Focerqc/QFBMS/exports/README.md

# Generated outputs

Regenerate previews and ERC/DRC reports from the current KiCad files here. Outputs are ignored; old exports were archived locally during migration.
