Focerqc/QFBMS/docs/bq-iso-i2c-2026-11-03.md

# Upper I2C isolation schematic increment — November 3, 2026

Charge-only schematic increment for the ISO1640 upper-I2C barrier. The host-side disconnect is PENDING; the [repair note](bq-repair-2026-11-03.md) supersedes the original connectivity claims. Discharge protection is out of scope. There is no heatsink. This pass stops at the isolation sheet. The next package resolves the pending disconnect and address-verification contract; ESP32, host power and charge switching remain later increments. Do not draw a charge FET, USB, or CAN device here.

`qfbms32.kicad_pcb`, `qfbms32.kicad_sch`, and `qfbms32.kicad_pro` were not modified. No netlist was imported, no historical generator was run, and no zones were refilled. Sheets were regenerated from `_tools/gen_bq_monitor_sheets.py` with its tracked identity manifest.

## Files

Open `qfbms32-bq-monitors.kicad_pro`.

- `qfbms32-bq-monitors.kicad_sch` — root sheet with lower monitor, upper monitor, and upper I2C isolation.
- `qfbms32-bq-lower.kicad_sch` — lower monitor, `U_BQ1`, reference `CELL0`.
- `qfbms32-bq-upper.kicad_sch` — upper monitor, `U_BQ2`, reference `CELL16`.
- `qfbms32-bq-iso-i2c.kicad_sch` — this isolation sheet.

## ISO1640 pin map

`U_ISO` uses the ISO1640 8-pin D pin map from TI ISO1640 datasheet Table 5-1. It has no enable pin. The orderable suffix stays OPEN. Do not switch the symbol to the 16-DW pinout.

| Pin | Name | Domain |
| --- | --- | --- |
| 1 | VCC1 | Host side. Net `HOST_3V3`. |
| 2 | SDA1 | Isolator side of missing disconnect: `SDA_ISO_PENDING`. |
| 3 | SCL1 | Isolator side of missing disconnect: `SCL_ISO_PENDING`. |
| 4 | GND1 | `CELL0`. |
| 5 | GND2 | `CELL16`. |
| 6 | SCL2 | Upper BQ bus `SCL_BQ2`. |
| 7 | SDA2 | Upper BQ bus `SDA_BQ2`. |
| 8 | VCC2 | Upper REG1, brought out as `REG1_BQ2`. |

Side 1 faces the host (80 pF max). Side 2 faces the upper BQ bus (400 pF max). Each supply has its own 100 nF to its own ground, per ISO1640 section 9.2.1 (`C201` on `HOST_3V3`/`CELL0`, `C202` on `REG1_BQ2`/`CELL16`).

**CELL0 and CELL16 are not joined.** Do not join any upper net to lower SRP or SRN. GND1 is `CELL0`. GND2 is `CELL16`.

## GPIO9 reset and switch truth table

`R203` pulls `GPIO9` up to `HOST_3V3`. Value OPEN. `GPIO9` must be high at reset because GPIO9 low selects ESP32-C3 download mode. The ESP32 driver itself is a later sheet; this pull-up has to hold the net without it.

The two-terminal SPST placeholders were removed: they had no control pins. SDA_HOST and SCL_HOST end at visibly PENDING open stubs. SDA_ISO_PENDING and SCL_ISO_PENDING reach ISO1640 pins 2/3, respectively. Fresh XML proves separation on both paths. Upper communication is unavailable in this increment.

GPIO9 only reaches R203. No switch truth table is implemented. High=open / low=connected remains a future requirement, with manufacturer-verified pinout, powered-off isolation and 100 kHz suitability. Pull-ups on both disconnect sides, combined sink current, rise time and power sequencing remain OPEN.

The supplied C code logs a failed lower-address write and still drives GPIO9 low. A maintained adaptation must require successful lower communication at 0x10 before upper 0x08 admission, and handle repeated GPIO9 gating from Lisp. Supplied source is preserved.

Upper SDA and SCL pull-ups stay on the upper monitor sheet (`R120`, `R121` to `REG1_BQ2`). Side-1 pull-ups are on this sheet (`R201`, `R202` to `HOST_3V3`), value OPEN.

## ALERT_BQ2

`ALERT_BQ2` is brought onto the isolation sheet and stays on the upper side. The stub ends at an explicit no-connect. It is not tied to `CELL0`. Firmware does not consume upper ALERT. A unidirectional isolator for it stays OPEN; do not invent that part or conduct ALERT across the barrier.

## ERC

KiCad 10.0.6:

```text
kicad-cli sch erc --severity-all --format json --output exports/bq-iso-erc.json qfbms32-bq-monitors.kicad_sch
```

Historical pre-repair result: 41 warnings, zero errors. Current result: 43 warnings, zero errors, adding two unconnected-wire-endpoint warnings for the PENDING host stubs. See [repair verification](bq-repair-2026-11-03.md). The breakdown below records the historical baseline.

| Sheet | Warnings |
| --- | ---: |
| Root | 33 |
| Lower monitor | 3 |
| Upper monitor | 5 |
| Upper I2C isolation | 0 |

Warning classes:

- 30 `isolated_pin_label`. `CELL1`–`CELL15` and `CELL17`–`CELL31` each connect to one filter resistor. The harness is not part of this increment. `ALERT_BQ2` no longer appears in this class after the isolation-sheet no-connect was regenerated.
- 8 `pin_to_pin`. CFETOFF, DFETOFF, DDSG, and on the upper sheet also HDQ and DCHG, are tied to the local reference. The power flag that drives that reference is a power output, so ERC reports a bidirectional pin on a power-output net. The tie is the Table 16-3 unused-pin termination.
- 3 `lib_symbol_issues`. Embedded `qfbms:BQ7695202PFB` and `qfbms:ISO1640_D8` symbols. The project symbol library table has no `qfbms` entry. The symbols are stored in the sheets.

Ignored ERC checks in this KiCad configuration, not run as failures: single global label, four-way junction, SPICE model issue, and footprint-filter mismatch.

## OPEN items

A value is OPEN when the datasheet or the firmware interface does not fix it. No MPN was selected for any part invented on this sheet.

| Reference | What is open |
| --- | --- |
| U_ISO | ISO1640 orderable suffix. The 8-D pin map is fixed. The 16-DW package is not this symbol. |
| Missing SDA disconnect | PENDING; SPST removed. Verified device, control pinout, footprint, powered-off isolation and timing required. |
| Missing SCL disconnect | PENDING; same requirements as SDA. |
| R201 | Side-1 SDA pull-up to `HOST_3V3`. Resistance at 100 kHz. |
| R202 | Side-1 SCL pull-up to `HOST_3V3`. Resistance at 100 kHz. |
| R203 | GPIO9 reset pull-up to `HOST_3V3`. Value. |
| ALERT_BQ2 | Unidirectional isolator across the barrier. MPN is OPEN; do not invent it. The upper-side stub is terminated with a no-connect. |
| HOST_3V3 | Host 3.3 V rail. Driven on the later ESP32 / regulator sheet. |
| GPIO9 | Driven by the later ESP32 sheet. Held high here by R203 until then. |

## Working-file hashes after this pass

SHA-256 of the untouched working board files (must remain unchanged by this increment):

```text
44045B287D223FA48AD0C9864A69A794FBC2407EDBB3922745E9A5B46DB71E8E  qfbms32.kicad_pcb
C8B17E5AA0936D8FFA2D0C3B4535BE0B898064DC0976F2ABD4436C4A3B704603  qfbms32.kicad_sch
0F84F61398BD25215ADA1A9C53ABE8C4E0F80B3B613C16E2D02F656B900CFED2  qfbms32.kicad_pro
```
