Focerqc/QFBMS/docs/review-2026-11-04/main-reconciliation.md

# Main schematic reconciliation

Read-only XML from the main schematic. Pin numbers refer to symbols, not inferred PCB pads.
Both BQs match by reference and role. Each line gives monitor and main peer sets including the pin itself. Different filter reference names require mapping through the actual cell index before migration.
Main Q1 is a power-switch reference collision, not the monitor preregulator. U205 is a logical host port, not a package.
Monitor references absent by name in main: C1, C10, C101, C102, C103, C104, C105, C106, C107, C108, C109, C11, C110, C111, C112, C113, C114, C115, C116, C117, C118, C119, C12, C120, C121, C122, C13, C14, C15, C16, C17, C18, C19, C2, C20, C201, C202, C203, C21, C22, C23, C3, C4, C5, C6, C7, C8, C9, D1, D101, D102, D2, Q101, R1, R10, R101, R102, R103, R104, R105, R106, R107, R108, R109, R11, R110, R111, R112, R113, R114, R115, R116, R117, R118, R119, R12, R120, R121, R122, R123, R124, R13, R14, R15, R16, R17, R18, R19, R2, R20, R201, R202, R203, R21, R22, R23, R24, R25, R26, R27, R28, R29, R3, R30, R31, R4, R5, R6, R7, R8, R9, RT1, RT2, RT3, RT4, RT5, R_SH, U204, U205, U_ISO
Map R_F and C_F cell-by-cell. Add admission, isolation, local supplies, decoupling, TS2 ports and independent upper current ties only after review. Keep physical harness/bleed placement fixed.
Main joins both BQ grounds, SDA, SCL, SRP and SRN across domains. Separate those nets and supply returns. Preserve genuine NC pin intent. Reconcile the main BQ exposed pads against the footprint separately.

## U_BQ1
- U_BQ1.1 (review differing peers) — draft /Lower monitor/VCF15 [C1.2 C2.1 R16.2 U_BQ1.1]; main /BQ1_VC15 [C_F15.2 C_F16.1 R_F18.1 U_BQ1.1]
- U_BQ1.2 (review differing peers) — draft /Lower monitor/VCF14 [C2.2 C3.1 R15.2 U_BQ1.2]; main /BQ1_VC14 [C_F14.2 C_F15.1 R_F19.1 U_BQ1.2]
- U_BQ1.3 (review differing peers) — draft /Lower monitor/VCF13 [C3.2 C4.1 R14.2 U_BQ1.3]; main /BQ1_VC13 [C_F13.2 C_F14.1 R_F20.1 U_BQ1.3]
- U_BQ1.4 (review differing peers) — draft /Lower monitor/VCF12 [C4.2 C5.1 R13.2 U_BQ1.4]; main /BQ1_VC12 [C_F12.2 C_F13.1 R_F21.1 U_BQ1.4]
- U_BQ1.5 (review differing peers) — draft /Lower monitor/VCF11 [C5.2 C6.1 R12.2 U_BQ1.5]; main /BQ1_VC11 [C_F11.2 C_F12.1 R_F22.1 U_BQ1.5]
- U_BQ1.6 (review differing peers) — draft /Lower monitor/VCF10 [C6.2 C7.1 R11.2 U_BQ1.6]; main /BQ1_VC10 [C_F10.2 C_F11.1 R_F23.1 U_BQ1.6]
- U_BQ1.7 (review differing peers) — draft /Lower monitor/VCF9 [C7.2 C8.1 R10.2 U_BQ1.7]; main /BQ1_VC9 [C_F10.1 C_F9.2 R_F24.1 U_BQ1.7]
- U_BQ1.8 (review differing peers) — draft /Lower monitor/VCF8 [C8.2 C9.1 R9.2 U_BQ1.8]; main /BQ1_VC8 [C_F8.2 C_F9.1 R_F25.1 U_BQ1.8]
- U_BQ1.9 (review differing peers) — draft /Lower monitor/VCF7 [C10.1 C9.2 R8.2 U_BQ1.9]; main /BQ1_VC7 [C_F7.2 C_F8.1 R_F26.1 U_BQ1.9]
- U_BQ1.10 (review differing peers) — draft /Lower monitor/VCF6 [C10.2 C11.1 R7.2 U_BQ1.10]; main /BQ1_VC6 [C_F6.2 C_F7.1 R_F27.1 U_BQ1.10]
- U_BQ1.11 (review differing peers) — draft /Lower monitor/VCF5 [C11.2 C12.1 R6.2 U_BQ1.11]; main /BQ1_VC5 [C_F5.2 C_F6.1 R_F28.1 U_BQ1.11]
- U_BQ1.12 (review differing peers) — draft /Lower monitor/VCF4 [C12.2 C13.1 R5.2 U_BQ1.12]; main /BQ1_VC4 [C_F4.2 C_F5.1 R_F29.1 U_BQ1.12]
- U_BQ1.13 (review differing peers) — draft /Lower monitor/VCF3 [C13.2 C14.1 R4.2 U_BQ1.13]; main /BQ1_VC3 [C_F3.2 C_F4.1 R_F30.1 U_BQ1.13]
- U_BQ1.14 (review differing peers) — draft /Lower monitor/VCF2 [C14.2 C15.1 R3.2 U_BQ1.14]; main /BQ1_VC2 [C_F2.2 C_F3.1 R_F31.1 U_BQ1.14]
- U_BQ1.15 (review differing peers) — draft /Lower monitor/VCF1 [C15.2 C16.1 R2.2 U_BQ1.15]; main /BQ1_VC1 [C_F1.2 C_F2.1 R_F32.1 U_BQ1.15]
- U_BQ1.16 (review differing peers) — draft /Lower monitor/VCF0 [C16.2 C17.1 R1.2 U_BQ1.16]; main /CELL0 [C_F1.1 J_BAT1.2 J_CELL1.10 R_SH1.1 U_BQ1.16]
- U_BQ1.17 (review differing peers) — draft CELL0 [C17.2 C18.2 C19.2 C20.2 C201.1 C203.1 C21.2 C22.2 R1.1 R19.2 R23.1 R25.1 RT1.2 RT2.2 RT3.2 RT4.2 RT5.2 R_SH.1 U204.1 U204.5 U_BQ1.17 U_BQ1.29 U_BQ1.30 U_BQ1.32 U_BQ1.49 U_ISO.4]; main /GND [C_SSR1.2 C_SSR2.2 J_T1.2 J_T2.2 J_T3.2 J_T4.2 R_SSR2.2 U_BQ1.17 U_BQ1.33 U_BQ2.17 U_BQ2.33 U_SSR1.4]
- U_BQ1.18 (review differing peers) — draft /Lower monitor/SRP_NET [C23.1 R25.2 U_BQ1.18]; main /SRP [U_BQ1.18 U_BQ2.18]
- U_BQ1.19 (same member set) — draft unconnected-(U_BQ1-NC-Pad19) [U_BQ1.19]; main unconnected-(U_BQ1-NC-Pad19) [U_BQ1.19]
- U_BQ1.20 (review differing peers) — draft /Lower monitor/SRN_NET [C23.2 R26.2 U_BQ1.20]; main /SRN [U_BQ1.20 U_BQ2.20]
- U_BQ1.21 (review differing peers) — draft /Lower monitor/TS1_NTC [R27.1 U_BQ1.21]; main /TS1 [J_T1.1 U_BQ1.21]
- U_BQ1.22 (review differing peers) — draft /Lower monitor/TS2_WAKE_BQ1 [U_BQ1.22]; main /TS2 [J_T2.1 U_BQ1.22]
- U_BQ1.23 (review differing peers) — draft /Lower monitor/TS3_NTC [R28.1 U_BQ1.23]; main /TS3 [J_T3.1 U_BQ1.23]
- U_BQ1.24 (review differing peers) — draft /Lower monitor/REG18 [C21.1 U_BQ1.24]; main unconnected-(U_BQ1-REG18-Pad24) [U_BQ1.24]
- U_BQ1.25 (review differing peers) — draft /Lower monitor/ALERT_NTC [R29.1 U_BQ1.25]; main unconnected-(U_BQ1-HDQ_IO/ALERT-Pad25) [U_BQ1.25]
- U_BQ1.26 (review differing peers) — draft /Lower monitor/SCL_BQ1 [R21.1 U_BQ1.26]; main /I2C_SCL [U_BQ1.26 U_BQ2.26]
- U_BQ1.27 (review differing peers) — draft /Lower monitor/SDA_BQ1 [R20.1 U_BQ1.27]; main /I2C_SDA [U_BQ1.27 U_BQ2.27 U_ESP1.21]
- U_BQ1.28 (review differing peers) — draft /Lower monitor/HDQ_NTC [R31.1 U_BQ1.28]; main unconnected-(U_BQ1-HDQ_IO/SPI_MOSI-Pad28) [U_BQ1.28]
- U_BQ1.29 (review differing peers) — draft CELL0 [C17.2 C18.2 C19.2 C20.2 C201.1 C203.1 C21.2 C22.2 R1.1 R19.2 R23.1 R25.1 RT1.2 RT2.2 RT3.2 RT4.2 RT5.2 R_SH.1 U204.1 U204.5 U_BQ1.17 U_BQ1.29 U_BQ1.30 U_BQ1.32 U_BQ1.49 U_ISO.4]; main unconnected-(U_BQ1-CFETOFF/SPI_CS-Pad29) [U_BQ1.29]
- U_BQ1.30 (review differing peers) — draft CELL0 [C17.2 C18.2 C19.2 C20.2 C201.1 C203.1 C21.2 C22.2 R1.1 R19.2 R23.1 R25.1 RT1.2 RT2.2 RT3.2 RT4.2 RT5.2 R_SH.1 U204.1 U204.5 U_BQ1.17 U_BQ1.29 U_BQ1.30 U_BQ1.32 U_BQ1.49 U_ISO.4]; main unconnected-(U_BQ1-DFETOFF/BOTHOFF-Pad30) [U_BQ1.30]
- U_BQ1.31 (review differing peers) — draft /Lower monitor/DCHG_NTC [R30.1 U_BQ1.31]; main unconnected-(U_BQ1-DCHG-Pad31) [U_BQ1.31]
- U_BQ1.32 (review differing peers) — draft CELL0 [C17.2 C18.2 C19.2 C20.2 C201.1 C203.1 C21.2 C22.2 R1.1 R19.2 R23.1 R25.1 RT1.2 RT2.2 RT3.2 RT4.2 RT5.2 R_SH.1 U204.1 U204.5 U_BQ1.17 U_BQ1.29 U_BQ1.30 U_BQ1.32 U_BQ1.49 U_ISO.4]; main unconnected-(U_BQ1-DDSG-Pad32) [U_BQ1.32]
- U_BQ1.33 (review differing peers) — draft /Lower monitor/RST_SHUT_BQ1 [R23.2 U_BQ1.33]; main /GND [C_SSR1.2 C_SSR2.2 J_T1.2 J_T2.2 J_T3.2 J_T4.2 R_SSR2.2 U_BQ1.17 U_BQ1.33 U_BQ2.17 U_BQ2.33 U_SSR1.4]
- U_BQ1.34 (same member set) — draft unconnected-(U_BQ1-REG2-Pad34) [U_BQ1.34]; main unconnected-(U_BQ1-REG2-Pad34) [U_BQ1.34]
- U_BQ1.35 (review differing peers) — draft /Lower monitor/REG1_BQ1 [C22.1 R20.2 R21.2 U_BQ1.35]; main unconnected-(U_BQ1-REG1-Pad35) [U_BQ1.35]
- U_BQ1.36 (review differing peers) — draft /Lower monitor/REGIN [C20.1 Q1.3 U_BQ1.36]; main unconnected-(U_BQ1-REGIN-Pad36) [U_BQ1.36]
- U_BQ1.37 (review differing peers) — draft /Lower monitor/BREG [Q1.1 R19.1 U_BQ1.37]; main unconnected-(U_BQ1-BREG-Pad37) [U_BQ1.37]
- U_BQ1.38 (same member set) — draft unconnected-(U_BQ1-FUSE-Pad38) [U_BQ1.38]; main unconnected-(U_BQ1-FUSE-Pad38) [U_BQ1.38]
- U_BQ1.39 (same member set) — draft unconnected-(U_BQ1-PDSG-Pad39) [U_BQ1.39]; main unconnected-(U_BQ1-PDSG-Pad39) [U_BQ1.39]
- U_BQ1.40 (same member set) — draft unconnected-(U_BQ1-PCHG-Pad40) [U_BQ1.40]; main unconnected-(U_BQ1-PCHG-Pad40) [U_BQ1.40]
- U_BQ1.41 (review differing peers) — draft /Lower monitor/LD_PIN [R24.1 U_BQ1.41]; main unconnected-(U_BQ1-LD-Pad41) [U_BQ1.41]
- U_BQ1.42 (review differing peers) — draft /Lower monitor/PACK_PIN [R22.1 U_BQ1.42]; main unconnected-(U_BQ1-PACK-Pad42) [U_BQ1.42]
- U_BQ1.43 (same member set) — draft unconnected-(U_BQ1-DSG-Pad43) [U_BQ1.43]; main unconnected-(U_BQ1-DSG-Pad43) [U_BQ1.43]
- U_BQ1.44 (same member set) — draft unconnected-(U_BQ1-NC-Pad44) [U_BQ1.44]; main unconnected-(U_BQ1-NC-Pad44) [U_BQ1.44]
- U_BQ1.45 (same member set) — draft unconnected-(U_BQ1-CHG-Pad45) [U_BQ1.45]; main unconnected-(U_BQ1-CHG-Pad45) [U_BQ1.45]
- U_BQ1.46 (review differing peers) — draft /Lower monitor/BAT_PIN [C18.1 C19.1 R18.2 U_BQ1.46 U_BQ1.47]; main unconnected-(U_BQ1-CP1-Pad46) [U_BQ1.46]
- U_BQ1.47 (review differing peers) — draft /Lower monitor/BAT_PIN [C18.1 C19.1 R18.2 U_BQ1.46 U_BQ1.47]; main /BQ1_VC16 [C_F16.2 R_F17.1 U_BQ1.47 U_BQ1.48]
- U_BQ1.48 (review differing peers) — draft /Lower monitor/VCF16 [C1.1 R17.2 U_BQ1.48]; main /BQ1_VC16 [C_F16.2 R_F17.1 U_BQ1.47 U_BQ1.48]
- U_BQ1.49 (pin absent from one export) — draft CELL0 [C17.2 C18.2 C19.2 C20.2 C201.1 C203.1 C21.2 C22.2 R1.1 R19.2 R23.1 R25.1 RT1.2 RT2.2 RT3.2 RT4.2 RT5.2 R_SH.1 U204.1 U204.5 U_BQ1.17 U_BQ1.29 U_BQ1.30 U_BQ1.32 U_BQ1.49 U_ISO.4]; main absent []
## U_BQ2
- U_BQ2.1 (review differing peers) — draft /Upper monitor/VCF15 [C101.2 C102.1 R116.2 U_BQ2.1]; main /BQ2_VC15 [C_F31.2 C_F32.1 R_F2.1 U_BQ2.1]
- U_BQ2.2 (review differing peers) — draft /Upper monitor/VCF14 [C102.2 C103.1 R115.2 U_BQ2.2]; main /BQ2_VC14 [C_F30.2 C_F31.1 R_F3.1 U_BQ2.2]
- U_BQ2.3 (review differing peers) — draft /Upper monitor/VCF13 [C103.2 C104.1 R114.2 U_BQ2.3]; main /BQ2_VC13 [C_F29.2 C_F30.1 R_F4.1 U_BQ2.3]
- U_BQ2.4 (review differing peers) — draft /Upper monitor/VCF12 [C104.2 C105.1 R113.2 U_BQ2.4]; main /BQ2_VC12 [C_F28.2 C_F29.1 R_F5.1 U_BQ2.4]
- U_BQ2.5 (review differing peers) — draft /Upper monitor/VCF11 [C105.2 C106.1 R112.2 U_BQ2.5]; main /BQ2_VC11 [C_F27.2 C_F28.1 R_F6.1 U_BQ2.5]
- U_BQ2.6 (review differing peers) — draft /Upper monitor/VCF10 [C106.2 C107.1 R111.2 U_BQ2.6]; main /BQ2_VC10 [C_F26.2 C_F27.1 R_F7.1 U_BQ2.6]
- U_BQ2.7 (review differing peers) — draft /Upper monitor/VCF9 [C107.2 C108.1 R110.2 U_BQ2.7]; main /BQ2_VC9 [C_F25.2 C_F26.1 R_F8.1 U_BQ2.7]
- U_BQ2.8 (review differing peers) — draft /Upper monitor/VCF8 [C108.2 C109.1 R109.2 U_BQ2.8]; main /BQ2_VC8 [C_F24.2 C_F25.1 R_F9.1 U_BQ2.8]
- U_BQ2.9 (review differing peers) — draft /Upper monitor/VCF7 [C109.2 C110.1 R108.2 U_BQ2.9]; main /BQ2_VC7 [C_F23.2 C_F24.1 R_F10.1 U_BQ2.9]
- U_BQ2.10 (review differing peers) — draft /Upper monitor/VCF6 [C110.2 C111.1 R107.2 U_BQ2.10]; main /BQ2_VC6 [C_F22.2 C_F23.1 R_F11.1 U_BQ2.10]
- U_BQ2.11 (review differing peers) — draft /Upper monitor/VCF5 [C111.2 C112.1 R106.2 U_BQ2.11]; main /BQ2_VC5 [C_F21.2 C_F22.1 R_F12.1 U_BQ2.11]
- U_BQ2.12 (review differing peers) — draft /Upper monitor/VCF4 [C112.2 C113.1 R105.2 U_BQ2.12]; main /BQ2_VC4 [C_F20.2 C_F21.1 R_F13.1 U_BQ2.12]
- U_BQ2.13 (review differing peers) — draft /Upper monitor/VCF3 [C113.2 C114.1 R104.2 U_BQ2.13]; main /BQ2_VC3 [C_F19.2 C_F20.1 R_F14.1 U_BQ2.13]
- U_BQ2.14 (review differing peers) — draft /Upper monitor/VCF2 [C114.2 C115.1 R103.2 U_BQ2.14]; main /BQ2_VC2 [C_F18.2 C_F19.1 R_F15.1 U_BQ2.14]
- U_BQ2.15 (review differing peers) — draft /Upper monitor/VCF1 [C115.2 C116.1 R102.2 U_BQ2.15]; main /BQ2_VC1 [C_F17.2 C_F18.1 R_F16.1 U_BQ2.15]
- U_BQ2.16 (review differing peers) — draft /Upper monitor/VCF0 [C116.2 C117.1 R101.2 U_BQ2.16]; main /CELL16 [C_F17.1 J_CELL2.3 R_F17.2 U_BQ2.16]
- U_BQ2.17 (review differing peers) — draft CELL16 [C117.2 C118.2 C119.2 C120.2 C121.2 C122.2 C202.1 D1.2 D2.2 R101.1 R119.2 R123.1 R17.1 R22.2 U_BQ2.17 U_BQ2.18 U_BQ2.20 U_BQ2.21 U_BQ2.23 U_BQ2.28 U_BQ2.29 U_BQ2.30 U_BQ2.31 U_BQ2.32 U_BQ2.49 U_ISO.5]; main /GND [C_SSR1.2 C_SSR2.2 J_T1.2 J_T2.2 J_T3.2 J_T4.2 R_SSR2.2 U_BQ1.17 U_BQ1.33 U_BQ2.17 U_BQ2.33 U_SSR1.4]
- U_BQ2.18 (review differing peers) — draft CELL16 [C117.2 C118.2 C119.2 C120.2 C121.2 C122.2 C202.1 D1.2 D2.2 R101.1 R119.2 R123.1 R17.1 R22.2 U_BQ2.17 U_BQ2.18 U_BQ2.20 U_BQ2.21 U_BQ2.23 U_BQ2.28 U_BQ2.29 U_BQ2.30 U_BQ2.31 U_BQ2.32 U_BQ2.49 U_ISO.5]; main /SRP [U_BQ1.18 U_BQ2.18]
- U_BQ2.19 (same member set) — draft unconnected-(U_BQ2-NC-Pad19) [U_BQ2.19]; main unconnected-(U_BQ2-NC-Pad19) [U_BQ2.19]
- U_BQ2.20 (review differing peers) — draft CELL16 [C117.2 C118.2 C119.2 C120.2 C121.2 C122.2 C202.1 D1.2 D2.2 R101.1 R119.2 R123.1 R17.1 R22.2 U_BQ2.17 U_BQ2.18 U_BQ2.20 U_BQ2.21 U_BQ2.23 U_BQ2.28 U_BQ2.29 U_BQ2.30 U_BQ2.31 U_BQ2.32 U_BQ2.49 U_ISO.5]; main /SRN [U_BQ1.20 U_BQ2.20]
- U_BQ2.21 (review differing peers) — draft CELL16 [C117.2 C118.2 C119.2 C120.2 C121.2 C122.2 C202.1 D1.2 D2.2 R101.1 R119.2 R123.1 R17.1 R22.2 U_BQ2.17 U_BQ2.18 U_BQ2.20 U_BQ2.21 U_BQ2.23 U_BQ2.28 U_BQ2.29 U_BQ2.30 U_BQ2.31 U_BQ2.32 U_BQ2.49 U_ISO.5]; main /TS4 [J_T4.1 U_BQ2.21]
- U_BQ2.22 (same member set) — draft /Upper monitor/TS2_WAKE_BQ2 [U_BQ2.22]; main unconnected-(U_BQ2-TS2/WAKE-Pad22) [U_BQ2.22]
- U_BQ2.23 (review differing peers) — draft CELL16 [C117.2 C118.2 C119.2 C120.2 C121.2 C122.2 C202.1 D1.2 D2.2 R101.1 R119.2 R123.1 R17.1 R22.2 U_BQ2.17 U_BQ2.18 U_BQ2.20 U_BQ2.21 U_BQ2.23 U_BQ2.28 U_BQ2.29 U_BQ2.30 U_BQ2.31 U_BQ2.32 U_BQ2.49 U_ISO.5]; main unconnected-(U_BQ2-TS3-Pad23) [U_BQ2.23]
- U_BQ2.24 (review differing peers) — draft /Upper monitor/REG18 [C121.1 U_BQ2.24]; main unconnected-(U_BQ2-REG18-Pad24) [U_BQ2.24]
- U_BQ2.25 (same member set) — draft /Upper I2C isolation/ALERT_BQ2 [U_BQ2.25]; main unconnected-(U_BQ2-HDQ_IO/ALERT-Pad25) [U_BQ2.25]
- U_BQ2.26 (review differing peers) — draft /Upper I2C isolation/SCL_BQ2 [R121.1 U_BQ2.26 U_ISO.6]; main /I2C_SCL [U_BQ1.26 U_BQ2.26]
- U_BQ2.27 (review differing peers) — draft /Upper I2C isolation/SDA_BQ2 [R120.1 U_BQ2.27 U_ISO.7]; main /I2C_SDA [U_BQ1.27 U_BQ2.27 U_ESP1.21]
- U_BQ2.28 (review differing peers) — draft CELL16 [C117.2 C118.2 C119.2 C120.2 C121.2 C122.2 C202.1 D1.2 D2.2 R101.1 R119.2 R123.1 R17.1 R22.2 U_BQ2.17 U_BQ2.18 U_BQ2.20 U_BQ2.21 U_BQ2.23 U_BQ2.28 U_BQ2.29 U_BQ2.30 U_BQ2.31 U_BQ2.32 U_BQ2.49 U_ISO.5]; main unconnected-(U_BQ2-HDQ_IO/SPI_MOSI-Pad28) [U_BQ2.28]
- U_BQ2.29 (review differing peers) — draft CELL16 [C117.2 C118.2 C119.2 C120.2 C121.2 C122.2 C202.1 D1.2 D2.2 R101.1 R119.2 R123.1 R17.1 R22.2 U_BQ2.17 U_BQ2.18 U_BQ2.20 U_BQ2.21 U_BQ2.23 U_BQ2.28 U_BQ2.29 U_BQ2.30 U_BQ2.31 U_BQ2.32 U_BQ2.49 U_ISO.5]; main unconnected-(U_BQ2-CFETOFF/SPI_CS-Pad29) [U_BQ2.29]
- U_BQ2.30 (review differing peers) — draft CELL16 [C117.2 C118.2 C119.2 C120.2 C121.2 C122.2 C202.1 D1.2 D2.2 R101.1 R119.2 R123.1 R17.1 R22.2 U_BQ2.17 U_BQ2.18 U_BQ2.20 U_BQ2.21 U_BQ2.23 U_BQ2.28 U_BQ2.29 U_BQ2.30 U_BQ2.31 U_BQ2.32 U_BQ2.49 U_ISO.5]; main unconnected-(U_BQ2-DFETOFF/BOTHOFF-Pad30) [U_BQ2.30]
- U_BQ2.31 (review differing peers) — draft CELL16 [C117.2 C118.2 C119.2 C120.2 C121.2 C122.2 C202.1 D1.2 D2.2 R101.1 R119.2 R123.1 R17.1 R22.2 U_BQ2.17 U_BQ2.18 U_BQ2.20 U_BQ2.21 U_BQ2.23 U_BQ2.28 U_BQ2.29 U_BQ2.30 U_BQ2.31 U_BQ2.32 U_BQ2.49 U_ISO.5]; main unconnected-(U_BQ2-DCHG-Pad31) [U_BQ2.31]
- U_BQ2.32 (review differing peers) — draft CELL16 [C117.2 C118.2 C119.2 C120.2 C121.2 C122.2 C202.1 D1.2 D2.2 R101.1 R119.2 R123.1 R17.1 R22.2 U_BQ2.17 U_BQ2.18 U_BQ2.20 U_BQ2.21 U_BQ2.23 U_BQ2.28 U_BQ2.29 U_BQ2.30 U_BQ2.31 U_BQ2.32 U_BQ2.49 U_ISO.5]; main unconnected-(U_BQ2-DDSG-Pad32) [U_BQ2.32]
- U_BQ2.33 (review differing peers) — draft /Upper monitor/RST_SHUT_BQ2 [R123.2 U_BQ2.33]; main /GND [C_SSR1.2 C_SSR2.2 J_T1.2 J_T2.2 J_T3.2 J_T4.2 R_SSR2.2 U_BQ1.17 U_BQ1.33 U_BQ2.17 U_BQ2.33 U_SSR1.4]
- U_BQ2.34 (same member set) — draft unconnected-(U_BQ2-REG2-Pad34) [U_BQ2.34]; main unconnected-(U_BQ2-REG2-Pad34) [U_BQ2.34]
- U_BQ2.35 (review differing peers) — draft /Upper I2C isolation/REG1_BQ2 [C122.1 C202.2 R120.2 R121.2 U_BQ2.35 U_ISO.8]; main unconnected-(U_BQ2-REG1-Pad35) [U_BQ2.35]
- U_BQ2.36 (review differing peers) — draft /Upper monitor/REGIN [C120.1 Q101.3 U_BQ2.36]; main unconnected-(U_BQ2-REGIN-Pad36) [U_BQ2.36]
- U_BQ2.37 (review differing peers) — draft /Upper monitor/BREG [Q101.1 R119.1 U_BQ2.37]; main unconnected-(U_BQ2-BREG-Pad37) [U_BQ2.37]
- U_BQ2.38 (same member set) — draft unconnected-(U_BQ2-FUSE-Pad38) [U_BQ2.38]; main unconnected-(U_BQ2-FUSE-Pad38) [U_BQ2.38]
- U_BQ2.39 (same member set) — draft unconnected-(U_BQ2-PDSG-Pad39) [U_BQ2.39]; main unconnected-(U_BQ2-PDSG-Pad39) [U_BQ2.39]
- U_BQ2.40 (same member set) — draft unconnected-(U_BQ2-PCHG-Pad40) [U_BQ2.40]; main unconnected-(U_BQ2-PCHG-Pad40) [U_BQ2.40]
- U_BQ2.41 (review differing peers) — draft /Upper monitor/LD_PIN [R124.1 U_BQ2.41]; main unconnected-(U_BQ2-LD-Pad41) [U_BQ2.41]
- U_BQ2.42 (review differing peers) — draft /Upper monitor/PACK_PIN [R122.1 U_BQ2.42]; main unconnected-(U_BQ2-PACK-Pad42) [U_BQ2.42]
- U_BQ2.43 (same member set) — draft unconnected-(U_BQ2-DSG-Pad43) [U_BQ2.43]; main unconnected-(U_BQ2-DSG-Pad43) [U_BQ2.43]
- U_BQ2.44 (same member set) — draft unconnected-(U_BQ2-NC-Pad44) [U_BQ2.44]; main unconnected-(U_BQ2-NC-Pad44) [U_BQ2.44]
- U_BQ2.45 (same member set) — draft unconnected-(U_BQ2-CHG-Pad45) [U_BQ2.45]; main unconnected-(U_BQ2-CHG-Pad45) [U_BQ2.45]
- U_BQ2.46 (review differing peers) — draft /Upper monitor/BAT_PIN [C118.1 C119.1 R118.2 U_BQ2.46 U_BQ2.47]; main unconnected-(U_BQ2-CP1-Pad46) [U_BQ2.46]
- U_BQ2.47 (review differing peers) — draft /Upper monitor/BAT_PIN [C118.1 C119.1 R118.2 U_BQ2.46 U_BQ2.47]; main /BQ2_VC16 [C_F32.2 R_F1.1 U_BQ2.47 U_BQ2.48]
- U_BQ2.48 (review differing peers) — draft /Upper monitor/VCF16 [C101.1 R117.2 U_BQ2.48]; main /BQ2_VC16 [C_F32.2 R_F1.1 U_BQ2.47 U_BQ2.48]
- U_BQ2.49 (pin absent from one export) — draft CELL16 [C117.2 C118.2 C119.2 C120.2 C121.2 C122.2 C202.1 D1.2 D2.2 R101.1 R119.2 R123.1 R17.1 R22.2 U_BQ2.17 U_BQ2.18 U_BQ2.20 U_BQ2.21 U_BQ2.23 U_BQ2.28 U_BQ2.29 U_BQ2.30 U_BQ2.31 U_BQ2.32 U_BQ2.49 U_ISO.5]; main absent []
