Focerqc/QFBMS/design/charge-control/render/charge-control-01 _ Charge path - reference AGM option.png

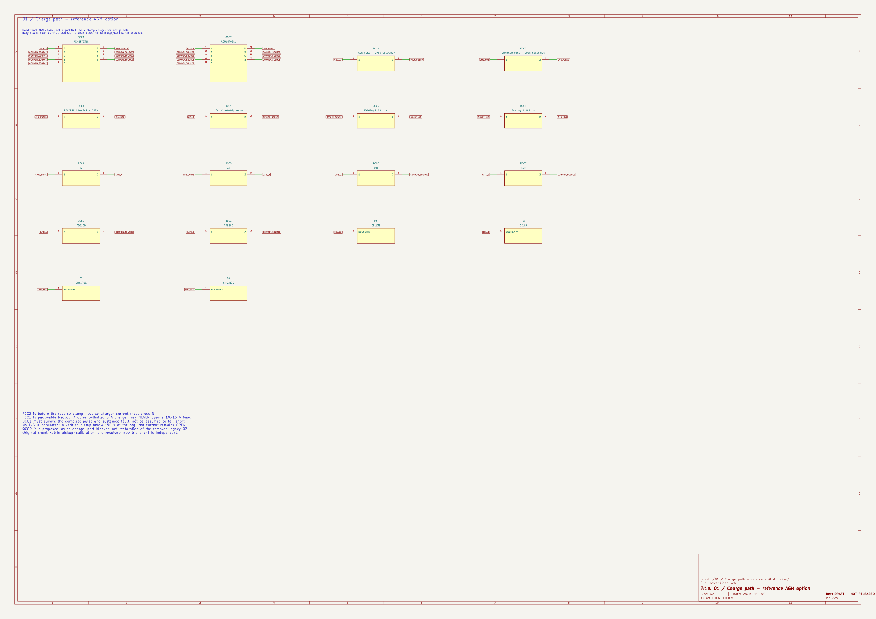
design/charge-control/render/charge-control-01 _ Charge path - reference AGM option.png
