Focerqc/QFBMS/design/charge-control/render/charge-control-02 _ Isolated gate drive.png

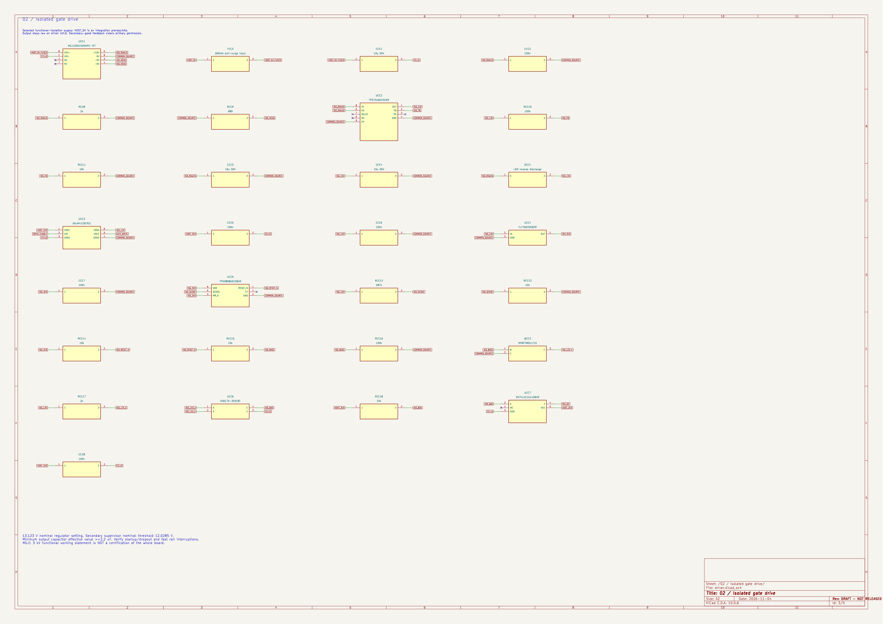
design/charge-control/render/charge-control-02 _ Isolated gate drive.png
