Focerqc/QFBMS/design/charge-control/render/charge-control-03 _ Watchdog and deliberate permission.png

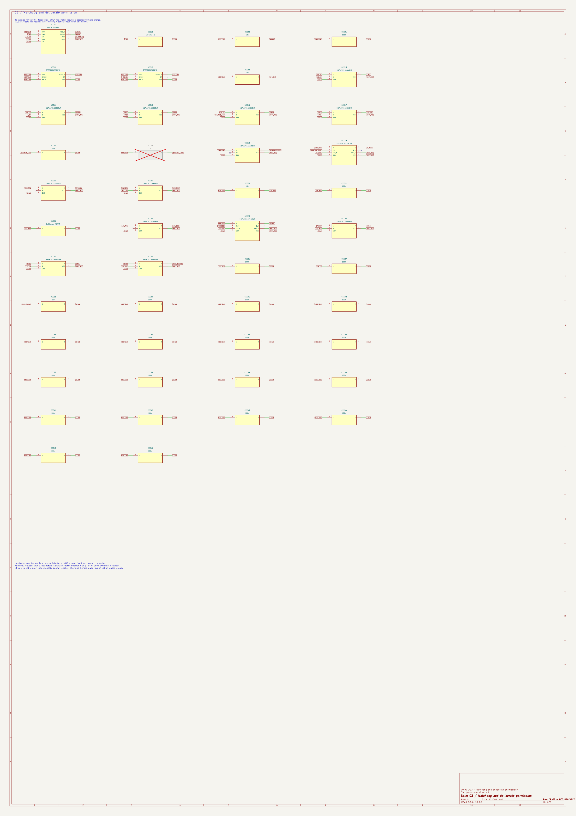
design/charge-control/render/charge-control-03 _ Watchdog and deliberate permission.png
