Focerqc/QFBMS/design/charge-control/render/charge-control-04 _ Hardware polarity and fast current window.png

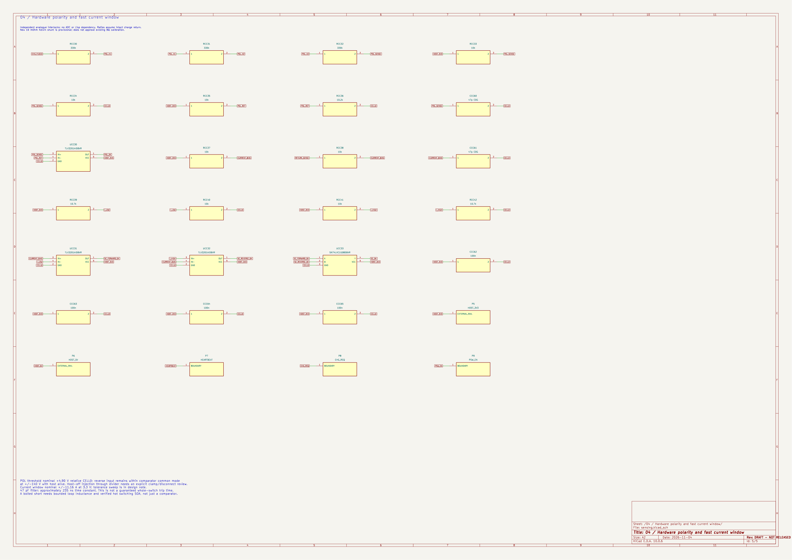
design/charge-control/render/charge-control-04 _ Hardware polarity and fast current window.png
