Focerqc/QFBMS/design/charge-control/render/charge-control.png

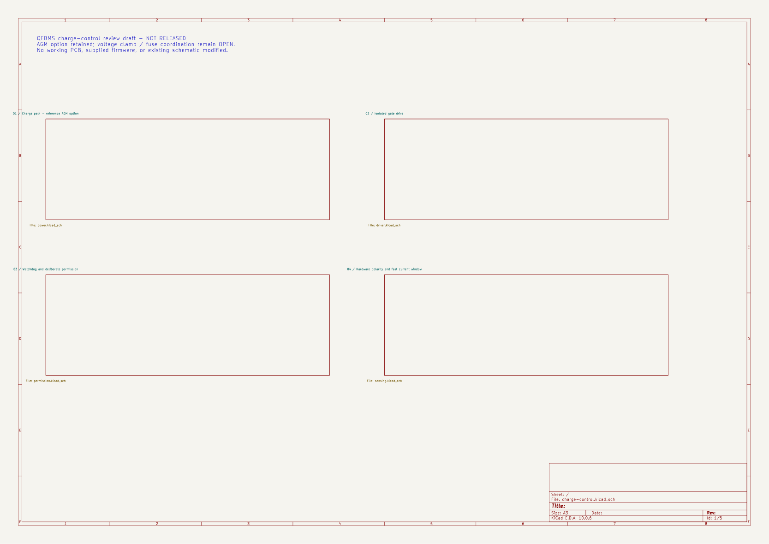
design/charge-control/render/charge-control.png
