Focerqc/QFBMS/docs/charge-control-2026-11-04/agm-pinout.png

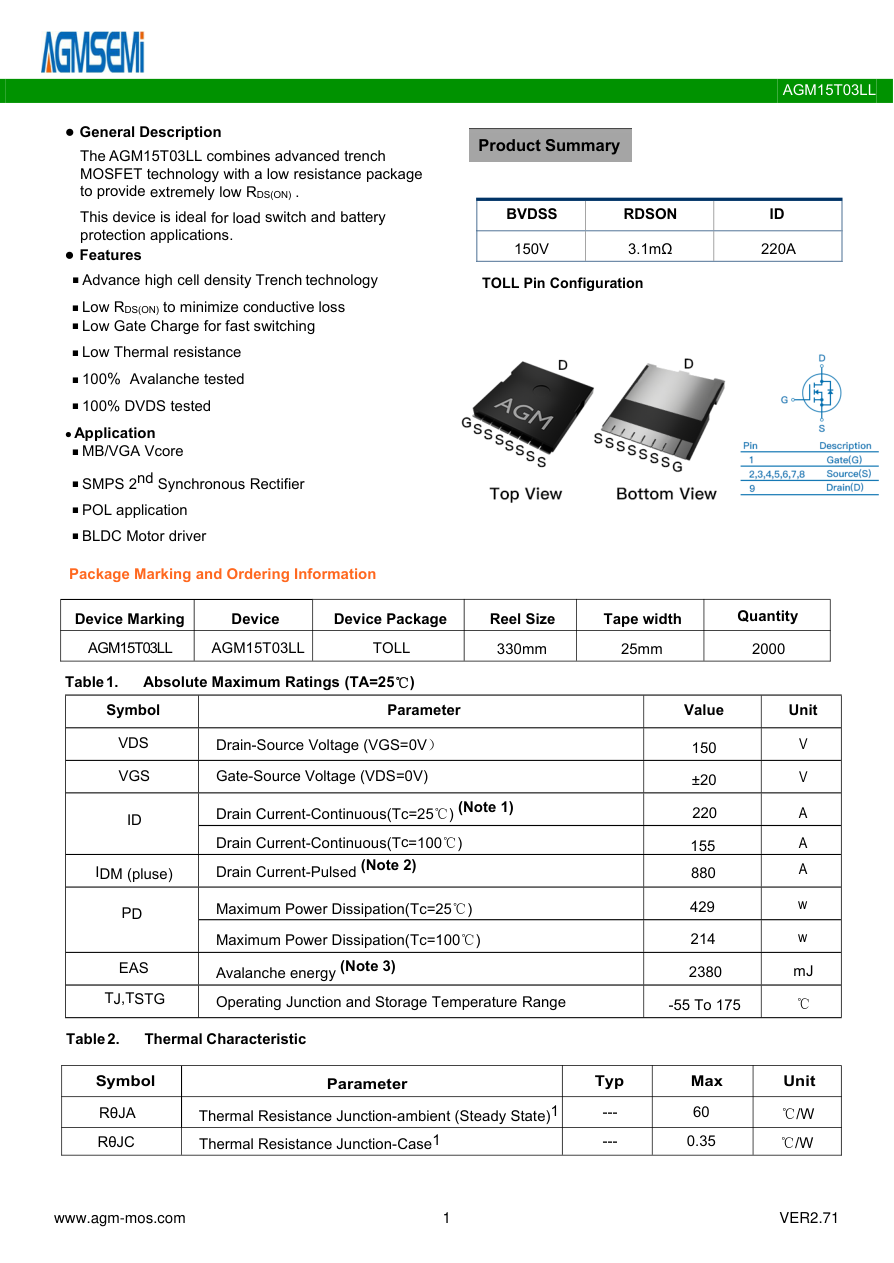
docs/charge-control-2026-11-04/agm-pinout.png
