Focerqc/QFBMS/docs/charge-control-2026-11-04/infineon-soa.png

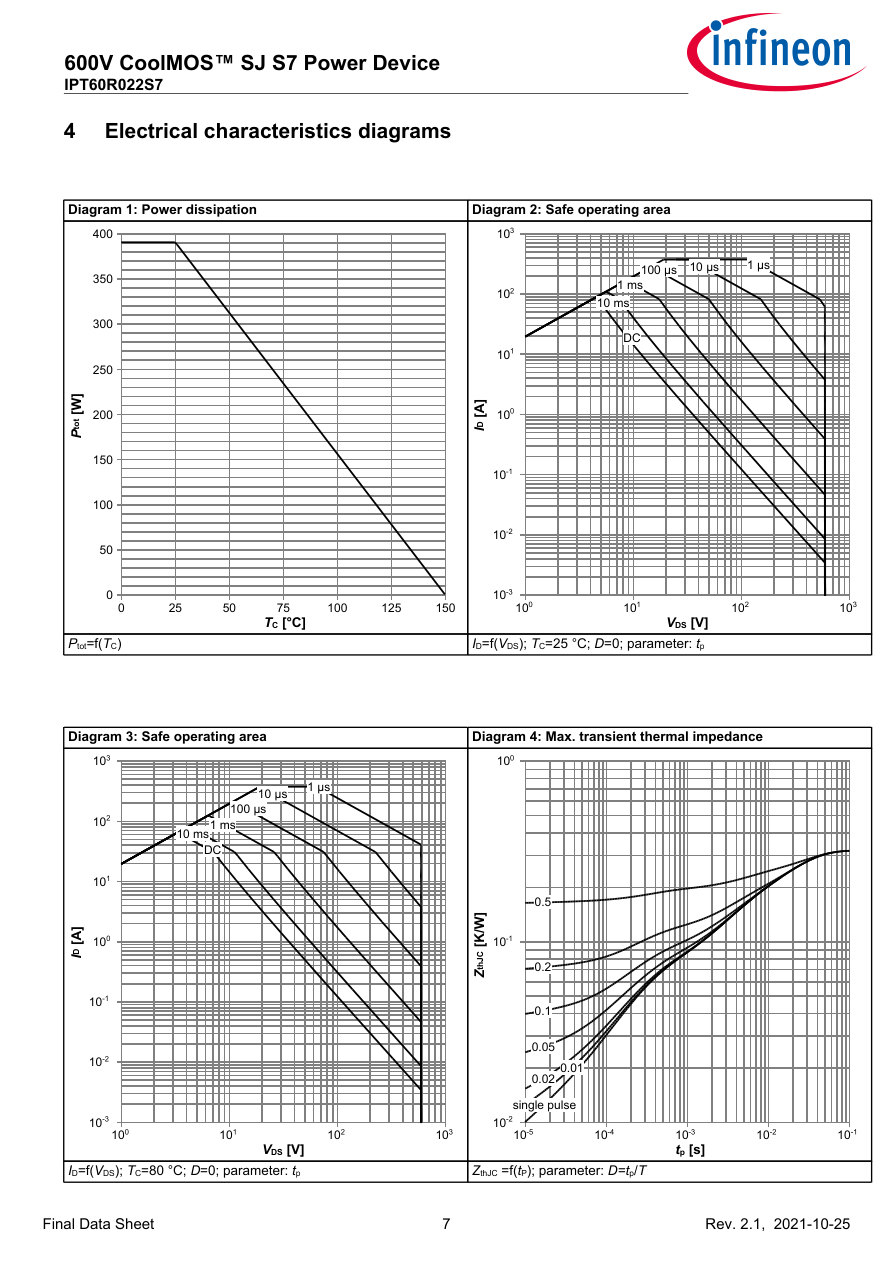
docs/charge-control-2026-11-04/infineon-soa.png
