Focerqc/QFBMS/docs/charge-control-2026-11-04/reference-overview.png

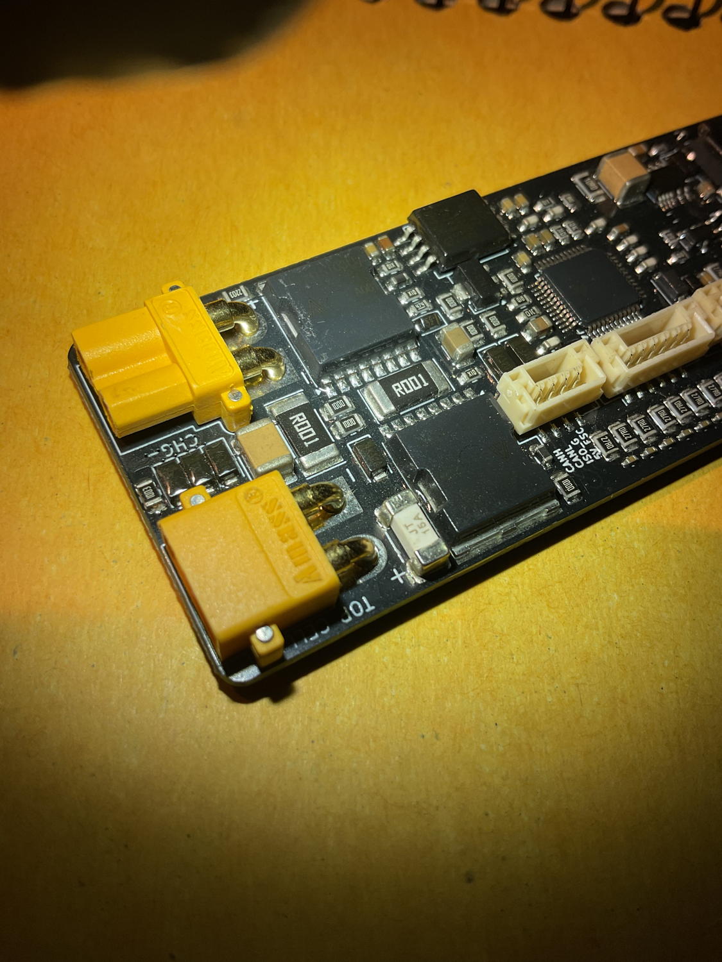
docs/charge-control-2026-11-04/reference-overview.png
