Focerqc/QFBMS/scratch/img_2143_center.jpg

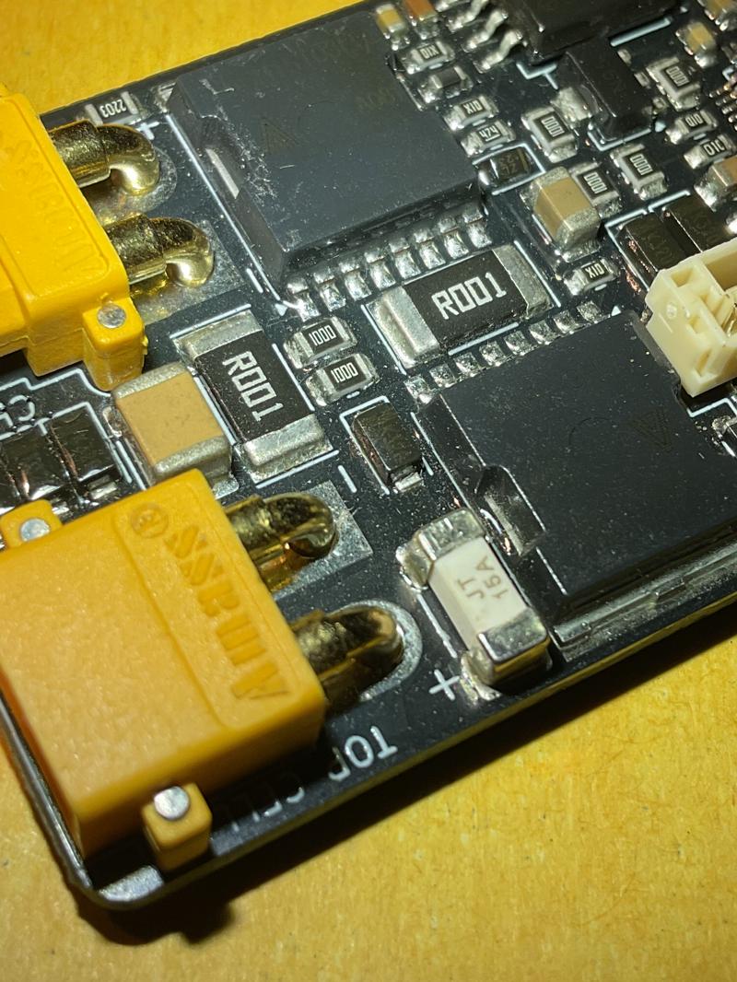
scratch/img_2143_center.jpg
