Focerqc/QFBMS/scratch/img_2143_center_fullres.jpg

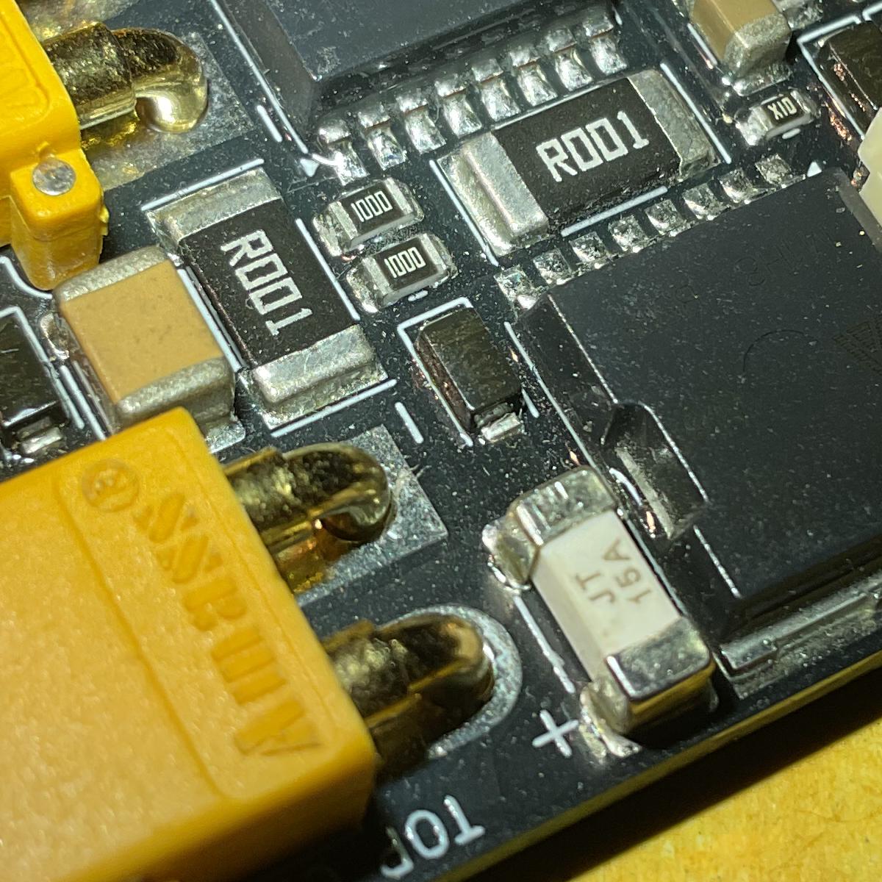
scratch/img_2143_center_fullres.jpg
