Focerqc/QFBMS/site/data/9c39aff29bfa.png

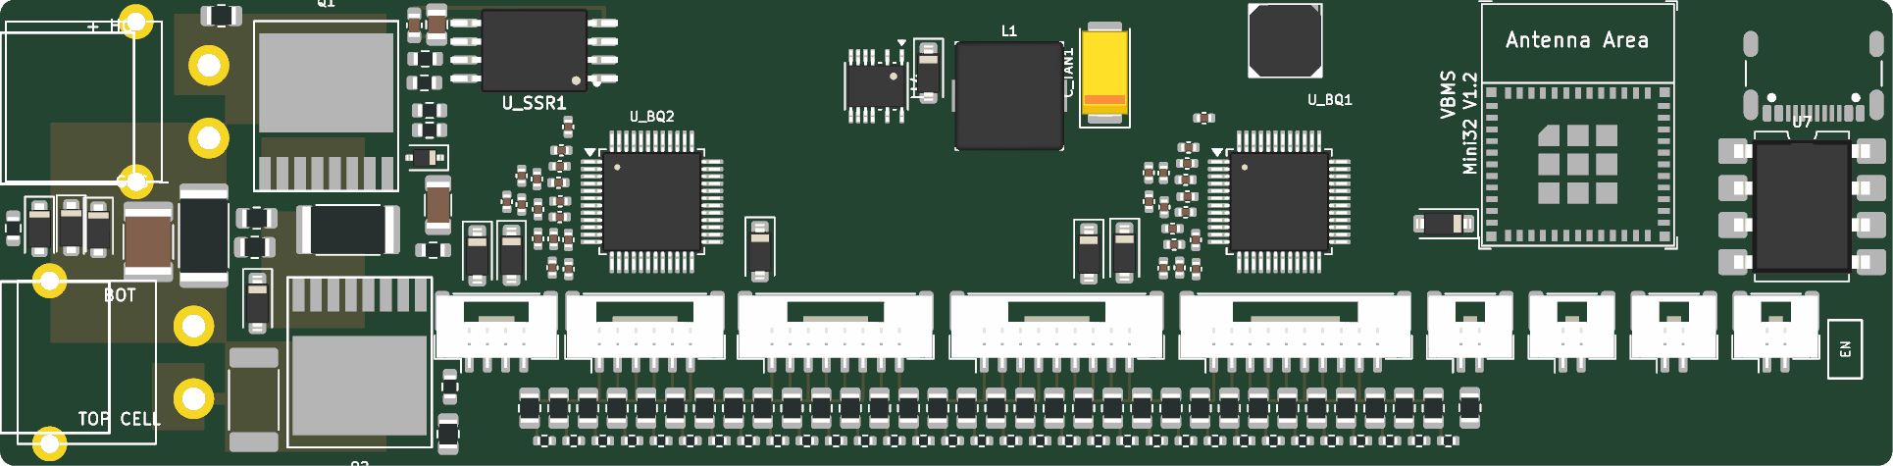
site/data/9c39aff29bfa.png
