Focerqc/QFBMS/site/data/15ea235b8794.png

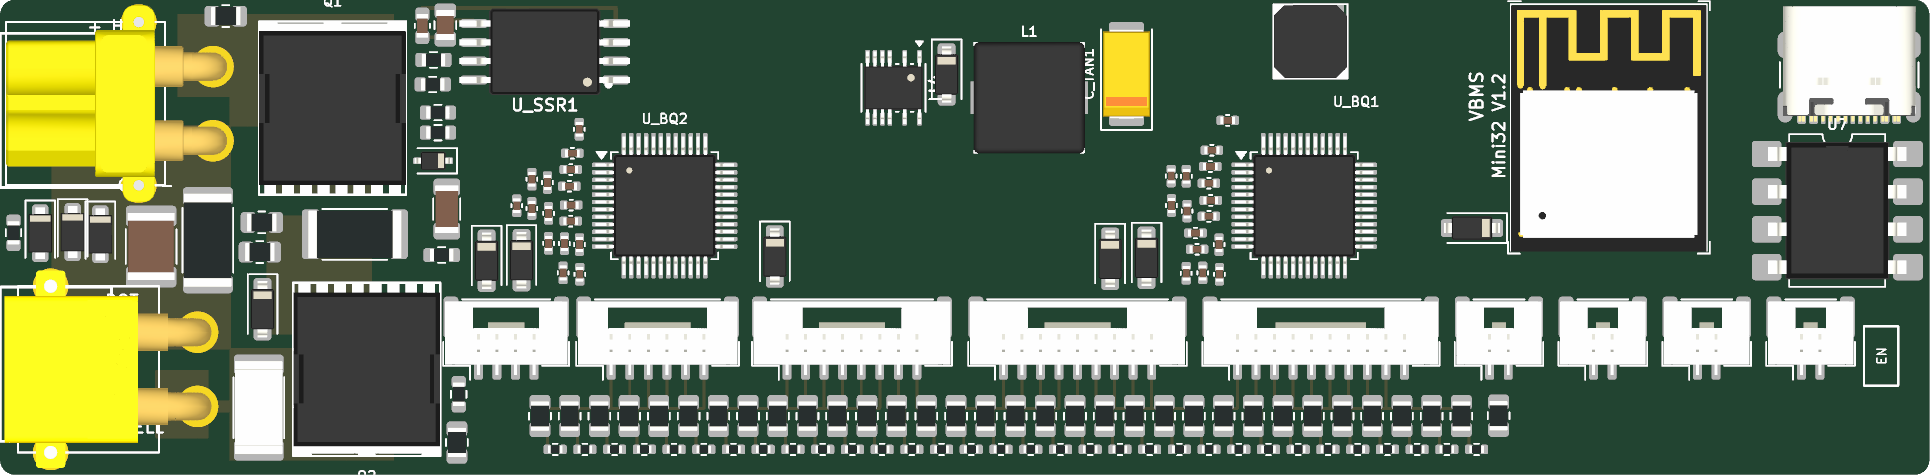
site/data/15ea235b8794.png
