Focerqc/QFBMS/design/charge-control/bom.csv

reference | value | mpn | footprint | status | sheet
QCC1 | AGM15T03LL | AGM15T03LL |  | CONDITIONAL | power
QCC2 | AGM15T03LL | AGM15T03LL |  | CONDITIONAL | power
FCC1 | PACK FUSE - OPEN SELECTION | UNRESOLVED |  | OPEN | power
FCC2 | CHARGER FUSE - OPEN SELECTION | UNRESOLVED |  | OPEN | power
DCC1 | REVERSE CROWBAR - OPEN | UNRESOLVED |  | OPEN | power
RCC1 | 10m / fast-trip Kelvin | WSLP2512R0100FEA | Resistor_SMD:R_2512_6332Metric | CONDITIONAL | power
RCC2 | Existing R_SH1 1m | UNRESOLVED_EXISTING |  | OPEN | power
RCC3 | Existing R_SH2 1m | UNRESOLVED_EXISTING |  | OPEN | power
RCC4 | 22 | RC0603FR-0722RL | Resistor_SMD:R_0603_1608Metric | DRAFT | power
RCC5 | 22 | RC0603FR-0722RL | Resistor_SMD:R_0603_1608Metric | DRAFT | power
RCC6 | 10k | RC0603FR-0710KL | Resistor_SMD:R_0603_1608Metric | DRAFT | power
RCC7 | 10k | RC0603FR-0710KL | Resistor_SMD:R_0603_1608Metric | DRAFT | power
DCC2 | PDZ16B | PDZ16B,115 | Diode_SMD:D_SOD-323 | DRAFT | power
DCC3 | PDZ16B | PDZ16B,115 | Diode_SMD:D_SOD-323 | DRAFT | power
UCC1 | MGJ1D051505MPC-R7 | MGJ1D051505MPC-R7 |  | CONDITIONAL | driver
FCC3 | 600mA anti-surge input | UNRESOLVED |  | OPEN | driver
CCC1 | 10u 50V | GRM32ER71H106KA12L | Capacitor_SMD:C_1210_3225Metric | DRAFT | driver
CCC2 | 100n | GRM188R71H104KA93D | Capacitor_SMD:C_0603_1608Metric | DRAFT | driver
RCC8 | 2k | CRCW12062K00FKEA | Resistor_SMD:R_1206_3216Metric | DRAFT | driver
RCC9 | 680 | CRCW1206680RFKEA | Resistor_SMD:R_1206_3216Metric | DRAFT | driver
UCC2 | TPS7A1601DGNR | TPS7A1601DGNR | Package_SO:HVSSOP-8-1EP_3x3mm_P0.65mm_EP1.57x1.89mm | DRAFT | driver
RCC10 | 100k | RC0603FR-07100KL | Resistor_SMD:R_0603_1608Metric | DRAFT | driver
RCC11 | 10k | RC0603FR-0710KL | Resistor_SMD:R_0603_1608Metric | DRAFT | driver
CCC3 | 10u 50V | GRM32ER71H106KA12L | Capacitor_SMD:C_1210_3225Metric | DRAFT | driver
CCC4 | 10u 50V | GRM32ER71H106KA12L | Capacitor_SMD:C_1210_3225Metric | DRAFT | driver
DCC4 | LDO reverse discharge | SS14 | Diode_SMD:D_SMA | DRAFT | driver
UCC3 | ADuM4120CRIZ | ADuM4120CRIZ |  | DRAFT | driver
CCC5 | 100n | GRM188R71H104KA93D | Capacitor_SMD:C_0603_1608Metric | DRAFT | driver
CCC6 | 100n | GRM188R71H104KA93D | Capacitor_SMD:C_0603_1608Metric | DRAFT | driver
UCC4 | TLV76033DBZR | TLV76033DBZR | Package_TO_SOT_SMD:SOT-23 | DRAFT | driver
CCC7 | 100n | GRM188R71H104KA93D | Capacitor_SMD:C_0603_1608Metric | DRAFT | driver
RCC19 | 2k | RC0603FR-072KL | Resistor_SMD:R_0603_1608Metric | DRAFT | driver
UCC5 | TPS3808G01DBVR | TPS3808G01DBVR | Package_TO_SOT_SMD:SOT-23-6 | DRAFT | driver
RCC12 | 287k | RC0603FR-07287KL | Resistor_SMD:R_0603_1608Metric | DRAFT | driver
RCC13 | 10k | RC0603FR-0710KL | Resistor_SMD:R_0603_1608Metric | DRAFT | driver
RCC14 | 10k | RC0603FR-0710KL | Resistor_SMD:R_0603_1608Metric | DRAFT | driver
RCC15 | 2k | RC0603FR-072KL | Resistor_SMD:R_0603_1608Metric | DRAFT | driver
RCC16 | 100k | RC0603FR-07100KL | Resistor_SMD:R_0603_1608Metric | DRAFT | driver
QCC3 | MMBT3904LT1G | MMBT3904LT1G | Package_TO_SOT_SMD:SOT-23 | DRAFT | driver
RCC17 | 2k | CRCW12062K00FKEA | Resistor_SMD:R_1206_3216Metric | DRAFT | driver
UCC6 | VO617A-3X018T | VO617A-3X018T |  | CONDITIONAL | driver
RCC18 | 10k | RC0603FR-0710KL | Resistor_SMD:R_0603_1608Metric | DRAFT | driver
UCC7 | SN74LVC1G14DBVR | SN74LVC1G14DBVR | Package_TO_SOT_SMD:SOT-23-5 | DRAFT | driver
CCC8 | 100n | GRM188R71H104KA93D | Capacitor_SMD:C_0603_1608Metric | DRAFT | driver
UCC10 | TPS3431SDRBR | TPS3431SDRBR | Package_SON:VSON-8-1EP_3x3mm_P0.65mm_EP1.65x2.4mm | DRAFT | permission
CCC10 | 1n C0G 1% | C0603C102F5GACTU | Capacitor_SMD:C_0603_1608Metric | DRAFT | permission
RCC20 | 10k | RC0603FR-0710KL | Resistor_SMD:R_0603_1608Metric | DRAFT | permission
RCC21 | 100k | RC0603FR-07100KL | Resistor_SMD:R_0603_1608Metric | DRAFT | permission
UCC11 | TPS3808G33DBVR | TPS3808G33DBVR | Package_TO_SOT_SMD:SOT-23-6 | DRAFT | permission
UCC12 | TPS3808G50DBVR | TPS3808G50DBVR | Package_TO_SOT_SMD:SOT-23-6 | DRAFT | permission
RCC22 | 10k | RC0603FR-0710KL | Resistor_SMD:R_0603_1608Metric | DRAFT | permission
UCC13 | SN74LVC1G08DBVR | SN74LVC1G08DBVR | Package_TO_SOT_SMD:SOT-23-5 | DRAFT | permission
UCC14 | SN74LVC1G08DBVR | SN74LVC1G08DBVR | Package_TO_SOT_SMD:SOT-23-5 | DRAFT | permission
UCC15 | SN74LVC1G08DBVR | SN74LVC1G08DBVR | Package_TO_SOT_SMD:SOT-23-5 | DRAFT | permission
UCC16 | SN74LVC1G08DBVR | SN74LVC1G08DBVR | Package_TO_SOT_SMD:SOT-23-5 | DRAFT | permission
UCC17 | SN74LVC1G08DBVR | SN74LVC1G08DBVR | Package_TO_SOT_SMD:SOT-23-5 | DRAFT | permission
RCC23 | 100k | RC0603FR-07100KL | Resistor_SMD:R_0603_1608Metric | DRAFT | permission
RCC24 | 0 | RC0603FR-070RL | Resistor_SMD:R_0603_1608Metric | DNP | permission
UCC18 | SN74LVC1G14DBVR | SN74LVC1G14DBVR | Package_TO_SOT_SMD:SOT-23-5 | DRAFT | permission
UCC19 | SN74LVC1G74DCUR | SN74LVC1G74DCUR | Package_SO:VSSOP-8_2.3x2mm_P0.5mm | DRAFT | permission
UCC20 | SN74LVC1G14DBVR | SN74LVC1G14DBVR | Package_TO_SOT_SMD:SOT-23-5 | DRAFT | permission
UCC21 | SN74LVC1G08DBVR | SN74LVC1G08DBVR | Package_TO_SOT_SMD:SOT-23-5 | DRAFT | permission
RCC25 | 10k | RC0603FR-0710KL | Resistor_SMD:R_0603_1608Metric | DRAFT | permission
CCC11 | 100n | GRM188R71H104KA93D | Capacitor_SMD:C_0603_1608Metric | DRAFT | permission
SWCC1 | Deliberate REARM | TL1105SPF160Q |  | DRAFT | permission
UCC22 | SN74LVC1G14DBVR | SN74LVC1G14DBVR | Package_TO_SOT_SMD:SOT-23-5 | DRAFT | permission
UCC23 | SN74LVC1G74DCUR | SN74LVC1G74DCUR | Package_SO:VSSOP-8_2.3x2mm_P0.5mm | DRAFT | permission
UCC24 | SN74LVC1G08DBVR | SN74LVC1G08DBVR | Package_TO_SOT_SMD:SOT-23-5 | DRAFT | permission
UCC25 | SN74LVC1G08DBVR | SN74LVC1G08DBVR | Package_TO_SOT_SMD:SOT-23-5 | DRAFT | permission
UCC26 | SN74LVC1G08DBVR | SN74LVC1G08DBVR | Package_TO_SOT_SMD:SOT-23-5 | DRAFT | permission
RCC26 | 100k | RC0603FR-07100KL | Resistor_SMD:R_0603_1608Metric | DRAFT | permission
RCC27 | 100k | RC0603FR-07100KL | Resistor_SMD:R_0603_1608Metric | DRAFT | permission
RCC28 | 10k | RC0603FR-0710KL | Resistor_SMD:R_0603_1608Metric | DRAFT | permission
CCC30 | 100n | GRM188R71H104KA93D | Capacitor_SMD:C_0603_1608Metric | DRAFT | permission
CCC31 | 100n | GRM188R71H104KA93D | Capacitor_SMD:C_0603_1608Metric | DRAFT | permission
CCC32 | 100n | GRM188R71H104KA93D | Capacitor_SMD:C_0603_1608Metric | DRAFT | permission
CCC33 | 100n | GRM188R71H104KA93D | Capacitor_SMD:C_0603_1608Metric | DRAFT | permission
CCC34 | 100n | GRM188R71H104KA93D | Capacitor_SMD:C_0603_1608Metric | DRAFT | permission
CCC35 | 100n | GRM188R71H104KA93D | Capacitor_SMD:C_0603_1608Metric | DRAFT | permission
CCC36 | 100n | GRM188R71H104KA93D | Capacitor_SMD:C_0603_1608Metric | DRAFT | permission
CCC37 | 100n | GRM188R71H104KA93D | Capacitor_SMD:C_0603_1608Metric | DRAFT | permission
CCC38 | 100n | GRM188R71H104KA93D | Capacitor_SMD:C_0603_1608Metric | DRAFT | permission
CCC39 | 100n | GRM188R71H104KA93D | Capacitor_SMD:C_0603_1608Metric | DRAFT | permission
CCC40 | 100n | GRM188R71H104KA93D | Capacitor_SMD:C_0603_1608Metric | DRAFT | permission
CCC41 | 100n | GRM188R71H104KA93D | Capacitor_SMD:C_0603_1608Metric | DRAFT | permission
CCC42 | 100n | GRM188R71H104KA93D | Capacitor_SMD:C_0603_1608Metric | DRAFT | permission
CCC43 | 100n | GRM188R71H104KA93D | Capacitor_SMD:C_0603_1608Metric | DRAFT | permission
CCC44 | 100n | GRM188R71H104KA93D | Capacitor_SMD:C_0603_1608Metric | DRAFT | permission
CCC45 | 100n | GRM188R71H104KA93D | Capacitor_SMD:C_0603_1608Metric | DRAFT | permission
CCC46 | 100n | GRM188R71H104KA93D | Capacitor_SMD:C_0603_1608Metric | DRAFT | permission
RCC30 | 330k | RC0603FR-07330KL | Resistor_SMD:R_0603_1608Metric | DRAFT | sensing
RCC31 | 330k | RC0603FR-07330KL | Resistor_SMD:R_0603_1608Metric | DRAFT | sensing
RCC32 | 330k | RC0603FR-07330KL | Resistor_SMD:R_0603_1608Metric | DRAFT | sensing
RCC33 | 10k | RC0603FR-0710KL | Resistor_SMD:R_0603_1608Metric | DRAFT | sensing
RCC34 | 10k | RC0603FR-0710KL | Resistor_SMD:R_0603_1608Metric | DRAFT | sensing
RCC35 | 10k | RC0603FR-0710KL | Resistor_SMD:R_0603_1608Metric | DRAFT | sensing
RCC36 | 10.2k | RC0603FR-0710K2L | Resistor_SMD:R_0603_1608Metric | DRAFT | sensing
CCC60 | 47p C0G | GRM1885C1H470JA01D | Capacitor_SMD:C_0603_1608Metric | DRAFT | sensing
UCC30 | TLV3201AIDBVR | TLV3201AIDBVR | Package_TO_SOT_SMD:SOT-23-5 | DRAFT | sensing
RCC37 | 10k | RC0603BR-0710KL | Resistor_SMD:R_0603_1608Metric | DRAFT | sensing
RCC38 | 10k | RC0603BR-0710KL | Resistor_SMD:R_0603_1608Metric | DRAFT | sensing
CCC61 | 47p C0G | GRM1885C1H470JA01D | Capacitor_SMD:C_0603_1608Metric | DRAFT | sensing
RCC39 | 10.7k | RC0603BR-0710K7L | Resistor_SMD:R_0603_1608Metric | DRAFT | sensing
RCC40 | 10k | RC0603BR-0710KL | Resistor_SMD:R_0603_1608Metric | DRAFT | sensing
RCC41 | 10k | RC0603BR-0710KL | Resistor_SMD:R_0603_1608Metric | DRAFT | sensing
RCC42 | 10.7k | RC0603BR-0710K7L | Resistor_SMD:R_0603_1608Metric | DRAFT | sensing
UCC31 | TLV3201AIDBVR | TLV3201AIDBVR | Package_TO_SOT_SMD:SOT-23-5 | DRAFT | sensing
UCC32 | TLV3201AIDBVR | TLV3201AIDBVR | Package_TO_SOT_SMD:SOT-23-5 | DRAFT | sensing
UCC33 | SN74LVC1G08DBVR | SN74LVC1G08DBVR | Package_TO_SOT_SMD:SOT-23-5 | DRAFT | sensing
CCC62 | 100n | GRM188R71H104KA93D | Capacitor_SMD:C_0603_1608Metric | DRAFT | sensing
CCC63 | 100n | GRM188R71H104KA93D | Capacitor_SMD:C_0603_1608Metric | DRAFT | sensing
CCC64 | 100n | GRM188R71H104KA93D | Capacitor_SMD:C_0603_1608Metric | DRAFT | sensing
CCC65 | 100n | GRM188R71H104KA93D | Capacitor_SMD:C_0603_1608Metric | DRAFT | sensing
