Focerqc/QFBMS/docs/review-reconcile-2026-11-04/component-ledger.csv

reference | classification | function | value | footprint | pad_assignments | direct_copper_objects | baseline_DRC | disposition
BZ1 | required | Audible status output | FUET-5030 | qfbms:Buzzer_5.0x5.0mm_SMD | 1:+3V3; 2:BUZZ_LOW; 3:(unset) | none | copper_edge_clearance:1 | GPIO3 PWM is used in Lisp; buzzer assigned +3V3/BUZZ_LOW, no verified sink. Identify drive type, current, third pad and protection; do not connect module directly without load analysis.
C_DISC | unresolved | Local storage/bypass candidate | 10uF | C_1206_3216Metric | 1:(unset); 2:(unset) | none | none on these IDs | Unassigned 10uF; trace the actual supply or switch node and return. Determine operating voltage, discharge timing and capacitance before assigning.
C_F1 | required | Differential VC filter | 0.22uF | C_0402_1005Metric | 1:BQ1_VC1; 2:CELL0 | none | none on these IDs | Retain filter for this measured cell; see pad pair. Verify effective 220 nF, voltage rating, local return, actual copper and front-side 0603 site before routing.
C_F2 | required | Differential VC filter | 0.22uF | C_0402_1005Metric | 1:BQ1_VC2; 2:BQ1_VC1 | none | none on these IDs | Retain filter for this measured cell; see pad pair. Verify effective 220 nF, voltage rating, local return, actual copper and front-side 0603 site before routing.
C_F3 | required | Differential VC filter | 0.22uF | C_0402_1005Metric | 1:BQ1_VC3; 2:BQ1_VC2 | none | none on these IDs | Retain filter for this measured cell; see pad pair. Verify effective 220 nF, voltage rating, local return, actual copper and front-side 0603 site before routing.
C_F4 | required | Differential VC filter | 0.22uF | C_0402_1005Metric | 1:BQ1_VC4; 2:BQ1_VC3 | none | none on these IDs | Retain filter for this measured cell; see pad pair. Verify effective 220 nF, voltage rating, local return, actual copper and front-side 0603 site before routing.
C_F5 | required | Differential VC filter | 0.22uF | C_0402_1005Metric | 1:BQ1_VC5; 2:BQ1_VC4 | none | none on these IDs | Retain filter for this measured cell; see pad pair. Verify effective 220 nF, voltage rating, local return, actual copper and front-side 0603 site before routing.
C_F6 | required | Differential VC filter | 0.22uF | C_0402_1005Metric | 1:BQ1_VC6; 2:BQ1_VC5 | none | none on these IDs | Retain filter for this measured cell; see pad pair. Verify effective 220 nF, voltage rating, local return, actual copper and front-side 0603 site before routing.
C_F7 | required | Differential VC filter | 0.22uF | C_0402_1005Metric | 1:BQ1_VC7; 2:BQ1_VC6 | none | none on these IDs | Retain filter for this measured cell; see pad pair. Verify effective 220 nF, voltage rating, local return, actual copper and front-side 0603 site before routing.
C_F8 | required | Differential VC filter | 0.22uF | C_0402_1005Metric | 1:BQ1_VC8; 2:BQ1_VC7 | none | none on these IDs | Retain filter for this measured cell; see pad pair. Verify effective 220 nF, voltage rating, local return, actual copper and front-side 0603 site before routing.
C_F9 | required | Differential VC filter | 0.22uF | C_0402_1005Metric | 1:BQ1_VC9; 2:BQ1_VC8 | none | none on these IDs | Retain filter for this measured cell; see pad pair. Verify effective 220 nF, voltage rating, local return, actual copper and front-side 0603 site before routing.
C_F10 | required | Differential VC filter | 0.22uF | C_0402_1005Metric | 1:BQ1_VC10; 2:BQ1_VC9 | none | none on these IDs | Retain filter for this measured cell; see pad pair. Verify effective 220 nF, voltage rating, local return, actual copper and front-side 0603 site before routing.
C_F11 | required | Differential VC filter | 0.22uF | C_0402_1005Metric | 1:BQ1_VC11; 2:BQ1_VC10 | none | none on these IDs | Retain filter for this measured cell; see pad pair. Verify effective 220 nF, voltage rating, local return, actual copper and front-side 0603 site before routing.
C_F12 | required | Differential VC filter | 0.22uF | C_0402_1005Metric | 1:BQ1_VC12; 2:BQ1_VC11 | none | none on these IDs | Retain filter for this measured cell; see pad pair. Verify effective 220 nF, voltage rating, local return, actual copper and front-side 0603 site before routing.
C_F13 | required | Differential VC filter | 0.22uF | C_0402_1005Metric | 1:BQ1_VC13; 2:BQ1_VC12 | none | none on these IDs | Retain filter for this measured cell; see pad pair. Verify effective 220 nF, voltage rating, local return, actual copper and front-side 0603 site before routing.
C_F14 | required | Differential VC filter | 0.22uF | C_0402_1005Metric | 1:BQ1_VC14; 2:BQ1_VC13 | none | none on these IDs | Retain filter for this measured cell; see pad pair. Verify effective 220 nF, voltage rating, local return, actual copper and front-side 0603 site before routing.
C_F15 | required | Differential VC filter | 0.22uF | C_0402_1005Metric | 1:BQ1_VC15; 2:BQ1_VC14 | none | none on these IDs | Retain filter for this measured cell; see pad pair. Verify effective 220 nF, voltage rating, local return, actual copper and front-side 0603 site before routing.
C_F16 | required | Differential VC filter | 0.22uF | C_0402_1005Metric | 1:BQ1_VC16; 2:BQ1_VC15 | none | none on these IDs | Retain filter for this measured cell; see pad pair. Verify effective 220 nF, voltage rating, local return, actual copper and front-side 0603 site before routing.
C_F17 | required | Differential VC filter | 0.22uF | C_0402_1005Metric | 1:BQ2_VC1; 2:CELL16 | none | none on these IDs | Retain filter for this measured cell; see pad pair. Verify effective 220 nF, voltage rating, local return, actual copper and front-side 0603 site before routing.
C_F18 | required | Differential VC filter | 0.22uF | C_0402_1005Metric | 1:BQ2_VC2; 2:BQ2_VC1 | none | none on these IDs | Retain filter for this measured cell; see pad pair. Verify effective 220 nF, voltage rating, local return, actual copper and front-side 0603 site before routing.
C_F19 | required | Differential VC filter | 0.22uF | C_0402_1005Metric | 1:BQ2_VC3; 2:BQ2_VC2 | none | none on these IDs | Retain filter for this measured cell; see pad pair. Verify effective 220 nF, voltage rating, local return, actual copper and front-side 0603 site before routing.
C_F20 | required | Differential VC filter | 0.22uF | C_0402_1005Metric | 1:BQ2_VC4; 2:BQ2_VC3 | none | none on these IDs | Retain filter for this measured cell; see pad pair. Verify effective 220 nF, voltage rating, local return, actual copper and front-side 0603 site before routing.
C_F21 | required | Differential VC filter | 0.22uF | C_0402_1005Metric | 1:BQ2_VC5; 2:BQ2_VC4 | none | none on these IDs | Retain filter for this measured cell; see pad pair. Verify effective 220 nF, voltage rating, local return, actual copper and front-side 0603 site before routing.
C_F22 | required | Differential VC filter | 0.22uF | C_0402_1005Metric | 1:BQ2_VC6; 2:BQ2_VC5 | none | none on these IDs | Retain filter for this measured cell; see pad pair. Verify effective 220 nF, voltage rating, local return, actual copper and front-side 0603 site before routing.
C_F23 | required | Differential VC filter | 0.22uF | C_0402_1005Metric | 1:BQ2_VC7; 2:BQ2_VC6 | none | none on these IDs | Retain filter for this measured cell; see pad pair. Verify effective 220 nF, voltage rating, local return, actual copper and front-side 0603 site before routing.
C_F24 | required | Differential VC filter | 0.22uF | C_0402_1005Metric | 1:BQ2_VC8; 2:BQ2_VC7 | none | none on these IDs | Retain filter for this measured cell; see pad pair. Verify effective 220 nF, voltage rating, local return, actual copper and front-side 0603 site before routing.
C_F25 | required | Differential VC filter | 0.22uF | C_0402_1005Metric | 1:BQ2_VC9; 2:BQ2_VC8 | none | none on these IDs | Retain filter for this measured cell; see pad pair. Verify effective 220 nF, voltage rating, local return, actual copper and front-side 0603 site before routing.
C_F26 | required | Differential VC filter | 0.22uF | C_0402_1005Metric | 1:BQ2_VC10; 2:BQ2_VC9 | none | none on these IDs | Retain filter for this measured cell; see pad pair. Verify effective 220 nF, voltage rating, local return, actual copper and front-side 0603 site before routing.
C_F27 | required | Differential VC filter | 0.22uF | C_0402_1005Metric | 1:BQ2_VC11; 2:BQ2_VC10 | none | none on these IDs | Retain filter for this measured cell; see pad pair. Verify effective 220 nF, voltage rating, local return, actual copper and front-side 0603 site before routing.
C_F28 | required | Differential VC filter | 0.22uF | C_0402_1005Metric | 1:BQ2_VC12; 2:BQ2_VC11 | none | none on these IDs | Retain filter for this measured cell; see pad pair. Verify effective 220 nF, voltage rating, local return, actual copper and front-side 0603 site before routing.
C_F29 | required | Differential VC filter | 0.22uF | C_0402_1005Metric | 1:BQ2_VC13; 2:BQ2_VC12 | none | none on these IDs | Retain filter for this measured cell; see pad pair. Verify effective 220 nF, voltage rating, local return, actual copper and front-side 0603 site before routing.
C_F30 | required | Differential VC filter | 0.22uF | C_0402_1005Metric | 1:BQ2_VC14; 2:BQ2_VC13 | none | none on these IDs | Retain filter for this measured cell; see pad pair. Verify effective 220 nF, voltage rating, local return, actual copper and front-side 0603 site before routing.
C_F31 | required | Differential VC filter | 0.22uF | C_0402_1005Metric | 1:BQ2_VC15; 2:BQ2_VC14 | none | none on these IDs | Retain filter for this measured cell; see pad pair. Verify effective 220 nF, voltage rating, local return, actual copper and front-side 0603 site before routing.
C_F32 | required | Differential VC filter | 0.22uF | C_0402_1005Metric | 1:BQ2_VC16; 2:BQ2_VC15 | none | none on these IDs | Retain filter for this measured cell; see pad pair. Verify effective 220 nF, voltage rating, local return, actual copper and front-side 0603 site before routing.
C_FLT1 | required | Differential VC filter | 10uF_100V | C_1812_4532Metric | 1:(unset); 2:(unset) | b1145db9-14c1-4999-ab3f-bca64a976399 | clearance:2; solder_mask_bridge:2; courtyards_overlap:1 | Retain filter for this measured cell; see pad pair. Verify effective 220 nF, voltage rating, local return, actual copper and front-side 0603 site before routing.
C_SSR1 | unresolved | Provisional driver-rail bypass | 100nF | C_0603_1608Metric | 1:VBOOST; 2:GND | 449ebee6-114f-439c-ab3b-179a18e0f0fb; 7cd76341-1f60-4909-a93e-e839a5dd98ae; c6ef5384-65e8-45bc-bc14-97b8a6d37944 | courtyards_overlap:2 | Both capacitors touch VBOOST/GND routing at U_SSR1. Keep shared driver network; establish rail voltage, relay identity, loop return and effective C before sizing.
C_SSR2 | unresolved | Provisional driver-rail bypass | 1uF | C_0805_2012Metric | 1:VBOOST; 2:GND | 2c247b41-dcc0-447c-90b4-6f4f2c48b81d; 449ebee6-114f-439c-ab3b-179a18e0f0fb; 697f1b33-03c8-40f9-be91-b5cdb250876f; 7cd76341-1f60-4909-a93e-e839a5dd98ae; fbdaeabb-e482-4d7c-9459-b99aa7e048c0 | clearance:2; copper_edge_clearance:1; courtyards_overlap:3 | Both capacitors touch VBOOST/GND routing at U_SSR1. Keep shared driver network; establish rail voltage, relay identity, loop return and effective C before sizing.
C_TAN1 | unresolved | Low-voltage rail reservoir candidate | 100uF_16V | CP_EIA-6032-28_Kemet-C | 1:(unset); 2:(unset) | none | none on these IDs | 100uF/16 V marking, unassigned. Establish low-voltage rail and polarity; verify inrush, surge derating, ESR and regulator stability.
D_BST1 | unresolved | Converter diode candidate | Schottky | D_SOD-123 | 1:(unset); 2:(unset) | none | none on these IDs | Near U4/L1, no assigned nets. Identify actual regulator topology, diode role/polarity and reverse/peak rating; a BST designator does not prove a boost supply.
D_CHG1 | unresolved | Candidate charge-side rectifier/clamp | DSK320 | D_SOD-123F | 1:(unset); 2:(unset) | none | courtyards_overlap:2 | DSK320 marking and proximity to charge port do not establish series or clamp service. Identify terminals and orientation by continuity; measure reverse/surge envelope before picking a diode.
D_CHG2 | unresolved | Candidate charge-side rectifier/clamp | DSK320 | D_SOD-123F | 1:(unset); 2:(unset) | b1145db9-14c1-4999-ab3f-bca64a976399 | clearance:2; solder_mask_bridge:2; courtyards_overlap:2 | DSK320 marking and proximity to charge port do not establish series or clamp service. Identify terminals and orientation by continuity; measure reverse/surge envelope before picking a diode.
D_CHG3 | unresolved | Candidate charge-side rectifier/clamp | DSK320 | D_SOD-123F | 1:(unset); 2:(unset) | b1145db9-14c1-4999-ab3f-bca64a976399 | clearance:2; solder_mask_bridge:2; courtyards_overlap:1 | DSK320 marking and proximity to charge port do not establish series or clamp service. Identify terminals and orientation by continuity; measure reverse/surge envelope before picking a diode.
D_GS1 | unresolved | Charge gate clamp | PDZ16B | D_SOD-323 | 1:Q1_GATE; 2:CHG+ | none | courtyards_overlap:1 | Gate to CHG+ assigned; verify PDZ16B polarity, clamp curve and energy vs actual Q1 VGS maximum and drive polarity.
D_PRI1 | unresolved | Candidate local supply/steering diode | D_Schottky | D_SOD-123 | 1:(unset); 2:(unset) | none | none on these IDs | Unassigned Schottky on monitor side of board. Trace both terminals on reference hardware and distinguish BAT input, preregulator collector and other clamps. Select polarity, reverse voltage, leakage and surge for that half-stack.
D_PRI2 | unresolved | Candidate local supply/steering diode | D_Schottky | D_SOD-123 | 1:(unset); 2:(unset) | none | none on these IDs | Unassigned Schottky on monitor side of board. Trace both terminals on reference hardware and distinguish BAT input, preregulator collector and other clamps. Select polarity, reverse voltage, leakage and surge for that half-stack.
D_PRI3 | unresolved | Candidate local supply/steering diode | D_Schottky | D_SOD-123 | 1:(unset); 2:(unset) | none | none on these IDs | Unassigned Schottky on monitor side of board. Trace both terminals on reference hardware and distinguish BAT input, preregulator collector and other clamps. Select polarity, reverse voltage, leakage and surge for that half-stack.
D_S1 | unresolved | Transient suppression candidate | TVS | D_SOD-123 | 1:(unset); 2:(unset) | cad39c70-0b10-448b-a789-0bdbc12c340d | shorting_items:2; solder_mask_bridge:2 | Both unassigned pads intersect one graphic; identity, clamped node and return unknown. Specify standoff, clamp voltage, energy and placement from measured transient envelope.
D_SEC1 | unresolved | Candidate local supply/steering diode | D_Schottky | D_SOD-123 | 1:(unset); 2:(unset) | none | courtyards_overlap:1 | Unassigned Schottky on monitor side of board. Trace both terminals on reference hardware and distinguish BAT input, preregulator collector and other clamps. Select polarity, reverse voltage, leakage and surge for that half-stack.
D_SEC2 | unresolved | Candidate local supply/steering diode | D_Schottky | D_SOD-123 | 1:(unset); 2:(unset) | none | courtyards_overlap:1 | Unassigned Schottky on monitor side of board. Trace both terminals on reference hardware and distinguish BAT input, preregulator collector and other clamps. Select polarity, reverse voltage, leakage and surge for that half-stack.
D_SEC3 | unresolved | Candidate local supply/steering diode | D_Schottky | D_SOD-123 | 1:(unset); 2:(unset) | none | courtyards_overlap:1 | Unassigned Schottky on monitor side of board. Trace both terminals on reference hardware and distinguish BAT input, preregulator collector and other clamps. Select polarity, reverse voltage, leakage and surge for that half-stack.
F1 | required | Pack-positive fuse | JT 15A | Fuse_2512_6332Metric | 1:CELL32; 2:CELL32_FUSED | 6346c4bc-eaf3-44a3-9a17-f6c3284ce6b5; a05370c4-ce60-4d6b-bed9-fdd6899c39a5 | shorting_items:2; solder_mask_bridge:2; courtyards_overlap:1 | Retain fuse function; both pads touch one unassigned polygon. Eliminate bypass in reviewed routing; establish DC interrupt rating at pack voltage, time-current curve and fault current.
FB1 | unresolved | Possible ferrite or link | Unmarked | R_0603_1608Metric | 1:(unset); 2:(unset) | none | courtyards_overlap:2 | Unmarked 0603; neither net assigned. Identify material/impedance or DC resistance and actual supply/signal path before deciding whether needed.
J_BAT1 | required | Battery power connector | XT30PW-M (BAT) | XT30PW-M_Lugs | 1:CELL32; 2:CELL0; TAB1:(unset); TAB2:(unset) | 6cc18b0b-4b6f-4bd3-a552-bb783a829bc1; 7d84e315-9df7-4058-937b-9f7c74a99c98; a613e4b8-1f60-4b41-a8f4-4b1686c72767; b1145db9-14c1-4999-ab3f-bca64a976399; df31fd34-99b8-4ea4-b316-237cea3ff7ec | shorting_items:2; hole_clearance:4; clearance:2; copper_edge_clearance:1; solder_mask_bridge:4 | Preserve mating geometry; verify polarity, current/fault capacity and fuse path. Polygon contacts do not prove separated terminals.
J_CELL1 | required | Keyed cell tap harness | 0-8 | JST_GH_BM10B-GHS-TBT_1x10-1MP_P1.25mm_Vertical | 1:CELL9; 2:CELL8; 3:CELL7; 4:CELL6; 5:CELL5; 6:CELL4; 7:CELL3; 8:CELL2; 9:CELL1; 10:CELL0; MP:(unset) x2 | 06457be1-40ba-4ab1-97b2-733989a053e1; 1480a4a9-e10b-4758-b24f-39cfc669d18f; 2c1f5696-2af2-4385-9839-3a65cdecd055; 37e51e6a-242a-42c6-80a5-1a8f65bff5ca; 396ff50d-9462-4cfb-9359-8b02e02754b9; 717f93da-7026-46b2-ac74-143fd74427e6; 8bc92fa5-f9be-466e-94a5-f2c26149b35e; 91605922-a14f-41bd-b166-53e250eada80; a9679365-01d6-4698-ac20-c57d8b66199f | none on these IDs | Keep connector unchanged. Use actual pad order below; value/range text does not match. Confirm keyed mating face and polarity by continuity; do not relabel by assumption.
J_CELL2 | required | Keyed cell tap harness | 9-16 | JST_GH_BM09B-GHS-TBT_1x09-1MP_P1.25mm_Vertical | 1:CELL18; 2:CELL17; 3:CELL16; 4:CELL15; 5:CELL14; 6:CELL13; 7:CELL12; 8:CELL11; 9:CELL10; MP:(unset) x2 | 03688cb9-d38d-4c0f-b457-6feeb11c251f; 2cb1a396-a03b-45c8-a026-0f1e82673e02; 68499ee8-4fda-47a2-b969-dd6bda85b378; 6cc2e304-57bc-4fcf-87ed-660f9c45ebf0; 772136ae-f53d-4922-a7a4-9fa80ef17fcb; 81a09f16-38e7-4146-bb8c-fe41232691a0; bc2a9eab-2498-4a9a-8231-aa59f9e806e1; c9103990-72bb-42a6-9331-aae9b2ccff01; f9100544-fcba-45fb-ad8a-c7b2f56a93ba | none on these IDs | Keep connector unchanged. Use actual pad order below; value/range text does not match. Confirm keyed mating face and polarity by continuity; do not relabel by assumption.
J_CELL3 | required | Keyed cell tap harness | 17-24 | JST_GH_BM08B-GHS-TBT_1x08-1MP_P1.25mm_Vertical | 1:CELL26; 2:CELL25; 3:CELL24; 4:CELL23; 5:CELL22; 6:CELL21; 7:CELL20; 8:CELL19; MP:(unset) x2 | 03e89028-a9c2-434c-bf7e-a57cf5912204; 14e523ef-6ec4-4d98-870d-8f6e042d3536; 1c23ad39-a6e0-456f-97a0-3ea9f8faca71; 306d0d60-b8a0-456c-9fd6-12c3f935d059; 59f5c282-ef99-49ea-9e4b-21ef49f352e9; 6a3f7783-1218-42f2-a6bc-f46290b85992; 6fe09220-8751-4478-806d-c33b3a51097f; e8e6e400-6635-4ee4-91a0-b84cabe4cffb | courtyards_overlap:2 | Keep connector unchanged. Use actual pad order below; value/range text does not match. Confirm keyed mating face and polarity by continuity; do not relabel by assumption.
J_CELL4 | required | Keyed cell tap harness | 25-32 | JST_GH_BM06B-GHS-TBT_1x06-1MP_P1.25mm_Vertical | 1:CELL32; 2:CELL31; 3:CELL30; 4:CELL29; 5:CELL28; 6:CELL27; MP:(unset) x2 | 453840e5-97d3-4c1e-b668-e1d8f40ea31b; 61885c29-3693-4c10-a874-1c8121fe0a6d; c661afb9-22c9-4630-9530-79b5acbbdea9; c9203480-ec2e-4f89-8711-3eb2c456a465; cca0b6e6-70a8-4c81-a43d-3bfa65508040; d4a01c88-2e84-44ee-a3e7-7e3600326d02 | courtyards_overlap:2 | Keep connector unchanged. Use actual pad order below; value/range text does not match. Confirm keyed mating face and polarity by continuity; do not relabel by assumption.
J_CHG1 | required | Charger connector | XT30PW-F (CHG) | XT30PW-F_Lugs | 1:CHG+; 2:CHG-; TAB1:(unset); TAB2:(unset) | a613e4b8-1f60-4b41-a8f4-4b1686c72767; adae2e6a-3f1f-449b-b9f8-1290c95b8431; b1145db9-14c1-4999-ab3f-bca64a976399; ecadddc8-e4f9-4921-88fe-14e10bc5a686 | shorting_items:5; hole_clearance:7; clearance:3; copper_edge_clearance:1; solder_mask_bridge:7 | Keep fixed; verify both terminals isolated when off, polarity and no bypass through polygons, USB or CAN.
J_COMM1 | required | Isolated CAN and bus-side supply | CAN/5V | JST_GH_BM04B-GHS-TBT_1x04-1MP_P1.25mm_Vertical | 1:CANH; 2:CANL; 3:ISO_GND; 4:5VExt; MP:(unset) x2 | none | courtyards_overlap:5 | Preserve fixed pin order; confirm mating-side CANH/L, external 5 V/return, spacing, termination and ESD.
J_T1 | required | External cell temperature connector | T1 | JST_GH_BM02B-GHS-TBT_1x02-1MP_P1.25mm_Vertical | 1:TS1; 2:GND; MP:(unset) x2 | none | none on these IDs | Keep connector unchanged. Map the four sensors to lower TS1/TS3/ALERT/DCHG rather than PCB names; reserve lower TS2 for wake and HDQ for MOS. Verify return, 10k beta3380 NTC, series resistance and open/short behavior.
J_T2 | required | External cell temperature connector | T2 | JST_GH_BM02B-GHS-TBT_1x02-1MP_P1.25mm_Vertical | 1:TS2; 2:GND; MP:(unset) x2 | none | none on these IDs | Keep connector unchanged. Map the four sensors to lower TS1/TS3/ALERT/DCHG rather than PCB names; reserve lower TS2 for wake and HDQ for MOS. Verify return, 10k beta3380 NTC, series resistance and open/short behavior.
J_T3 | required | External cell temperature connector | T3 | JST_GH_BM02B-GHS-TBT_1x02-1MP_P1.25mm_Vertical | 1:TS3; 2:GND; MP:(unset) x2 | none | none on these IDs | Keep connector unchanged. Map the four sensors to lower TS1/TS3/ALERT/DCHG rather than PCB names; reserve lower TS2 for wake and HDQ for MOS. Verify return, 10k beta3380 NTC, series resistance and open/short behavior.
J_T4 | required | External cell temperature connector | T4 | JST_GH_BM02B-GHS-TBT_1x02-1MP_P1.25mm_Vertical | 1:TS4; 2:GND; MP:(unset) x2 | none | none on these IDs | Keep connector unchanged. Map the four sensors to lower TS1/TS3/ALERT/DCHG rather than PCB names; reserve lower TS2 for wake and HDQ for MOS. Verify return, 10k beta3380 NTC, series resistance and open/short behavior.
J_USB1 | required | USB-C / programming | USB-C | USB_C_Receptacle_16P | (unnumbered):(unset) x2; A1:(unset); A4:(unset); A5:(unset); A6:(unset); A7:(unset); A8:(unset); A9:(unset); A12:(unset); B1:(unset); B4:(unset); B5:(unset); B6:(unset); B7:(unset); B8:(unset); B9:(unset); B12:(unset); SH:(unset) x4 | none | hole_clearance:4; clearance:4; solder_mask_bridge:4 | All signal pads unset. Preserve geometry; verify CC1/2 sink termination, paired D+/D-, VBUS isolation, ESD and shell return; test both plug orientations and ROM download.
L1 | unresolved | Converter inductor candidate | 180uH_181 | L_7.3x7.3_H4.5 | 1:(unset); 2:(unset) | none | none on these IDs | 180uH marking near U4; neither end assigned. Trace switch node/output and identify saturation current, DCR, ripple and loss for selected supply.
Q1 | unresolved | High-side charge switch candidate | AGM15T03LL | TOLL-8_AGM15T03LL | 1:Q1_GATE; 2:CHG+; 3:CHG+; 4:CHG+; 5:CHG+; 6:CHG+; 7:CHG+; 8:CHG+; D:CELL32_FUSED | a599c30e-33fb-457d-9ce3-9afa1e7129c4; adae2e6a-3f1f-449b-b9f8-1290c95b8431 | shorting_items:8; solder_mask_bridge:8; courtyards_overlap:4 | Keep charge branch. Draw body-diode direction in both voltage polarities; test whether a single NFET can actually block charger-to-pack when off. Verify VDS/VGS clamp, SOA and 5 A thermal rise; no heatsink.
Q2 | confirmed obsolete | Discharge output switch | AGM15T03LL | TOLL-8_AGM15T03LL | 1:Q2_GATE; 2:PACK+; 3:PACK+; 4:PACK+; 5:PACK+; 6:PACK+; 7:PACK+; 8:PACK+; D:CELL32_FUSED | a05370c4-ce60-4d6b-bed9-fdd6899c39a5; cad39c70-0b10-448b-a789-0bdbc12c340d | shorting_items:3; clearance:3; solder_mask_bridge:6; courtyards_overlap:4 | Remove only this footprint: fused drain, PACK+ source with no other assigned component, gate isolated. Main schematic identifies DSG output via R_G2. Not in series with J_CHG1. Both touching polygons also serve retained pads.
R_B1 | unresolved | Fixed balance resistor site | 27R0 | R_0805_2012Metric | 1:(unset); 2:(unset) | 23d35eea-026b-47ae-a711-9465245678fc; c659ec06-221b-4f22-ac53-9cc23e0ade5d | shorting_items:3; solder_mask_bridge:3 | Keep exact geometry; neither pad assigned. Map both ends against the 32 host-controlled cell switches, including CELL16 and the extra 33rd site. Verify bleed current and enclosed resistor/BQ heating before fitting.
R_B2 | unresolved | Fixed balance resistor site | 27R0 | R_0805_2012Metric | 1:(unset); 2:(unset) | 23d35eea-026b-47ae-a711-9465245678fc; 6d2d05fd-040e-4069-9f62-4fa9243661d5; eb5b0f78-6f65-4941-8c98-8ccf1f276c96 | shorting_items:4; solder_mask_bridge:4 | Keep exact geometry; neither pad assigned. Map both ends against the 32 host-controlled cell switches, including CELL16 and the extra 33rd site. Verify bleed current and enclosed resistor/BQ heating before fitting.
R_B3 | unresolved | Fixed balance resistor site | 27R0 | R_0805_2012Metric | 1:(unset); 2:(unset) | 04e8fbfe-18fc-48c7-b647-a7b97d485a80; 23d35eea-026b-47ae-a711-9465245678fc; 5b67d8bb-a79a-4d6b-adec-05f369f0424c; c9203480-ec2e-4f89-8711-3eb2c456a465; eb5b0f78-6f65-4941-8c98-8ccf1f276c96 | shorting_items:6; solder_mask_bridge:6 | Keep exact geometry; neither pad assigned. Map both ends against the 32 host-controlled cell switches, including CELL16 and the extra 33rd site. Verify bleed current and enclosed resistor/BQ heating before fitting.
R_B4 | unresolved | Fixed balance resistor site | 27R0 | R_0805_2012Metric | 1:(unset); 2:(unset) | 493a8d34-1305-4a2a-82c3-66143cf4d781; 5b67d8bb-a79a-4d6b-adec-05f369f0424c; 76797bb9-301b-4f5c-bfc9-c3e4b48315e2; cca0b6e6-70a8-4c81-a43d-3bfa65508040; eb5b0f78-6f65-4941-8c98-8ccf1f276c96 | shorting_items:6; solder_mask_bridge:6 | Keep exact geometry; neither pad assigned. Map both ends against the 32 host-controlled cell switches, including CELL16 and the extra 33rd site. Verify bleed current and enclosed resistor/BQ heating before fitting.
R_B5 | unresolved | Fixed balance resistor site | 27R0 | R_0805_2012Metric | 1:(unset); 2:(unset) | 493a8d34-1305-4a2a-82c3-66143cf4d781; 5b67d8bb-a79a-4d6b-adec-05f369f0424c; 96624a38-db14-4bc5-878e-2d6bd5cea072; be5170c9-17db-4198-b059-00a9acbc3ef0; c661afb9-22c9-4630-9530-79b5acbbdea9; d4a01c88-2e84-44ee-a3e7-7e3600326d02 | shorting_items:7; solder_mask_bridge:7 | Keep exact geometry; neither pad assigned. Map both ends against the 32 host-controlled cell switches, including CELL16 and the extra 33rd site. Verify bleed current and enclosed resistor/BQ heating before fitting.
R_B6 | unresolved | Fixed balance resistor site | 27R0 | R_0805_2012Metric | 1:(unset); 2:(unset) | 3416c639-8630-4e23-8352-4f99ed608449; 3deae128-85fc-42dc-908b-5dcb99afe75e; 453840e5-97d3-4c1e-b668-e1d8f40ea31b; 96624a38-db14-4bc5-878e-2d6bd5cea072 | shorting_items:5; solder_mask_bridge:5 | Keep exact geometry; neither pad assigned. Map both ends against the 32 host-controlled cell switches, including CELL16 and the extra 33rd site. Verify bleed current and enclosed resistor/BQ heating before fitting.
R_B7 | unresolved | Fixed balance resistor site | 27R0 | R_0805_2012Metric | 1:(unset); 2:(unset) | 9cf9ade6-59bf-4f94-af42-48108bf93ce9; a132d131-243a-4d5d-acc6-45a068e5a056 | shorting_items:3; solder_mask_bridge:3 | Keep exact geometry; neither pad assigned. Map both ends against the 32 host-controlled cell switches, including CELL16 and the extra 33rd site. Verify bleed current and enclosed resistor/BQ heating before fitting.
R_B8 | unresolved | Fixed balance resistor site | 27R0 | R_0805_2012Metric | 1:(unset); 2:(unset) | 375e4816-72a9-49ce-8ad5-1c3d69609da7; 8543df04-19b7-4311-a039-8d2660d97b4b; a132d131-243a-4d5d-acc6-45a068e5a056 | shorting_items:4; solder_mask_bridge:4 | Keep exact geometry; neither pad assigned. Map both ends against the 32 host-controlled cell switches, including CELL16 and the extra 33rd site. Verify bleed current and enclosed resistor/BQ heating before fitting.
R_B9 | unresolved | Fixed balance resistor site | 27R0 | R_0805_2012Metric | 1:(unset); 2:(unset) | 03e89028-a9c2-434c-bf7e-a57cf5912204; 0a3ffc73-9323-414d-9021-5b1cc93e5925; 375e4816-72a9-49ce-8ad5-1c3d69609da7; a132d131-243a-4d5d-acc6-45a068e5a056; c5bf5814-2f8e-4c13-a546-ff3809950a4d | shorting_items:6; solder_mask_bridge:6 | Keep exact geometry; neither pad assigned. Map both ends against the 32 host-controlled cell switches, including CELL16 and the extra 33rd site. Verify bleed current and enclosed resistor/BQ heating before fitting.
R_B10 | unresolved | Fixed balance resistor site | 27R0 | R_0805_2012Metric | 1:(unset); 2:(unset) | 0a3ff4a3-f153-4c72-8efa-a4a60af5b078; 0a3ffc73-9323-414d-9021-5b1cc93e5925; 14e523ef-6ec4-4d98-870d-8f6e042d3536; 375e4816-72a9-49ce-8ad5-1c3d69609da7; ad703a85-81e8-4dfd-b987-95a8ee20fae4 | shorting_items:6; solder_mask_bridge:6 | Keep exact geometry; neither pad assigned. Map both ends against the 32 host-controlled cell switches, including CELL16 and the extra 33rd site. Verify bleed current and enclosed resistor/BQ heating before fitting.
R_B11 | unresolved | Fixed balance resistor site | 27R0 | R_0805_2012Metric | 1:(unset); 2:(unset) | 1c23ad39-a6e0-456f-97a0-3ea9f8faca71; 88c9eb0f-dbaa-490c-8915-3c7dc3756a43; a49a7015-e607-46a6-be41-c3e3251c388e; ad703a85-81e8-4dfd-b987-95a8ee20fae4 | clearance:2; shorting_items:5; solder_mask_bridge:5 | Keep exact geometry; neither pad assigned. Map both ends against the 32 host-controlled cell switches, including CELL16 and the extra 33rd site. Verify bleed current and enclosed resistor/BQ heating before fitting.
R_B12 | unresolved | Fixed balance resistor site | 27R0 | R_0805_2012Metric | 1:(unset); 2:(unset) | 1cfb0612-c39d-4e81-bd9e-7a934c30e764; 4d63fe55-c035-4d27-85f7-c30e12b8a1ee; a49a7015-e607-46a6-be41-c3e3251c388e; e8e6e400-6635-4ee4-91a0-b84cabe4cffb | shorting_items:5; clearance:1; solder_mask_bridge:5 | Keep exact geometry; neither pad assigned. Map both ends against the 32 host-controlled cell switches, including CELL16 and the extra 33rd site. Verify bleed current and enclosed resistor/BQ heating before fitting.
R_B13 | unresolved | Fixed balance resistor site | 27R0 | R_0805_2012Metric | 1:(unset); 2:(unset) | 520615aa-b1b9-4ffb-8c13-8fde0d52f849; 6fe09220-8751-4478-806d-c33b3a51097f; 8ef16e46-5d6e-413f-a7cc-a4aa34bfdefc | shorting_items:4; solder_mask_bridge:4 | Keep exact geometry; neither pad assigned. Map both ends against the 32 host-controlled cell switches, including CELL16 and the extra 33rd site. Verify bleed current and enclosed resistor/BQ heating before fitting.
R_B14 | unresolved | Fixed balance resistor site | 27R0 | R_0805_2012Metric | 1:(unset); 2:(unset) | 6a3f7783-1218-42f2-a6bc-f46290b85992; 76362865-0e00-4144-909b-85b07fa56324; 8b351997-b438-4e0d-a387-5c59482c80ee | shorting_items:4; solder_mask_bridge:4 | Keep exact geometry; neither pad assigned. Map both ends against the 32 host-controlled cell switches, including CELL16 and the extra 33rd site. Verify bleed current and enclosed resistor/BQ heating before fitting.
R_B15 | unresolved | Fixed balance resistor site | 27R0 | R_0805_2012Metric | 1:(unset); 2:(unset) | 6419c499-7b7a-4843-b432-af4e7ad1d895; 9b76a7fa-88c6-441f-b86a-9c479413798b | shorting_items:3; solder_mask_bridge:3 | Keep exact geometry; neither pad assigned. Map both ends against the 32 host-controlled cell switches, including CELL16 and the extra 33rd site. Verify bleed current and enclosed resistor/BQ heating before fitting.
R_B16 | unresolved | Fixed balance resistor site | 27R0 | R_0805_2012Metric | 1:(unset); 2:(unset) | 0623c4c1-325f-4647-b996-97681bcf63b2; 9b76a7fa-88c6-441f-b86a-9c479413798b; fe740cbb-e7d3-45ec-8b1d-f40c1c6d83e1 | shorting_items:4; solder_mask_bridge:4 | Keep exact geometry; neither pad assigned. Map both ends against the 32 host-controlled cell switches, including CELL16 and the extra 33rd site. Verify bleed current and enclosed resistor/BQ heating before fitting.
R_B17 | unresolved | Fixed balance resistor site | 27R0 | R_0805_2012Metric | 1:(unset); 2:(unset) | 2cb1a396-a03b-45c8-a026-0f1e82673e02; 586993ac-07ff-4a8f-8faf-9318d7787759; bd080b13-53eb-41c3-b007-0a8bc21eec54; fe740cbb-e7d3-45ec-8b1d-f40c1c6d83e1 | shorting_items:5; clearance:2; solder_mask_bridge:5 | Keep exact geometry; neither pad assigned. Map both ends against the 32 host-controlled cell switches, including CELL16 and the extra 33rd site. Verify bleed current and enclosed resistor/BQ heating before fitting.
R_B18 | unresolved | Fixed balance resistor site | 27R0 | R_0805_2012Metric | 1:(unset); 2:(unset) | 03688cb9-d38d-4c0f-b457-6feeb11c251f; 22d3f97e-d432-43dc-96e8-b625041d059a; 586993ac-07ff-4a8f-8faf-9318d7787759; afa7b0a2-981e-4821-ba5d-33f6975ea3e9 | shorting_items:5; clearance:1; solder_mask_bridge:5 | Keep exact geometry; neither pad assigned. Map both ends against the 32 host-controlled cell switches, including CELL16 and the extra 33rd site. Verify bleed current and enclosed resistor/BQ heating before fitting.
R_B19 | unresolved | Fixed balance resistor site | 27R0 | R_0805_2012Metric | 1:(unset); 2:(unset) | 216a3aa9-81ed-46e1-8d3c-1dbea598c9c0; 81a09f16-38e7-4146-bb8c-fe41232691a0; f733a13a-3426-42c0-8f8c-b8a1c2b71d68 | shorting_items:4; solder_mask_bridge:4 | Keep exact geometry; neither pad assigned. Map both ends against the 32 host-controlled cell switches, including CELL16 and the extra 33rd site. Verify bleed current and enclosed resistor/BQ heating before fitting.
R_B20 | unresolved | Fixed balance resistor site | 27R0 | R_0805_2012Metric | 1:(unset); 2:(unset) | 34dc24cd-b661-44c6-b551-ecc398e4ceeb; b1afb5f6-e7f6-4ed9-8512-706447a7483a; c1b2e774-5423-482f-a6b1-8972e48aaf22; c9103990-72bb-42a6-9331-aae9b2ccff01; f9100544-fcba-45fb-ad8a-c7b2f56a93ba | shorting_items:6; solder_mask_bridge:6 | Keep exact geometry; neither pad assigned. Map both ends against the 32 host-controlled cell switches, including CELL16 and the extra 33rd site. Verify bleed current and enclosed resistor/BQ heating before fitting.
R_B21 | unresolved | Fixed balance resistor site | 27R0 | R_0805_2012Metric | 1:(unset); 2:(unset) | 2d183c69-8923-4a64-8f92-ef1359515868; 34dc24cd-b661-44c6-b551-ecc398e4ceeb; 772136ae-f53d-4922-a7a4-9fa80ef17fcb; 97a5b69e-efe6-4be8-ae84-2d2a2a83b579 | shorting_items:5; solder_mask_bridge:5 | Keep exact geometry; neither pad assigned. Map both ends against the 32 host-controlled cell switches, including CELL16 and the extra 33rd site. Verify bleed current and enclosed resistor/BQ heating before fitting.
R_B22 | unresolved | Fixed balance resistor site | 27R0 | R_0805_2012Metric | 1:(unset); 2:(unset) | 2d183c69-8923-4a64-8f92-ef1359515868; 37b00c35-4c9b-484a-a732-575b41b06c8a; e666dc6f-dbeb-4a33-b5a7-9fde58963f3c | shorting_items:4; clearance:1; solder_mask_bridge:4 | Keep exact geometry; neither pad assigned. Map both ends against the 32 host-controlled cell switches, including CELL16 and the extra 33rd site. Verify bleed current and enclosed resistor/BQ heating before fitting.
R_B23 | unresolved | Fixed balance resistor site | 27R0 | R_0805_2012Metric | 1:(unset); 2:(unset) | 58c773ce-6c69-4f86-88e2-f3b33c0dfbcc; e666dc6f-dbeb-4a33-b5a7-9fde58963f3c | shorting_items:3; solder_mask_bridge:3 | Keep exact geometry; neither pad assigned. Map both ends against the 32 host-controlled cell switches, including CELL16 and the extra 33rd site. Verify bleed current and enclosed resistor/BQ heating before fitting.
R_B24 | unresolved | Fixed balance resistor site | 27R0 | R_0805_2012Metric | 1:(unset); 2:(unset) | ba0bb26c-f1ca-4ba5-8fc6-42fd9706a863; bea76a15-6c86-4e74-bca3-4bc272c48177 | shorting_items:3; solder_mask_bridge:3 | Keep exact geometry; neither pad assigned. Map both ends against the 32 host-controlled cell switches, including CELL16 and the extra 33rd site. Verify bleed current and enclosed resistor/BQ heating before fitting.
R_B25 | unresolved | Fixed balance resistor site | 27R0 | R_0805_2012Metric | 1:(unset); 2:(unset) | 37e51e6a-242a-42c6-80a5-1a8f65bff5ca; 744d51ac-289a-481d-aef7-bb37107a656b; cf338bf8-ab16-481d-ba31-b6fd06cb1271 | shorting_items:4; solder_mask_bridge:4 | Keep exact geometry; neither pad assigned. Map both ends against the 32 host-controlled cell switches, including CELL16 and the extra 33rd site. Verify bleed current and enclosed resistor/BQ heating before fitting.
R_B26 | unresolved | Fixed balance resistor site | 27R0 | R_0805_2012Metric | 1:(unset); 2:(unset) | 29821cf6-140b-4baa-b91b-24ef7cc3318a; 396ff50d-9462-4cfb-9359-8b02e02754b9; 91605922-a14f-41bd-b166-53e250eada80; b0fda0f6-47f8-45e5-8004-ba1f8d315bc1; ddcf9c3f-2e8e-4fca-81ea-06d1bde1d78a | shorting_items:6; solder_mask_bridge:6 | Keep exact geometry; neither pad assigned. Map both ends against the 32 host-controlled cell switches, including CELL16 and the extra 33rd site. Verify bleed current and enclosed resistor/BQ heating before fitting.
R_B27 | unresolved | Fixed balance resistor site | 27R0 | R_0805_2012Metric | 1:(unset); 2:(unset) | 1480a4a9-e10b-4758-b24f-39cfc669d18f; cbbc416c-671f-4266-87a8-49f27dcacfd9; ddcf9c3f-2e8e-4fca-81ea-06d1bde1d78a; e0f7742e-6047-4217-a01b-c224e5fa941f | shorting_items:5; solder_mask_bridge:5 | Keep exact geometry; neither pad assigned. Map both ends against the 32 host-controlled cell switches, including CELL16 and the extra 33rd site. Verify bleed current and enclosed resistor/BQ heating before fitting.
R_B28 | unresolved | Fixed balance resistor site | 27R0 | R_0805_2012Metric | 1:(unset); 2:(unset) | 0c897661-ed6f-437a-88d0-72304a539fb9; 72f8ee5a-f692-40f4-b82f-f5b0c83813ad; 8bc92fa5-f9be-466e-94a5-f2c26149b35e; 9ea37583-abb1-4e86-9b43-f0ce59f690c9; e0f7742e-6047-4217-a01b-c224e5fa941f | shorting_items:6; clearance:1; solder_mask_bridge:6 | Keep exact geometry; neither pad assigned. Map both ends against the 32 host-controlled cell switches, including CELL16 and the extra 33rd site. Verify bleed current and enclosed resistor/BQ heating before fitting.
R_B29 | unresolved | Fixed balance resistor site | 27R0 | R_0805_2012Metric | 1:(unset); 2:(unset) | 06457be1-40ba-4ab1-97b2-733989a053e1; 60a72fdf-f73c-470a-ac1f-4e3fe05f030a; 72f8ee5a-f692-40f4-b82f-f5b0c83813ad; 75d5b4bf-3c8c-42ad-b62e-7c130de5c676; 9ea37583-abb1-4e86-9b43-f0ce59f690c9 | shorting_items:6; clearance:1; solder_mask_bridge:6 | Keep exact geometry; neither pad assigned. Map both ends against the 32 host-controlled cell switches, including CELL16 and the extra 33rd site. Verify bleed current and enclosed resistor/BQ heating before fitting.
R_B30 | unresolved | Fixed balance resistor site | 27R0 | R_0805_2012Metric | 1:(unset); 2:(unset) | 60a72fdf-f73c-470a-ac1f-4e3fe05f030a; 9ea37583-abb1-4e86-9b43-f0ce59f690c9; a0deb8d4-ed68-43e8-94ed-dc0ee11a3b68; bd5cf777-af7e-4795-b38d-15b9ca5780ba | shorting_items:5; solder_mask_bridge:5 | Keep exact geometry; neither pad assigned. Map both ends against the 32 host-controlled cell switches, including CELL16 and the extra 33rd site. Verify bleed current and enclosed resistor/BQ heating before fitting.
R_B31 | unresolved | Fixed balance resistor site | 27R0 | R_0805_2012Metric | 1:(unset); 2:(unset) | 108887f3-29b2-4f3b-b6f5-771924caf4f3; 60a72fdf-f73c-470a-ac1f-4e3fe05f030a; bd5cf777-af7e-4795-b38d-15b9ca5780ba | shorting_items:4; solder_mask_bridge:4 | Keep exact geometry; neither pad assigned. Map both ends against the 32 host-controlled cell switches, including CELL16 and the extra 33rd site. Verify bleed current and enclosed resistor/BQ heating before fitting.
R_B32 | unresolved | Fixed balance resistor site | 27R0 | R_0805_2012Metric | 1:(unset); 2:(unset) | 89fd579c-8a08-4923-b7d5-ddd4c66217d3; bd5cf777-af7e-4795-b38d-15b9ca5780ba | shorting_items:3; solder_mask_bridge:3 | Keep exact geometry; neither pad assigned. Map both ends against the 32 host-controlled cell switches, including CELL16 and the extra 33rd site. Verify bleed current and enclosed resistor/BQ heating before fitting.
R_B33 | unresolved | Fixed balance resistor site | 27R0 | R_0805_2012Metric | 1:(unset); 2:(unset) | none | none on these IDs | Keep exact geometry; neither pad assigned. Map both ends against the 32 host-controlled cell switches, including CELL16 and the extra 33rd site. Verify bleed current and enclosed resistor/BQ heating before fitting.
R_CHG1 | unresolved | Charger interface resistor candidate | 100k | R_0603_1608Metric | 1:(unset); 2:(unset) | none | courtyards_overlap:1 | 100k with no assigned nets. Establish whether bias, sensing or bleed; check division ratio, resistor working voltage and dissipation at max charger voltage.
R_CHG2 | unresolved | Charger interface resistor candidate | 2203 | R_0805_2012Metric | 1:(unset); 2:(unset) | adae2e6a-3f1f-449b-b9f8-1290c95b8431 | shorting_items:2; solder_mask_bridge:2 | 2203 marking with empty nets; both pads touch charger-area copper. Trace intended divider/bleed endpoints and establish voltage/power rating.
R_DSG1 | unresolved | Unassigned resistor near retired FET | 1000 | R_0805_2012Metric | 1:(unset); 2:(unset) | none | courtyards_overlap:1 | No assigned nets or direct copper contact; the schematic DSG series part is R_G2, not this reference. Match pads to an independently traced gate/source path or BOM before deleting.
R_F1 | required | Series cell-tap input | 20R | R_0402_1005Metric | 1:CELL32; 2:BQ2_VC16 | c659ec06-221b-4f22-ac53-9cc23e0ade5d | none on these IDs | Retain per-cell series function; see tap-to-VC pair. Check 20 ohm against selected balancing topology, pulse stress and TI input/filter limits. Resolve shorts and crossings before routing.
R_F2 | required | Series cell-tap input | 20R | R_0402_1005Metric | 1:CELL31; 2:BQ2_VC15 | 6d2d05fd-040e-4069-9f62-4fa9243661d5 | none on these IDs | Retain per-cell series function; see tap-to-VC pair. Check 20 ohm against selected balancing topology, pulse stress and TI input/filter limits. Resolve shorts and crossings before routing.
R_F3 | required | Series cell-tap input | 20R | R_0402_1005Metric | 1:CELL30; 2:BQ2_VC14 | 04e8fbfe-18fc-48c7-b647-a7b97d485a80 | none on these IDs | Retain per-cell series function; see tap-to-VC pair. Check 20 ohm against selected balancing topology, pulse stress and TI input/filter limits. Resolve shorts and crossings before routing.
R_F4 | required | Series cell-tap input | 20R | R_0402_1005Metric | 1:CELL29; 2:BQ2_VC13 | 76797bb9-301b-4f5c-bfc9-c3e4b48315e2 | none on these IDs | Retain per-cell series function; see tap-to-VC pair. Check 20 ohm against selected balancing topology, pulse stress and TI input/filter limits. Resolve shorts and crossings before routing.
R_F5 | required | Series cell-tap input | 20R | R_0402_1005Metric | 1:CELL28; 2:BQ2_VC12 | be5170c9-17db-4198-b059-00a9acbc3ef0 | none on these IDs | Retain per-cell series function; see tap-to-VC pair. Check 20 ohm against selected balancing topology, pulse stress and TI input/filter limits. Resolve shorts and crossings before routing.
R_F6 | required | Series cell-tap input | 20R | R_0402_1005Metric | 1:CELL27; 2:BQ2_VC11 | 3deae128-85fc-42dc-908b-5dcb99afe75e | none on these IDs | Retain per-cell series function; see tap-to-VC pair. Check 20 ohm against selected balancing topology, pulse stress and TI input/filter limits. Resolve shorts and crossings before routing.
R_F7 | required | Series cell-tap input | 20R | R_0402_1005Metric | 1:CELL26; 2:BQ2_VC10 | 9cf9ade6-59bf-4f94-af42-48108bf93ce9 | none on these IDs | Retain per-cell series function; see tap-to-VC pair. Check 20 ohm against selected balancing topology, pulse stress and TI input/filter limits. Resolve shorts and crossings before routing.
R_F8 | required | Series cell-tap input | 20R | R_0402_1005Metric | 1:CELL25; 2:BQ2_VC9 | 8543df04-19b7-4311-a039-8d2660d97b4b | none on these IDs | Retain per-cell series function; see tap-to-VC pair. Check 20 ohm against selected balancing topology, pulse stress and TI input/filter limits. Resolve shorts and crossings before routing.
R_F9 | required | Series cell-tap input | 20R | R_0402_1005Metric | 1:CELL24; 2:BQ2_VC8 | c5bf5814-2f8e-4c13-a546-ff3809950a4d | none on these IDs | Retain per-cell series function; see tap-to-VC pair. Check 20 ohm against selected balancing topology, pulse stress and TI input/filter limits. Resolve shorts and crossings before routing.
R_F10 | required | Series cell-tap input | 20R | R_0402_1005Metric | 1:CELL23; 2:BQ2_VC7 | 0a3ff4a3-f153-4c72-8efa-a4a60af5b078 | none on these IDs | Retain per-cell series function; see tap-to-VC pair. Check 20 ohm against selected balancing topology, pulse stress and TI input/filter limits. Resolve shorts and crossings before routing.
R_F11 | required | Series cell-tap input | 20R | R_0402_1005Metric | 1:CELL22; 2:BQ2_VC6 | 88c9eb0f-dbaa-490c-8915-3c7dc3756a43 | none on these IDs | Retain per-cell series function; see tap-to-VC pair. Check 20 ohm against selected balancing topology, pulse stress and TI input/filter limits. Resolve shorts and crossings before routing.
R_F12 | required | Series cell-tap input | 20R | R_0402_1005Metric | 1:CELL21; 2:BQ2_VC5 | 1cfb0612-c39d-4e81-bd9e-7a934c30e764 | none on these IDs | Retain per-cell series function; see tap-to-VC pair. Check 20 ohm against selected balancing topology, pulse stress and TI input/filter limits. Resolve shorts and crossings before routing.
R_F13 | required | Series cell-tap input | 20R | R_0402_1005Metric | 1:CELL20; 2:BQ2_VC4 | 520615aa-b1b9-4ffb-8c13-8fde0d52f849 | none on these IDs | Retain per-cell series function; see tap-to-VC pair. Check 20 ohm against selected balancing topology, pulse stress and TI input/filter limits. Resolve shorts and crossings before routing.
R_F14 | required | Series cell-tap input | 20R | R_0402_1005Metric | 1:CELL19; 2:BQ2_VC3 | 8b351997-b438-4e0d-a387-5c59482c80ee | none on these IDs | Retain per-cell series function; see tap-to-VC pair. Check 20 ohm against selected balancing topology, pulse stress and TI input/filter limits. Resolve shorts and crossings before routing.
R_F15 | required | Series cell-tap input | 20R | R_0402_1005Metric | 1:CELL18; 2:BQ2_VC2 | 6419c499-7b7a-4843-b432-af4e7ad1d895 | none on these IDs | Retain per-cell series function; see tap-to-VC pair. Check 20 ohm against selected balancing topology, pulse stress and TI input/filter limits. Resolve shorts and crossings before routing.
R_F16 | required | Series cell-tap input | 20R | R_0402_1005Metric | 1:CELL17; 2:BQ2_VC1 | 0623c4c1-325f-4647-b996-97681bcf63b2 | none on these IDs | Retain per-cell series function; see tap-to-VC pair. Check 20 ohm against selected balancing topology, pulse stress and TI input/filter limits. Resolve shorts and crossings before routing.
R_F17 | required | Series cell-tap input | 20R | R_0402_1005Metric | 1:CELL16; 2:BQ1_VC16 | bd080b13-53eb-41c3-b007-0a8bc21eec54 | none on these IDs | Retain per-cell series function; see tap-to-VC pair. Check 20 ohm against selected balancing topology, pulse stress and TI input/filter limits. Resolve shorts and crossings before routing.
R_F18 | required | Series cell-tap input | 20R | R_0402_1005Metric | 1:CELL15; 2:BQ1_VC15 | 22d3f97e-d432-43dc-96e8-b625041d059a | none on these IDs | Retain per-cell series function; see tap-to-VC pair. Check 20 ohm against selected balancing topology, pulse stress and TI input/filter limits. Resolve shorts and crossings before routing.
R_F19 | required | Series cell-tap input | 20R | R_0402_1005Metric | 1:CELL14; 2:BQ1_VC14 | f733a13a-3426-42c0-8f8c-b8a1c2b71d68 | none on these IDs | Retain per-cell series function; see tap-to-VC pair. Check 20 ohm against selected balancing topology, pulse stress and TI input/filter limits. Resolve shorts and crossings before routing.
R_F20 | required | Series cell-tap input | 20R | R_0402_1005Metric | 1:CELL13; 2:BQ1_VC13 | b1afb5f6-e7f6-4ed9-8512-706447a7483a | none on these IDs | Retain per-cell series function; see tap-to-VC pair. Check 20 ohm against selected balancing topology, pulse stress and TI input/filter limits. Resolve shorts and crossings before routing.
R_F21 | required | Series cell-tap input | 20R | R_0402_1005Metric | 1:CELL12; 2:BQ1_VC12 | 97a5b69e-efe6-4be8-ae84-2d2a2a83b579 | none on these IDs | Retain per-cell series function; see tap-to-VC pair. Check 20 ohm against selected balancing topology, pulse stress and TI input/filter limits. Resolve shorts and crossings before routing.
R_F22 | required | Series cell-tap input | 20R | R_0402_1005Metric | 1:CELL11; 2:BQ1_VC11 | 37b00c35-4c9b-484a-a732-575b41b06c8a | none on these IDs | Retain per-cell series function; see tap-to-VC pair. Check 20 ohm against selected balancing topology, pulse stress and TI input/filter limits. Resolve shorts and crossings before routing.
R_F23 | required | Series cell-tap input | 20R | R_0402_1005Metric | 1:CELL10; 2:BQ1_VC10 | 58c773ce-6c69-4f86-88e2-f3b33c0dfbcc | none on these IDs | Retain per-cell series function; see tap-to-VC pair. Check 20 ohm against selected balancing topology, pulse stress and TI input/filter limits. Resolve shorts and crossings before routing.
R_F24 | required | Series cell-tap input | 20R | R_0402_1005Metric | 1:CELL9; 2:BQ1_VC9 | ba0bb26c-f1ca-4ba5-8fc6-42fd9706a863 | none on these IDs | Retain per-cell series function; see tap-to-VC pair. Check 20 ohm against selected balancing topology, pulse stress and TI input/filter limits. Resolve shorts and crossings before routing.
R_F25 | required | Series cell-tap input | 20R | R_0402_1005Metric | 1:CELL8; 2:BQ1_VC8 | 744d51ac-289a-481d-aef7-bb37107a656b | none on these IDs | Retain per-cell series function; see tap-to-VC pair. Check 20 ohm against selected balancing topology, pulse stress and TI input/filter limits. Resolve shorts and crossings before routing.
R_F26 | required | Series cell-tap input | 20R | R_0402_1005Metric | 1:CELL7; 2:BQ1_VC7 | 29821cf6-140b-4baa-b91b-24ef7cc3318a | none on these IDs | Retain per-cell series function; see tap-to-VC pair. Check 20 ohm against selected balancing topology, pulse stress and TI input/filter limits. Resolve shorts and crossings before routing.
R_F27 | required | Series cell-tap input | 20R | R_0402_1005Metric | 1:CELL6; 2:BQ1_VC6 | cbbc416c-671f-4266-87a8-49f27dcacfd9 | none on these IDs | Retain per-cell series function; see tap-to-VC pair. Check 20 ohm against selected balancing topology, pulse stress and TI input/filter limits. Resolve shorts and crossings before routing.
R_F28 | required | Series cell-tap input | 20R | R_0402_1005Metric | 1:CELL5; 2:BQ1_VC5 | 0c897661-ed6f-437a-88d0-72304a539fb9 | none on these IDs | Retain per-cell series function; see tap-to-VC pair. Check 20 ohm against selected balancing topology, pulse stress and TI input/filter limits. Resolve shorts and crossings before routing.
R_F29 | required | Series cell-tap input | 20R | R_0402_1005Metric | 1:CELL4; 2:BQ1_VC4 | 75d5b4bf-3c8c-42ad-b62e-7c130de5c676 | none on these IDs | Retain per-cell series function; see tap-to-VC pair. Check 20 ohm against selected balancing topology, pulse stress and TI input/filter limits. Resolve shorts and crossings before routing.
R_F30 | required | Series cell-tap input | 20R | R_0402_1005Metric | 1:CELL3; 2:BQ1_VC3 | a0deb8d4-ed68-43e8-94ed-dc0ee11a3b68 | none on these IDs | Retain per-cell series function; see tap-to-VC pair. Check 20 ohm against selected balancing topology, pulse stress and TI input/filter limits. Resolve shorts and crossings before routing.
R_F31 | required | Series cell-tap input | 20R | R_0402_1005Metric | 1:CELL2; 2:BQ1_VC2 | 108887f3-29b2-4f3b-b6f5-771924caf4f3 | none on these IDs | Retain per-cell series function; see tap-to-VC pair. Check 20 ohm against selected balancing topology, pulse stress and TI input/filter limits. Resolve shorts and crossings before routing.
R_F32 | required | Series cell-tap input | 20R | R_0402_1005Metric | 1:CELL1; 2:BQ1_VC1 | 89fd579c-8a08-4923-b7d5-ddd4c66217d3 | none on these IDs | Retain per-cell series function; see tap-to-VC pair. Check 20 ohm against selected balancing topology, pulse stress and TI input/filter limits. Resolve shorts and crossings before routing.
R_G1 | unresolved | Charge gate series candidate | 01X | R_0603_1608Metric | 1:Q1_GATE; 2:SSR_OUT_CHG | none | courtyards_overlap:1 | Same two nets as R_SSR1, opposite pad numbering. No defined drive output on those nets. Identify 01X, measure both sites and establish intended single/parallel gate impedance.
R_GS1 | unresolved | Charge gate-to-source bias | 474 | R_0603_1608Metric | 1:Q1_GATE; 2:CHG+ | none | courtyards_overlap:1 | Q1_GATE to CHG+ gives source reference; confirm 474 value, reset leakage, discharge time and no conflict with R_SSR2.
R_S1 | unresolved | Candidate sense/protection resistor | 1000 | R_0805_2012Metric | 1:(unset); 2:(unset) | cad39c70-0b10-448b-a789-0bdbc12c340d | shorting_items:1; solder_mask_bridge:1 | Unassigned; second pad touches the shunt-area graphic. Trace both ends to Kelvin taps, ADC or protection device; decipher marking, check common mode and gain before assigning.
R_S2 | unresolved | Candidate sense/protection resistor | 1000 | R_0805_2012Metric | 1:(unset); 2:(unset) | cad39c70-0b10-448b-a789-0bdbc12c340d | shorting_items:1; solder_mask_bridge:1; courtyards_overlap:1 | Unassigned; second pad touches the shunt-area graphic. Trace both ends to Kelvin taps, ADC or protection device; decipher marking, check common mode and gain before assigning.
R_SEC1 | unresolved | Unidentified local resistor | 01X | R_0603_1608Metric | 1:(unset); 2:(unset) | none | none on these IDs | 01X marking with no assigned net. Trace reference board terminals to monitor/driver; decode resistance and tolerance before allocating.
R_SH1 | unresolved | Charge-current shunt candidate | R001 | R_2512_6332Metric | 1:CELL0; 2:SHUNT_MID | b1145db9-14c1-4999-ab3f-bca64a976399 | shorting_items:2; solder_mask_bridge:2; courtyards_overlap:2 | Assigned series midpoint; not a verified Kelvin pickup. Select one effective sense resistance and polarity; check four-wire resistance/known-current gain, version-2 sign and Lisp -0.2. Do not delete either site on draft evidence.
R_SH2 | unresolved | Charge-current shunt candidate | R001 | R_2512_6332Metric | 1:SHUNT_MID; 2:CHG- | cad39c70-0b10-448b-a789-0bdbc12c340d | shorting_items:1; solder_mask_bridge:1 | Assigned series midpoint; not a verified Kelvin pickup. Select one effective sense resistance and polarity; check four-wire resistance/known-current gain, version-2 sign and Lisp -0.2. Do not delete either site on draft evidence.
R_SSR1 | unresolved | Charge gate series candidate | 01X | R_0603_1608Metric | 1:SSR_OUT_CHG; 2:Q1_GATE | none | courtyards_overlap:2 | Electrically parallel with R_G1 by assignment; neither marking nor equivalence identifies which site to depopulate. Identify actual parts and qualify driver timing.
R_SSR2 | replacement needed | Ground-referenced charge gate pull | 10k | R_0603_1608Metric | 1:Q1_GATE; 2:GND | none | courtyards_overlap:1 | Replace the gate-to-GND connection with a reviewed source-referenced default-off drive. CHG+ is the moving source; a 10k path to GND can load the clamp. Retain site pending driver design; do not energize as drawn.
U4 | unresolved | Host power converter candidate | LTC7138 | Package_SO:Analog_MSOP-12-16-1EP_3x4.039mm_P0.5mm_EP1.651x2.845mm_ThermalVias | (unnumbered):(unset) x4; 1:(unset); 3:(unset); 5:(unset); 6:(unset); 7:(unset); 8:(unset); 9:(unset); 10:(unset); 11:(unset); 12:(unset); 14:(unset); 16:(unset); 17:(unset) x8 | none | drill_out_of_range:6 | All pads unset. Identify input node, divider and startup/UVLO; establish headroom to 140 V operating ceiling and 400 mA capability vs RF peak, peripherals and converter limits. No bench interface substitutes for this analysis.
U7 | required | Isolated CAN transceiver | ISO1050 (DUB-8) | Package_DIP:SMDIP-8_W9.53mm | 1:+3V3; 2:CAN_RX; 3:CAN_TX; 4:GND; 5:ISO_GND; 6:CANL; 7:CANH; 8:5VExt | none | lib_footprint_mismatch:1 | TI ISO1050DUB pin functions match assignments; GPIO6 RX and GPIO7 TX still unconnected at ESP. Verify DUB land pattern vs generic SMDIP, both supplies, bypass, isolation, termination and harness ESD.
U_BQ1 | required | Lower 16-cell monitor | BQ7695202 (IC1) | TQFP-48-1EP_7x7mm_P0.5mm_EP5x5mm_ThermalVias | (unnumbered):(unset) x16; 1:BQ1_VC15; 2:BQ1_VC14; 3:BQ1_VC13; 4:BQ1_VC12; 5:BQ1_VC11; 6:BQ1_VC10; 7:BQ1_VC9; 8:BQ1_VC8; 9:BQ1_VC7; 10:BQ1_VC6; 11:BQ1_VC5; 12:BQ1_VC4; 13:BQ1_VC3; 14:BQ1_VC2; 15:BQ1_VC1; 16:CELL0; 17:GND; 18:SRP; 19:(unset); 20:SRN; 21:TS1; 22:TS2; 23:TS3; 24:(unset); 25:(unset); 26:(unset); 27:(unset); 28:(unset); 29:(unset); 30:(unset); 31:(unset); 32:(unset); 33:(unset); 34:(unset); 35:(unset); 36:(unset); 37:(unset); 38:(unset); 39:(unset); 40:(unset); 41:(unset); 42:(unset); 43:(unset); 44:(unset); 45:(unset); 46:(unset); 47:BQ1_BAT; 48:BQ1_VC16; 49:(unset) x27 | none | drill_out_of_range:25 | Keep region. Pin16 CELL0 vs pin17 GND, EP unset. Reconcile local VSS/EP, BAT/regulators, Kelvin SRP/N, local I2C, five temperature inputs and TS2 wake before any import.
U_BQ2 | required | Upper 16-cell monitor | BQ7695202 (IC2) | TQFP-48-1EP_7x7mm_P0.5mm_EP5x5mm_ThermalVias | (unnumbered):(unset) x16; 1:BQ2_VC15; 2:BQ2_VC14; 3:BQ2_VC13; 4:BQ2_VC12; 5:BQ2_VC11; 6:BQ2_VC10; 7:BQ2_VC9; 8:BQ2_VC8; 9:BQ2_VC7; 10:BQ2_VC6; 11:BQ2_VC5; 12:BQ2_VC4; 13:BQ2_VC3; 14:BQ2_VC2; 15:BQ2_VC1; 16:CELL16; 17:GND; 18:SRP; 19:(unset); 20:SRN; 21:TS4; 22:(unset); 23:(unset); 24:(unset); 25:(unset); 26:(unset); 27:(unset); 28:(unset); 29:(unset); 30:(unset); 31:(unset); 32:(unset); 33:(unset); 34:(unset); 35:(unset); 36:(unset); 37:(unset); 38:(unset); 39:(unset); 40:(unset); 41:(unset); 42:(unset); 43:(unset); 44:(unset); 45:(unset); 46:(unset); 47:BQ2_BAT; 48:BQ2_VC16; 49:(unset) x27 | none | drill_out_of_range:25 | Keep region. Pin16 CELL16 but pin17 shared GND, 18/20 cross to lower sense, EP unset. Upper VSS, EP, unused sense pins, rails and wake must reference CELL16; isolate/gate I2C.
U_ESP1 | required | Charge policy, communications and programming host | ESP32-C3-MINI-1 | ESP32-C3-MINI-1 | 1:(unset); 2:(unset); 3:(unset); 4:(unset); 5:(unset); 6:(unset); 7:(unset); 8:(unset); 9:(unset); 10:(unset); 11:(unset); 12:(unset); 13:(unset); 14:(unset); 15:(unset); 16:(unset); 17:(unset); 18:(unset); 19:(unset); 20:(unset); 21:(unset); 22:(unset); 23:(unset); 24:(unset); 25:(unset); 26:(unset); 27:(unset); 28:(unset); 29:(unset); 30:(unset); 31:(unset); 32:(unset); 33:(unset); 34:(unset); 35:(unset); 36:(unset); 37:(unset); 38:(unset); 39:(unset); 40:(unset); 41:(unset); 42:(unset); 43:(unset); 44:(unset); 45:(unset); 46:(unset); 47:(unset); 48:(unset); 49:(unset) x9; 50:(unset); 51:(unset); 52:(unset); 53:(unset) | none | none on these IDs | All module pads unset; preserve antenna keepout. Implement verified module pad mapping, EN/reset, strap pulls and isolated download access; close independent host power budget.
U_SSR1 | unresolved | Switch/control driver candidate | GSRELAY | qfbms:H2440_SSR | 1:PIN_CHG_EN; 2:PIN_OUT_EN; 3:PIN_PSW_EN; 4:GND; 5:VBOOST; 6:CELL32; 7:(unset); 8:(unset) | 54e72a69-04ce-4670-84c2-8265789133cf; b2c6f66b-a90a-4469-af9e-4e42582c706e; bc18f3c3-a5be-430a-ae5a-b4c686999794 | courtyards_overlap:1 | GSRELAY mark does not identify H2440. Both charge and legacy controls present, 7/8 unset; not discharge-exclusive. Obtain exact pinout, isolation, drive energy, truth table, timing and safe reset behavior.
