Focerqc/QFBMS/_reference/ti_bq76952/SLUC687A/sluc687/BQ76952_2Layer_TestBoard/PR2410A(001)_BOM.xlsx

Fitted | Description | Designator | PartNumber | Quantity | Manufacturer | PackageReference | Value | Alternate Manufacturer | Alternate PartNumber
Fitted | Printed Circuit Board | !PCB1 | PR2410 | 1 | Any
Fitted | CAP, CERM, 1 uF, 100 V, +/- 10%, X7R, 1206 | C1, C13 | C3216X7R2A105K160AA | 2 | TDK | 1206 | 1uF
Fitted | CAP, CERM, 100 pF, 100 V, +/- 5%, C0G/NP0, AEC-Q200 Grade 1, 0603 | C2, C26 | GCM1885C2A101JA16D | 2 | MuRata | 0603 | 100pF
Fitted | CAP, CERM, 0.22 uF, 50 V, +/- 10%, X7R, 0603 | C3, C4, C6, C7, C8, C9, C10, C11, C12, C14, C17, C18, C19, C20, C21, C22, C23 | C1608X7R1H224K080AB | 17 | TDK | 0603 | 0.22uF
Fitted | CAP, CERM, 0.47 uF, 25 V, +/- 10%, X7R, AEC-Q200 Grade 1, 0805 | C5 | GCM219R71E474KA55D | 1 | MuRata | 0805 | 0.47uF
Fitted | CAP, CERM, 1 uF, 16 V, +/- 10%, X7R, 0805 | C15 | EMK212B7105KG-T | 1 | Taiyo Yuden | 0805 | 1uF
Fitted | CAP, CERM, 0.022 uF, 16 V, +/- 10%, X7R, 0603 | C16 | C0603C223K4RACTU | 1 | Kemet | 0603 | 0.022uF
Fitted | CAP, CERM, 2.2 uF, 16 V, +/- 10%, X7R, 0805 | C24 | EMK212B7225KG-T | 1 | Taiyo Yuden | 0805 | 2.2uF
Fitted | CAP, CERM, 0.1 uF, 50 V, +/- 10%, X7R, 0603 | C27, C32 | 885012206095 | 2 | Wurth Elektronik | 0603 | 0.1uF
Fitted | CAP, CERM, 0.1 uF, 100 V,+/- 10%, X7R, AEC-Q200 Grade 1, 0603 | C28, C29, C30, C31 | GCJ188R72A104KA01D | 4 | MuRata | 0603 | 0.1uF
Fitted | Diode, Schottky, 100 V, 0.15 A, SOD-123 | D1, D2, D10 | BAT46W-7-F | 3 | Diodes Inc. | SOD-123 | 100V
Fitted | LED, Red, SMD | D4 | 150060RS75000 | 1 | Wurth Elektronik | LED_0603 | Red
Fitted | Diode, Zener, 16 V, 500 mW, SOD-123 | D5, D6, D7 | MMSZ5246B-7-F | 3 | Diodes Inc. | SOD-123 | 16V
Fitted | Diode, Ultrafast, 100 V, 0.15 A, SOD-123 | D8 | 1N4148W-7-F | 1 | Diodes Inc. | SOD-123 | 100V
Fitted | Diode, Zener, 10 V, 500 mW, SOD-123 | D9 | MMSZ4697T1G | 1 | ON Semiconductor | SOD-123 | 10V
Fitted | Bumpon, Hemisphere, 0.44 X 0.20, Clear | H1, H2, H3, H4 | SJ-5303 (CLEAR) | 4 | 3M | Transparent Bumpon
Fitted | Terminal Block, 9 Pos, 3.5mm | H5, H7 | 39500-0006 | 2 | Molex
Fitted | Terminal Block, 9 Pos, 3.5mm | H6 | 39500-0005 | 1 | Molex
Fitted | Terminal Block Header, 3.5mm 6x1, Tin, R/A, TH | J1, J3 | 395021006 | 2 | Molex | Header, 6x1 R/A
Fitted | Header (shrouded), 3.5mm, 5x1, R/A, TH | J2 | 395021005 | 1 | Molex | 19.03x7.03x9.33 mm
Fitted | Header (friction lock), 100mil, 4x1, R/A, TH | J4 | 0022053041 | 1 | Molex | 4x1 R/A Header
Fitted | Header, 100mil, 2x1, Tin, TH | J5 | PEC02SAAN | 1 | Sullins Connector Solutions | Header, 2 PIN, 100mil, Tin
Fitted | TERM BLOCK 3.5MM VERT 4POS PCB | J6 | OSTTE040161 | 1 | On Shore Technology | HDR4
Fitted | Transistor, NPN, 150 V, 1 A, AEC-Q101, SOT-89 | Q1 | FCX495TA | 1 | Diodes Inc. | SOT-89 | 150 V
Fitted | MOSFET, N-CH, 150 V, 56 A, PG-TDSON-8 | Q2, Q3 | BSC160N15NS5ATMA1 | 2 | Infineon Technologies | PG-TDSON-8 | 150V | None
Fitted | MOSFET, N-CH, 60 V, 0.31 A, SOT-323 | Q4 | 2N7002KW | 1 | Fairchild Semiconductor | SOT-323 | 60V | None
Fitted | MOSFET, N-CH, 100 V, 1.9 A, SOT-23 | Q5 | PMV213SN,215 | 1 | Nexperia | SOT-23 | 100V | None
Fitted | RES, 100, 1%, 0.5 W, AEC-Q200 Grade 0, 1210 | R1 | CRCW1210100RFKEA | 1 | Vishay-Dale | 1210 | 100
Fitted | RES, 20, 5%, 0.5 W, 1210 | R2, R3, R4, R5, R6, R7, R8, R10, R11, R12, R13, R14, R16, R17, R18, R19, R21 | ERJ-14YJ200U | 17 | Panasonic | 1210 | 20
Fitted | RES, 300, 5%, 1 W, AEC-Q200 Grade 0, 2512 | R9 | CRCW2512300RJNEG | 1 | Vishay-Dale | 2512 | 300
Fitted | RES, 1.0 k, 5%, 0.1 W, AEC-Q200 Grade 0, 0603 | R15, R20, R22 | CRCW06031K00JNEA | 3 | Vishay-Dale | 0603 | 1.0k
Fitted | RES, 10 k, 5%, 0.1 W, AEC-Q200 Grade 0, 0603 | R23, R24, R27, R35 | CRCW060310K0JNEA | 4 | Vishay-Dale | 0603 | 10k
Fitted | RES, 100, 5%, 0.1 W, AEC-Q200 Grade 0, 0603 | R25, R26 | CRCW0603100RJNEA | 2 | Vishay-Dale | 0603 | 100
Fitted | RES, 0.001, 1%, 1 W, 1210 | R28 | PMR25HZPFV1L00 | 1 | Rohm | 1210 | 0.001
Fitted | RES, 7.5 k, 5%, 0.25 W, AEC-Q200 Grade 0, 1206 | R29, R30 | CRCW12067K50JNEA | 2 | Vishay-Dale | 1206 | 7.5k
Fitted | RES, 10 M, 5%, 0.1 W, AEC-Q200 Grade 0, 0603 | R31, R32, R33 | CRCW060310M0JNEA | 3 | Vishay-Dale | 0603 | 10Meg
Fitted | RES, 0, 5%, 0.1 W, AEC-Q200 Grade 0, 0603 | R34 | CRCW06030000Z0EA | 1 | Vishay-Dale | 0603 | 0
Fitted | RES, 5.1 k, 5%, 0.1 W, AEC-Q200 Grade 0, 0603 | R36, R37 | CRCW06035K10JNEA | 2 | Vishay-Dale | 0603 | 5.1k
Fitted | RES, 20 k, 5%, 0.1 W, AEC-Q200 Grade 0, 0603 | R38 | CRCW060320K0JNEA | 1 | Vishay-Dale | 0603 | 20k
Fitted | RES, 5.1 k, 5%, 0.25 W, AEC-Q200 Grade 0, 1206 | R39, R41, R42, R43, R44, R45 | CRCW12065K10JNEA | 6 | Vishay-Dale | 1206 | 5.1k
Fitted | RES, 7.50 k, 1%, 0.1 W, AEC-Q200 Grade 0, 0603 | R40 | CRCW06037K50FKEA | 1 | Vishay-Dale | 0603 | 7.50k
Fitted | Thermistor NTC, 10.0k ohm, 1%, Disc, 5x8.4 mm | RT1, RT2 | 103AT-2 | 2 | SEMITEC Corporation | Disc, 5x8.4 mm | 10k
Fitted | Shunt, 100mil, Gold plated, Black | SH-J1 | SNT-100-BK-G | 1 | Samtec | Shunt | 1x2 | 3M | 969102-0000-DA
Fitted | Test Point, Compact, Black, TH | TP8, TP9, TP10, TP11 | 5006 | 4 | Keystone | Black Compact Testpoint
Fitted | Multicell Battery Monitor and Protection Family, PFB0048A (TQFP-48) | U1 | bq76952PFBR | 1 | Texas Instruments | PFB0048A |  | Texas Instruments | bq76952PFBT
Fitted | Single-Channel ESD in 0402 Package With 10pF Capacitance and 6V Breakdown, DPY0002A (X1SON-2) | U2, U3 | TPD1E10B06DPYR | 2 | Texas Instruments | DPY0002A |  | Texas Instruments | TPD1E10B06DPYT
Not Fitted | Fiducial mark. There is nothing to buy or mount. | FID1, FID2, FID3 | N/A | 0 | N/A | N/A
Not Fitted | Test Point, Multipurpose, Red, TH | TP2 | 5010 | 0 | Keystone | Red Multipurpose Testpoint
Not Fitted | Test Point, Multipurpose, Black, TH | TP5 | 5011 | 0 | Keystone | Black Multipurpose Testpoint
