Focerqc/QFBMS/_reference/ti_bq76952/SLUC687A/sluc687/BQ76952EVM_BoardFiles/BMS029B(001)_BOM.xls

Fitted | Description | Designator | PartNumber | Quantity | Manufacturer | PackageReference | Value | Alternate Manufacturer | Alternate PartNumber
Fitted | Printed Circuit Board | !PCB1 | BMS029 | 1 | Any
Fitted | CAP, CERM, 1 uF, 100 V, +/- 10%, X7R, 1206 | C1, C71 | C3216X7R2A105K160AA | 2 | TDK | 1206 | 1uF
Fitted | CAP, CERM, 100 pF, 100 V, +/- 5%, C0G/NP0, AEC-Q200 Grade 1, 0603 | C2 | GCM1885C2A101JA16D | 1 | MuRata | 603 | 100pF
Fitted | CAP, CERM, 0.47 uF, 25 V, +/- 10%, X7R, AEC-Q200 Grade 1, 0805 | C3 | GCM219R71E474KA55D | 1 | MuRata | 805 | 0.47uF
Fitted | CAP, CERM, 0.22 uF, 50 V, +/- 10%, X7R, 0603 | C4, C5, C6, C7, C8, C9, C10, C11, C14, C16, C17, C18, C19, C21, C22, C23, C24 | C1608X7R1H224K080AB | 17 | TDK | 603 | 0.22uF
Fitted | CAP, CERM, 1 uF, 16 V, +/- 10%, X7R, 0805 | C12, C15 | EMK212B7105KG-T | 2 | Taiyo Yuden | 805 | 1uF
Fitted | CAP, CERM, 0.022 uF, 16 V, +/- 10%, X7R, 0603 | C13 | C0603C223K4RACTU | 1 | Kemet | 603 | 0.022uF
Fitted | CAP, CERM, 0.01 uF, 16 V, +/- 10%, X7R, 0603 | C20 | 885012206040 | 1 | Wurth Elektronik | 603 | 0.01uF
Fitted | CAP, CERM, 2.2 uF, 16 V, +/- 10%, X7R, 0805 | C25 | EMK212B7225KG-T | 1 | Taiyo Yuden | 805 | 2.2uF
Fitted | CAP, CERM, 100 pF, 50 V, +/- 5%, C0G/NP0, 0603 | C27 | C0603C101J5GACTU | 1 | Kemet | 603 | 100pF
Fitted | CAP, CERM, 0.1 uF, 50 V, +/- 10%, X7R, 0603 | C28, C31, C32, C33, C35, C39, C40, C41, C43, C44, C46, C47, C48, C49, C50, C51, C52, C53, C54, C55, C56, C57 | 885012206095 | 22 | Wurth Elektronik | 603 | 0.1uF
Fitted | CAP, CERM, 0.1 uF, 100 V,+/- 10%, X7R, AEC-Q200 Grade 1, 0603 | C37, C38, C42, C45 | GCJ188R72A104KA01D | 4 | MuRata | 603 | 0.1uF
Fitted | CAP, CERM, 0.1 uF, 16 V, +/- 10%, X7R, 0402 | C58, C59, C60, C62, C65, C66, C68 | 885012205037 | 7 | Wurth Elektronik | 402 | 0.1uF
Fitted | CAP, CERM, 0.47 uF, 6.3 V, +/- 10%, X5R, 0402 | C61, C67, C69 | 04026D474KAT2A | 3 | AVX | 402 | 0.47uF
Fitted | CAP, CERM, 10 µF, 16 V,+/- 10%, X5R, 0805 | C63, C64 | CL21A106KOQNNNG | 2 | Samsung Electro-Mechanics | 805 | 10uF
Fitted | CAP, CERM, 2200 pF, 10 V, +/- 10%, X7R, 0402 | C70 | 885012205008 | 1 | Wurth Elektronik | 402 | 2200pF
Fitted | Diode, Schottky, 100 V, 0.15 A, SOD-123 | D1, D2, D9 | BAT46W-7-F | 3 | Diodes Inc. | SOD-123 | 100V
Fitted | LED, Red, SMD | D3 | 150060RS75000 | 1 | Wurth Elektronik | LED_0603 | Red
Fitted | Diode, Zener, 16 V, 500 mW, SOD-123 | D4, D5, D6 | MMSZ5246B-7-F | 3 | Diodes Inc. | SOD-123 | 16V
Fitted | Diode, Ultrafast, 100 V, 0.15 A, SOD-123 | D7 | 1N4148W-7-F | 1 | Diodes Inc. | SOD-123 | 100V
Fitted | Diode, Zener, 10 V, 500 mW, SOD-123 | D8 | MMSZ4697T1G | 1 | ON Semiconductor | SOD-123 | 10V
Fitted | Diode, Schottky, 40 V, 0.2 A, SOT-323 | D13 | BAS40W-7-F | 1 | Diodes Inc. | SOT-323 | 40V
Fitted | LED, Green, SMD | D14, D15, D16 | 150060VS75000 | 3 | Wurth Elektronik | LED_0603 | Green
Fitted | Bumpon, Hemisphere, 0.44 X 0.20, Clear | H1, H2, H3, H4 | SJ-5303 (CLEAR) | 4 | 3M | Transparent Bumpon
Fitted | TERM BLOCK 3.5MM VERT 6POS PCB | J1, J4 | OSTTE060161 | 2 | On Shore Technology | HDR6
Fitted | Header, 2.54mm, 5x1, Tin, TH | J2, J22 | PEC05SAAN | 2 | Sullins Connector Solutions | Header, 2.54mm, 5x1, TH
Fitted | TERM BLOCK 3.5MM VERT 5POS PCB | J3 | OSTTE050161 | 1 | On Shore Technology | HDR5
Fitted | Header, 100mil, 6x1, Tin, TH | J5 | PEC06SAAN | 1 | Sullins Connector Solutions | TH, 6-Leads, Body 608x100mil, Pitch 100mil
Fitted | Header, 2.54mm, 3x1, Gold, SMT | J6, J7, J11, J13, J16, J19 | 87898-0304 | 6 | Molex | Header, 2.54mm, 3x1, SMT
Fitted | TERM BLOCK 3.5MM VERT 4POS PCB | J9 | OSTTE040161 | 1 | On Shore Technology | HDR4
Fitted | Header, 100mil, 2x1, Tin, TH | J10, J12, J15, J18, J20, J21 | PEC02SAAN | 6 | Sullins Connector Solutions | Header, 2 PIN, 100mil, Tin
Fitted | Header, 100mil, 6x2, Tin, TH | J14 | PEC06DAAN | 1 | Sullins Connector Solutions | Header, 6x2, 100mil, Tin
Fitted | Header (friction lock), 100mil, 4x1, R/A, TH | J17 | 22/05/3041 | 1 | Molex | 4x1 R/A Header
Fitted | Header, 2.54mm, 10x2, Tin, TH | J23 | PEC10DAAN | 1 | Sullins Connector Solutions | Header, 10x2, 2.54mm, TH
Fitted | Receptacle, Micro-USB Type B, 0.65 mm, 5x1, R/A, Bottom Mount SMT | J26 | 47346-1001 | 1 | Molex | Receptacle, 0.65mm, 5x1, R/A, SMT
Fitted | Header, 2.54 mm, 2x1, Gold, TH | J27 | 61300211121 | 1 | Wurth Elektronik | Header, 2.54mm, 2x1, TH
Fitted | Header, 2.54mm, 4x1, Tin, TH | J29 | 22284043 | 1 | Molex | Header, 2.54mm, 4x1, TH
Fitted | Transistor, NPN, 150 V, 1 A, AEC-Q101, SOT-89 | Q1 | FCX495TA | 1 | Diodes Inc. | SOT-89 | 150 V
Fitted | Transistor, PNP, 150 V, 0.5 A, SOT-23 | Q4, Q11, Q13 | MMBT5401LT1G | 3 | ON Semiconductor | SOT-23 | 150 V
Fitted | MOSFET, P-CH, -150 V, -0.53 A, SOT-23 | Q5, Q6 | SI2325DS-T1-E3 | 2 | Vishay-Siliconix | SOT-23 | -150V | None
Fitted | MOSFET, N-CH, 150 V, 56 A, PG-TDSON-8 | Q8, Q9 | BSC160N15NS5ATMA1 | 2 | Infineon Technologies | PG-TDSON-8 | 150V | None
Fitted | MOSFET, N-CH, 60 V, 0.31 A, SOT-323 | Q10 | 2N7002KW | 1 | Fairchild Semiconductor | SOT-323 | 60V | None
Fitted | MOSFET, N-CH, 150 V, 3 A, PowerPAK SO-8 | Q12 | SI7898DP-E3 | 1 | Vishay-Siliconix | PowerPAK SO-8 | 150V | None
Fitted | RES, 100, 5%, 0.1 W, AEC-Q200 Grade 0, 0603 | R1, R27, R28, R31, R41, R67, R81 | CRCW0603100RJNEA | 7 | Vishay-Dale | 603 | 100
Fitted | RES, 20.0, 1%, 0.25 W, AEC-Q200 Grade 0, 1206 | R2, R3, R4, R7, R8, R11, R12, R13, R14, R16, R17, R18, R19, R21, R22, R23, R24 | CRCW120620R0FKEA | 17 | Vishay-Dale | 1206 | 20
Fitted | RES, 220, 5%, 1 W, AEC-Q200 Grade 0, 2512 | R5, R9 | CRCW2512220RJNEG | 2 | Vishay-Dale | 2512 | 220
Fitted | RES, 10 k, 5%, 0.1 W, AEC-Q200 Grade 0, 0603 | R20, R25, R29, R57, R89, R92, R94, R97, R99, R109, R110, R111 | CRCW060310K0JNEA | 12 | Vishay-Dale | 603 | 10k
Fitted | RES, 100 k, 5%, 0.1 W, AEC-Q200 Grade 0, 0603 | R26, R91 | CRCW0603100KJNEA | 2 | Vishay-Dale | 603 | 100k
Fitted | RES, 0.001, 1%, 1 W, 1210 | R30 | PMR25HZPFV1L00 | 1 | Rohm | 1210 | 0.001
Fitted | RES, 1.0 k, 5%, 0.1 W, AEC-Q200 Grade 0, 0603 | R32, R34, R36, R37, R47, R49, R53, R54, R69, R72, R75, R78, R83, R84, R85, R86 | CRCW06031K00JNEA | 16 | Vishay-Dale | 603 | 1.0k
Fitted | RES, 20 k, 5%, 0.1 W, AEC-Q200 Grade 0, 0603 | R38, R58, R66, R79 | CRCW060320K0JNEA | 4 | Vishay-Dale | 603 | 20k
Fitted | RES, 4.7 k, 5%, 1 W, AEC-Q200 Grade 0, 2512 | R39, R40 | CRCW25124K70JNEG | 2 | Vishay-Dale | 2512 | 4.7k
Fitted | RES, 10 M, 5%, 0.1 W, AEC-Q200 Grade 0, 0603 | R42, R43, R50, R51, R52 | CRCW060310M0JNEA | 5 | Vishay-Dale | 603 | 10Meg
Fitted | RES, 95.3 k, 1%, 0.1 W, 0603 | R44 | RC0603FR-0795K3L | 1 | Yageo | 603 | 95.3k
Fitted | RES, 7.5 k, 5%, 0.25 W, AEC-Q200 Grade 0, 1206 | R45, R48 | CRCW12067K50JNEA | 2 | Vishay-Dale | 1206 | 7.5k
Fitted | RES, 0, 5%, 0.1 W, AEC-Q200 Grade 0, 0603 | R56, R112, R113 | CRCW06030000Z0EA | 3 | Vishay-Dale | 603 | 0
Fitted | RES, 5.1 k, 5%, 0.1 W, AEC-Q200 Grade 0, 0603 | R59, R61, R62, R63, R82 | CRCW06035K10JNEA | 5 | Vishay-Dale | 603 | 5.1k
Fitted | RES, 62 k, 5%, 0.1 W, 0603 | R60 | RC0603JR-0762KL | 1 | Yageo | 603 | 62k
Fitted | RES, 5.1 k, 5%, 0.25 W, AEC-Q200 Grade 0, 1206 | R64, R68, R73, R74, R76, R77 | CRCW12065K10JNEA | 6 | Vishay-Dale | 1206 | 5.1k
Fitted | RES, 7.5 k, 5%, 0.1 W, AEC-Q200 Grade 0, 0603 | R65 | CRCW06037K50JNEA | 1 | Vishay-Dale | 603 | 7.5k
Fitted | RES, 27 k, 5%, 0.1 W, AEC-Q200 Grade 0, 0603 | R80 | CRCW060327K0JNEA | 1 | Vishay-Dale | 603 | 27k
Fitted | RES, 200, 1%, 0.25 W, AEC-Q200 Grade 0, 1206 | R87, R88, R90, R93, R95, R96, R98, R100, R101, R102, R103, R104, R105, R106, R107, R108 | CRCW1206200RFKEA | 16 | Vishay-Dale | 1206 | 200
Fitted | RES, 33, 5%, 0.063 W, AEC-Q200 Grade 0, 0402 | R114, R115 | CRCW040233R0JNED | 2 | Vishay-Dale | 402 | 33
Fitted | RES, 2.0 k, 5%, 0.063 W, AEC-Q200 Grade 0, 0402 | R116 | CRCW04022K00JNED | 1 | Vishay-Dale | 402 | 2.0k
Fitted | RES, 10 k, 5%, 0.063 W, AEC-Q200 Grade 0, 0402 | R117, R123 | CRCW040210K0JNED | 2 | Vishay-Dale | 402 | 10k
Fitted | RES, 1.0 M, 5%, 0.063 W, AEC-Q200 Grade 0, 0402 | R118, R119 | CRCW04021M00JNED | 2 | Vishay-Dale | 402 | 1.0Meg
Fitted | RES, 330, 1%, 0.1 W, AEC-Q200 Grade 0, 0402 | R120, R121, R122 | ERJ-2RKF3300X | 3 | Panasonic | 402 | 330
Fitted | Thermistor NTC, 10.0k ohm, 1%, Disc, 5x8.4 mm | RT1, RT2 | 103AT-2 | 2 | SEMITEC Corporation | Disc, 5x8.4 mm | 10k
Fitted | Switch, Tactile, SPST-NO, SMT | S1, S2 | KST221JLFS | 2 | C&K Components | Switch, 6.2X5X6.2 mm
Fitted | Switch, SPST-NO, Off-Mom, 0.05A, 12VDC, SMD | S3 | PTS820 J20M SMTR LFS | 1 | C&K Components | 3.9x2.9mm
Fitted | Shunt, 100mil, Gold plated, Black | SH-J1, SH-J2, SH-J3, SH-J4, SH-J5, SH-J6, SH-J7, SH-J8, SH-J9, SH-J10, SH-J11, SH-J12, SH-J13, SH-J14, SH-J15, SH-J16, SH-J17, SH-J18, SH-J19, SH-J20, SH-J21 | SNT-100-BK-G | 21 | Samtec | Shunt | 1x2 | 3M | 969102-0000-DA
Fitted | Test Point, Compact, Black, TH | TP14, TP15, TP16, TP17 | 5006 | 4 | Keystone | Black Compact Testpoint
Fitted | Multicell Battery Monitor and Protection Family, PFB0048A (TQFP-48) | U1 | bq76952PFBT | 1 | Texas Instruments | PFB0048A |  | Texas Instruments | bq76952PFBR
Fitted | Family 2-5S Overvoltage Protector with Internal Delay Timer, DPJ0008A (WSON-8) | U2, U3, U4, U5 | BQ771807DPJR | 4 | Texas Instruments | DPJ0008A |  | Texas Instruments | BQ771807DPJT
Fitted | Single-Channel ESD in 0402 Package With 10pF Capacitance and 6V Breakdown, DPY0002A (X1SON-2) | U6, U7, U8, U9 | TPD1E10B06DPYR | 4 | Texas Instruments | DPY0002A |  | Texas Instruments | TPD1E10B06DPYT
Fitted | Dual-Bit Dual Supply Transceiver with Configurable Voltage Translation and 3-State Outputs, DCT0008A, LARGE T&R | U10 | SN74LVC2T45DCTR | 1 | Texas Instruments | DCT0008A
Fitted | 25 MHz Mixed Signal Microcontroller with 128 KB Flash, 8192 B SRAM and 63 GPIOs, -40 to 85 degC, 80-pin QFP (PN), Green (RoHS & no Sb/Br) | U11 | MSP430F5529IPN | 1 | Texas Instruments | PN0080A
Fitted | Single-Channel ESD in 0402 Package With 10pF Capacitance and 6V Breakdown, DPY0002A (X1SON-2) | U12, U13, U15, U16 | TPD1E10B06DPYT | 4 | Texas Instruments | DPY0002A |  | Texas Instruments | TPD1E10B06DPYR
Fitted | Single Output LDO, 150 mA, Fixed 3.3 V Output, 2.7 to 10 V Input, with Low IQ, 5-pin SOT-23 (DBV), -40 to 125 degC, Green (RoHS & no Sb/Br) | U14 | TPS76333DBVR | 1 | Texas Instruments | DBV0005A
Fitted | Resonator, 4 MHz, 39 pF, AEC-Q200 Grade 1, SMD | Y1 | CSTCR4M00G55B-R0 | 1 | MuRata | 4.5x1.2x2 mm
Not Fitted | CAP, CERM, 0.01 uF, 16 V, +/- 10%, X7R, 0603 | C26 | 885012206040 | 0 | Wurth Elektronik | 603 | 0.01uF
Not Fitted | CAP, CERM, 0.1 uF, 100 V,+/- 10%, X7R, AEC-Q200 Grade 1, 0603 | C29, C30, C34, C36 | GCJ188R72A104KA01D | 0 | MuRata | 603 | 0.1uF
Not Fitted | Diode, Schottky, 100 V, 0.15 A, SOD-123 | D10, D11, D12 | BAT46W-7-F | 0 | Diodes Inc. | SOD-123 | 100V
Not Fitted | Fuse, 30 A, 62 VDC, SMD | F1 | SFK-3030 | 0 | Dexerials Corporation | 9.5x2x5mm
Not Fitted | Fiducial mark. There is nothing to buy or mount. | FID1, FID2, FID3, FID4, FID5, FID6 | N/A | 0 | N/A | N/A
Not Fitted | Terminal Block, 3.5mm Pitch, 2x1, TH | J8 | ED555/2DS | 0 | On-Shore Technology | 7.0x8.2x6.5mm
Not Fitted | Header, 2.54 mm, 7x1, Gold, TH | J24 | PBC07SAAN | 0 | Sullins Connector Solutions | Header, 2.54 mm, 7x1, TH
Not Fitted | Header, 2.54 mm, 11x1, Gold, TH | J25 | PBC11SAAN | 0 | Sullins Connector Solutions | Header, 2.54 mm, 11x1, TH
Not Fitted | Header, 2.54mm, 5x1, Tin, TH | J28 | PEC05SAAN | 0 | Sullins Connector Solutions | Header, 2.54mm, 5x1, TH
Not Fitted | MOSFET, P-CH, -150 V, -0.53 A, SOT-23 | Q2 | SI2325DS-T1-E3 | 0 | Vishay-Siliconix | SOT-23 | -150V | None
Not Fitted | MOSFET, N-CH, 150 V, 13 A, PG-TSDSON-8 | Q3 | BSZ900N15NS3 G | 0 | Infineon Technologies | PG-TSDSON-8 | 150V | None
Not Fitted | MOSFET, N-CH, 150 V, 56 A, PG-TDSON-8 | Q7 | BSC160N15NS5ATMA1 | 0 | Infineon Technologies | PG-TDSON-8 | 150V | None
Not Fitted | RES, 220, 5%, 1 W, AEC-Q200 Grade 0, 2512 | R6, R10 | CRCW2512220RJNEG | 0 | Vishay-Dale | 2512 | 220
Not Fitted | RES, 0, 5%, 0.1 W, AEC-Q200 Grade 0, 0603 | R15 | CRCW06030000Z0EA | 0 | Vishay-Dale | 603 | 0
Not Fitted | RES, 4.7 k, 5%, 1 W, AEC-Q200 Grade 0, 2512 | R33 | CRCW25124K70JNEG | 0 | Vishay-Dale | 2512 | 4.7k
Not Fitted | RES, 10 M, 5%, 0.1 W, AEC-Q200 Grade 0, 0603 | R35 | CRCW060310M0JNEA | 0 | Vishay-Dale | 603 | 10Meg
Not Fitted | RES, 0, 5%, 2 W, 2512 WIDE | R46 | RCL12250000Z0EG | 0 | Vishay Draloric | 2512 WIDE | 0
Not Fitted | RES, 51, 5%, 0.1 W, AEC-Q200 Grade 0, 0603 | R55 | CRCW060351R0JNEA | 0 | Vishay-Dale | 603 | 51
Not Fitted | RES, 5.1 k, 5%, 0.25 W, AEC-Q200 Grade 0, 1206 | R70, R71 | CRCW12065K10JNEA | 0 | Vishay-Dale | 1206 | 5.1k
Not Fitted | Test Point, Multipurpose, Red, TH | TP1 | 5010 | 0 | Keystone | Red Multipurpose Testpoint
Not Fitted | Test Point, Multipurpose, Black, TH | TP9 | 5011 | 0 | Keystone | Black Multipurpose Testpoint
Not Fitted | Test Point, Compact, Red, TH | TP43, TP44 | 5005 | 0 | Keystone | Red Compact Testpoint | Red
