Focerqc/QFBMS/3dmodels/XT30PW-M.step

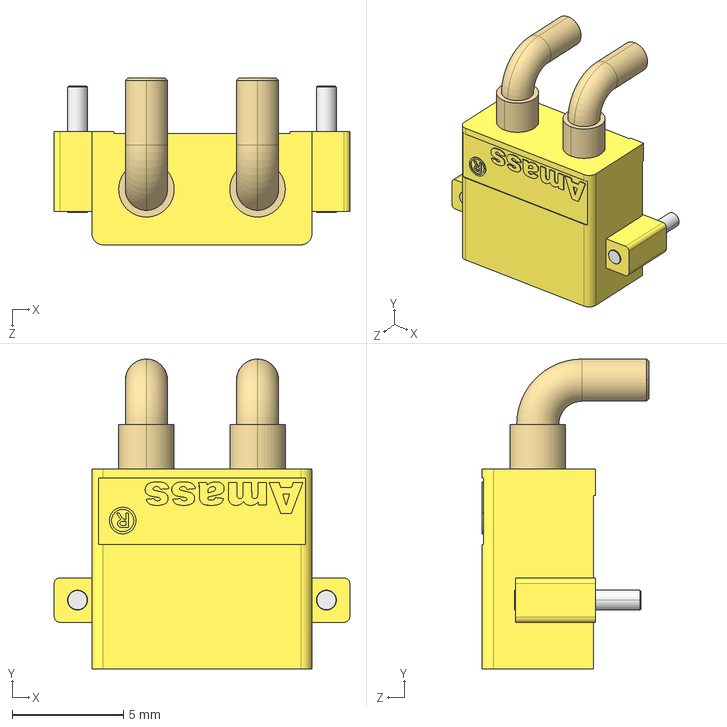
[picture p14: CAD file, 2026-11-02]
3dmodels/XT30PW-M.step
13.3 x 13.9 x 7.50 mm
