Focerqc/QFBMS/3dmodels/Fuse_2512_6332Metric.step

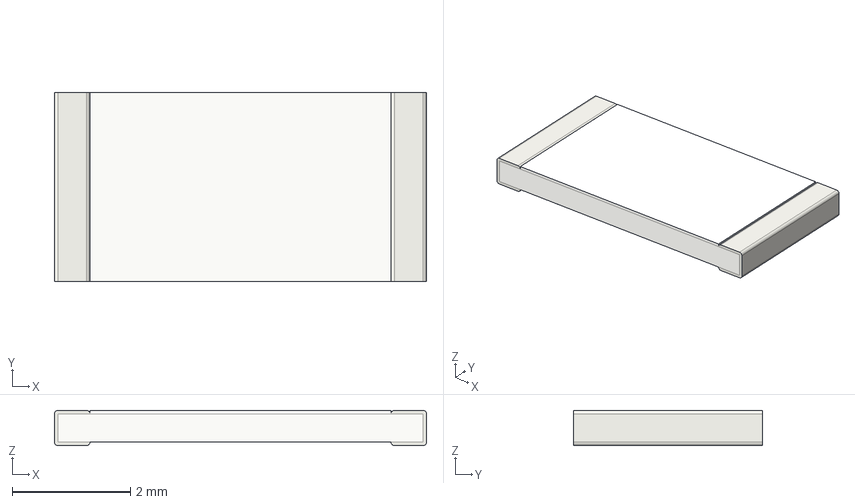
[picture p15: CAD file, 2026-11-02]
3dmodels/Fuse_2512_6332Metric.step
6.30 x 3.20 x 0.6 mm
