Focerqc/QFBMS/3dmodels/TOLL-8.step

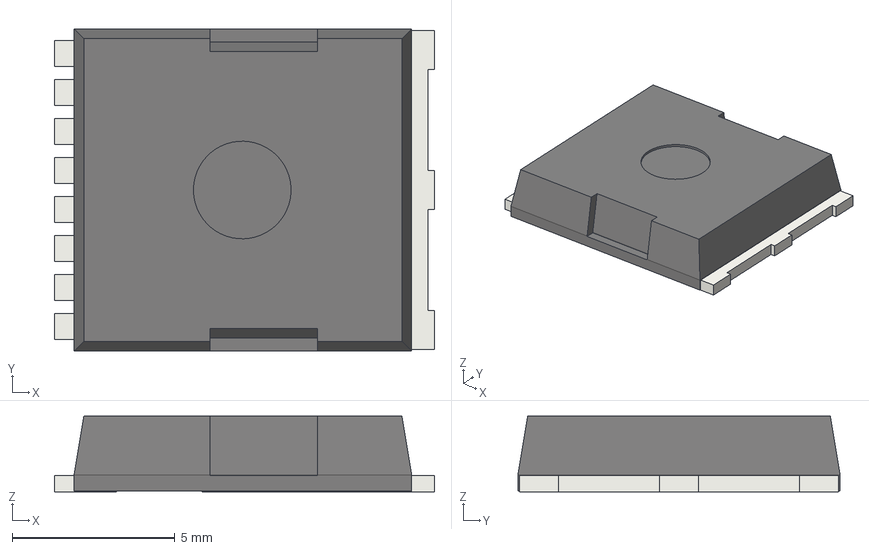
[picture p16: CAD file, 2026-11-02]
3dmodels/TOLL-8.step
11.7 x 9.90 x 2.32 mm
ad091e11-9c39-11ed-93f0-dde97e994e83_part
ad091e12-9c39-11ed-93f0-dde97e994e83_part
ad091e13-9c39-11ed-93f0-dde97e994e83_part
