Focerqc/QFBMS/3dmodels/XT30PW-F.step

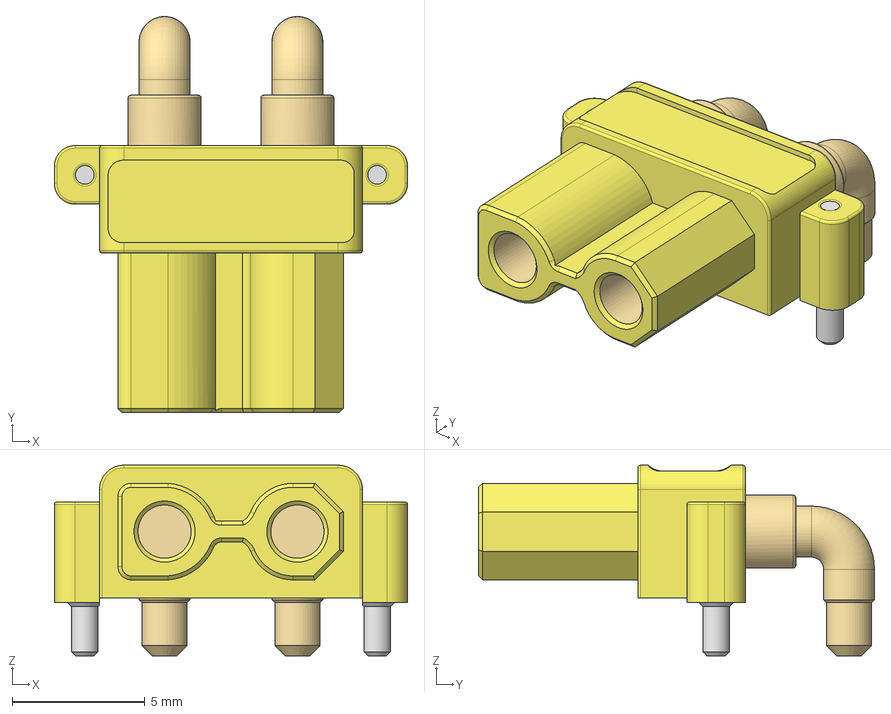
[picture p17: CAD file, 2026-11-02]
3dmodels/XT30PW-F.step
13.3 x 14.9 x 7.18 mm
