Focerqc/QFBMS/3dmodels/USB-C.step

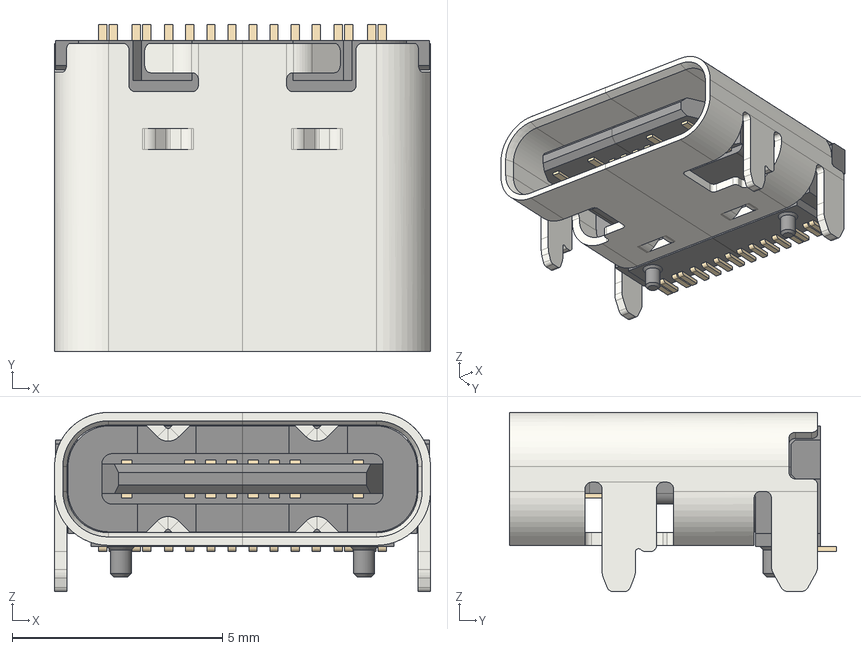
[picture p18: CAD file, 2026-11-02]
3dmodels/USB-C.step
8.94 x 7.78 x 4.26 mm
