Focerqc/QFBMS/(list of files, cad)

Other CAD files:
_reference/Meh ASM vbms STEP FILE.STEP
