Focerqc/QFBMS/docs/bq-repair-2026-11-03.md

# BQ monitor repair — November 3, 2026

This note records the temperature and isolation repair before the follow-on disconnect package. For current disconnect hardware, firmware adaptation and verification, see [bq-disconnect-2026-11-03.md](bq-disconnect-2026-11-03.md).

This repair applies only to the separate `qfbms32-bq-monitors` project. Grok commits `78c5ac6` and `c8f5122` remain intact in history. No working PCB, working schematic/project, supplied firmware, zone fill or PCB netlist import was changed. WP1 evidence was reused; board investigation was not repeated. ESP32, host power, charge switching, USB and CAN are later increments.

## Generator and reproducibility

The sole generator is `_tools/gen_bq_monitor_sheets.py`, moved from ignored `exports/`. Its tracked companion `_tools/bq-monitor-identities.json` preserves existing component and pin identities. There is no generator copy left in exports. The incomplete unused alternate monitor-builder was removed.

Prerequisites: Python 3 (standard library only; tested with 3.14) and the documented KiCad 10 installation, tested with 10.0.6. Default symbols path is `C:\Program Files\KiCad\10.0\share\kicad\symbols`; `KICAD10_SYMBOL_DIR` overrides it. Inputs are the tracked identity manifest and KiCad symbol libraries `Battery_Management`, `Device`, `power`, `Transistor_BJT`, and `Isolator`. No ignored report, scratch file, working-board file or firmware file is an input. Outputs are exactly the four `qfbms32-bq-*.kicad_sch` sheets in the repository root. The separate tracked `.kicad_pro` remains the project-settings input to KiCad; the generator no longer derives it from the protected working project.

Run from the repository root:

```powershell
python _tools/gen_bq_monitor_sheets.py
python _tools/check_bq_reproducibility.py
```

PASS: two consecutive generations are byte-identical. The reproducibility checker also copies only the generator and identity manifest to an otherwise empty temporary directory, regenerates twice using the installed KiCad libraries, and compares all four outputs with the repository sheets. Library content/version must match for byte-identical embedded symbols; this is not a promise across future library revisions.

Root and child sheet UUIDs are retained. All 164 surviving placed-symbol UUIDs are retained (lower 82, upper 69, isolation 13), as are their pin UUIDs. Removed SPST objects intentionally disappear. Wires, labels, text, junctions and sheet pins undergo a one-time conversion from random UUIDs to UUIDv5 keys based on sheet and object identity/geometry. This ancillary churn is deliberate, not an electrical change. Identities do not depend on an emission counter, source line or unrelated object order. Power-symbol identities use location/library rather than sequential annotation. Moving/replacing an object can change its identity; adding an unrelated object does not renumber existing identities. Reference annotation of power symbols still follows generation order.

## Temperature defect repaired

Fresh XML verifies these actual pin chains:

- U_BQ1.21 → R27.1; R27.2 → RT1.1; RT1.2 → CELL0.
- U_BQ1.23 → R28.1; R28.2 → RT2.1; RT2.2 → CELL0.
- U_BQ1.25 → R29.1; R29.2 → RT3.1; RT3.2 → CELL0.
- U_BQ1.31 → R30.1; R30.2 → RT4.1; RT4.2 → CELL0.
- U_BQ1.28 → R31.1; R31.2 → RT5.1; RT5.2 → CELL0.

For each chain, the two resistor endpoints and return are three different nets. Each resistor-to-thermistor intermediate net contains exactly those two intended pins. There is no resistor bypass. The generator places the thermistor below its series resistor and its return below the thermistor, avoiding the former wires passing back across the resistor.

Compatibility assumption, separately from procurement: supplied C configures the internal 18 kΩ pull-up, assumes 10 kΩ beta-3380 NTCs, and subtracts 500 Ω from inferred resistance (`hw_vbms32.c`, temperature setup and `NTC_RES`). The fitted R27–R31 values and RT1–RT5 values/MPNs remain OPEN. The 500 Ω correction does not prove a fitted 500 Ω part. No external thermistor bias network was added.

## GPIO9 disposition: PENDING

The false disconnect implementation is removed. SW_SDA/SW_SCL were two-pin SPST placeholders, with no GPIO control pin. They are absent from the exported component list. No replacement device is selected. Host SDA/SCL and ISO1640 side-1 SDA/SCL are electrically separate; both sides of each gap are marked PENDING. Upper bus communication is consequently unavailable. R203 remains GPIO9-to-HOST_3V3, with value OPEN. GPIO9 reaches only R203. High=open / low=connected is a future requirement, not an implemented truth table.

R201/R202 pull up the isolator side of the missing disconnect to HOST_3V3. Lower-monitor R20/R21 pull up the host bus to lower REG1; these are presently separate rails with no defined host power implementation. R120/R121 pull up upper SDA/SCL to upper REG1. Before connecting the missing switch, reconcile the host/REG1 rail relationship and pull-ups on both switch sides, aggregate sink current and switch resistance, capacitance and rise time at 100 kHz, reset/boot bias and supply sequencing/back-powering. Select a primary-datasheet-established pinout, control polarity and powered-off isolation. An OPEN suffix alone cannot establish any of those properties.

The [TI ISO164x datasheet](https://www.ti.com/lit/ds/symlink/iso1640.pdf), Figure 5-1 and pin functions, supports the retained ISO1640B 8-D map; no enable pin exists. Its side-1 80 pF and side-2 400 pF limits and supply ranges still need an actual loading/power budget. The ISO orderable suffix remains OPEN; the 16-DW pinout is not interchangeable.

Separate firmware issue, unchanged: `hw_vbms32.c` logs an unsuccessful lower-address write around lines 507–508 but still drives GPIO9 low at line 514. A maintained adaptation must verify successful communication with lower 0x10 before admitting upper 0x08. Lisp `with-com` and other direct GPIO9 writes gate repeatedly, including CAN-related uses. The future hardware/firmware contract must preserve address state and prevent an unverified upper admission across those repeated writes. Supplied source was preserved.

## Fresh verification

Run from the project root with KiCad 10 bin on PATH:

```powershell
kicad-cli sch erc --severity-all --format json --output exports/bq-repair-erc.json qfbms32-bq-monitors.kicad_sch
kicad-cli sch export netlist --format kicadxml --output exports/bq-repair.xml qfbms32-bq-monitors.kicad_sch
python _tools/verify_bq_repair.py exports/bq-repair.xml
kicad-cli sch export svg --output exports/bq-repair-svg qfbms32-bq-monitors.kicad_sch
```

All completed with exit code 0. Pin-level checker PASS:

- Five temperature chains as above, with distinct endpoints and exact intermediate membership.
- Both pending host/isolator paths separate; no SPST components; GPIO9 only R203.
- U_ISO.1 / .4 are HOST_3V3 / CELL0. C201.2 / .1 bridge exactly those supply/return nodes.
- U_ISO.8 / .5 are upper REG1 (U_BQ2.35) / CELL16. C202.2 / .1 bridge exactly those nodes.
- U_BQ2.17, .18, .20 and footprint-associated symbol pin 49 are CELL16. The retained footprint has pad 49; this is not evidence of a bonded thermal pad on TI's silicon. The working PCB was not changed.
- Lower SRP (.18), lower SRN (.20), CELL0 and upper CELL16 are four distinct nets.
- U_ISO.7/.6 reach upper BQ SDA .27 / SCL .26. ALERT_BQ2 contains only U_BQ2.25 as an electrical component pin and stays on the upper side.

Negative checks on temporary copies of the fresh XML: each of five independently recreated resistor bypasses failed the checker; shorts across either pending bus gap failed it too. These checks are pin based, not just label-name comparisons.

ERC: **43 warnings, zero errors**, versus prior 41 warnings, zero errors. Unchanged classes: 30 isolated cell-tap labels (harness absent), eight bidirectional-to-power-output reports from existing unused-pin reference ties, three embedded-custom-library warnings. Added: two `unconnected_wire_endpoint` warnings for the intentionally PENDING host SDA/SCL stubs. Per report: root 35, lower 3, upper 5, isolation 0. KiCad attributes these interface warnings to the root. No new exclusion, check suppression or severity change was made. The pre-existing ignored checks remain single-global-label, four-way-junction, SPICE-model and footprint-filter checks.

CLI diagnostics: sandbox HKCU registry access was denied, but report/export operations completed. XML export also printed the generic annotation-errors warning. Exporting the untouched Grok HEAD sheets in an isolated directory reproduced that warning, so it predates this repair. The CLI provides no specific offending reference in that diagnostic; annotation cleanup remains OPEN rather than being suppressed or represented as passed. Fresh XML nevertheless includes all required references/pins and passes the checks above.

KiCad SVGs were rendered and visually inspected for the changed temperature region, isolation sheet and root notes. The resistor bypasses are absent, pending gaps visible, and isolation pull-ups separated to avoid overlapping symbols/wires. Root notes were wrapped and moved inside the page boundary. Standard power references were hidden for readability. No physical-layout or manufacture sign-off is implied.

## Protected-file hashes

SHA-256 recorded before and after; each pair is identical:

```text
qfbms32.kicad_pcb
before 44045B287D223FA48AD0C9864A69A794FBC2407EDBB3922745E9A5B46DB71E8E
after  44045B287D223FA48AD0C9864A69A794FBC2407EDBB3922745E9A5B46DB71E8E
qfbms32.kicad_sch
before C8B17E5AA0936D8FFA2D0C3B4535BE0B898064DC0976F2ABD4436C4A3B704603
after  C8B17E5AA0936D8FFA2D0C3B4535BE0B898064DC0976F2ABD4436C4A3B704603
qfbms32.kicad_pro
before 0F84F61398BD25215ADA1A9C53ABE8C4E0F80B3B613C16E2D02F656B900CFED2
after  0F84F61398BD25215ADA1A9C53ABE8C4E0F80B3B613C16E2D02F656B900CFED2
```

All supplied firmware files were also compared against the before manifest and are unchanged. Ignored local evidence is under `exports/bq-repair-*`; durable instructions and conclusions are this note and the tracked checkers.

## Remaining repair-related OPEN items

The follow-on package selected and checked a TI TMUX154E disconnect and added a separate firmware admission adaptation; see [the disconnect implementation note](bq-disconnect-2026-11-03.md). Pull-up values, rail relationships/sequencing, aggregate sink current, bus loading/rise time, lower-BQ back-power behavior and bench communication remain OPEN. Fitted temperature values/MPNs and sensor calibration, ISO orderable suffix, and the inherited annotation diagnostic remain OPEN. Existing shunt topology, actual Kelvin pickup and combined C/Lisp calibration remain explicitly provisional. Wake circuitry and other original component-rating choices remain open as documented in the earlier notes.

That follow-on increment stops after the disconnect/firmware package. ESP32 circuitry, host-power implementation, charge switching, USB, CAN, and PCB reconciliation are later packages.
