Focerqc/QFBMS/site/files/full-system-schematic.pdf

# 10k R_CHG1

# 1uFR_G2 100R

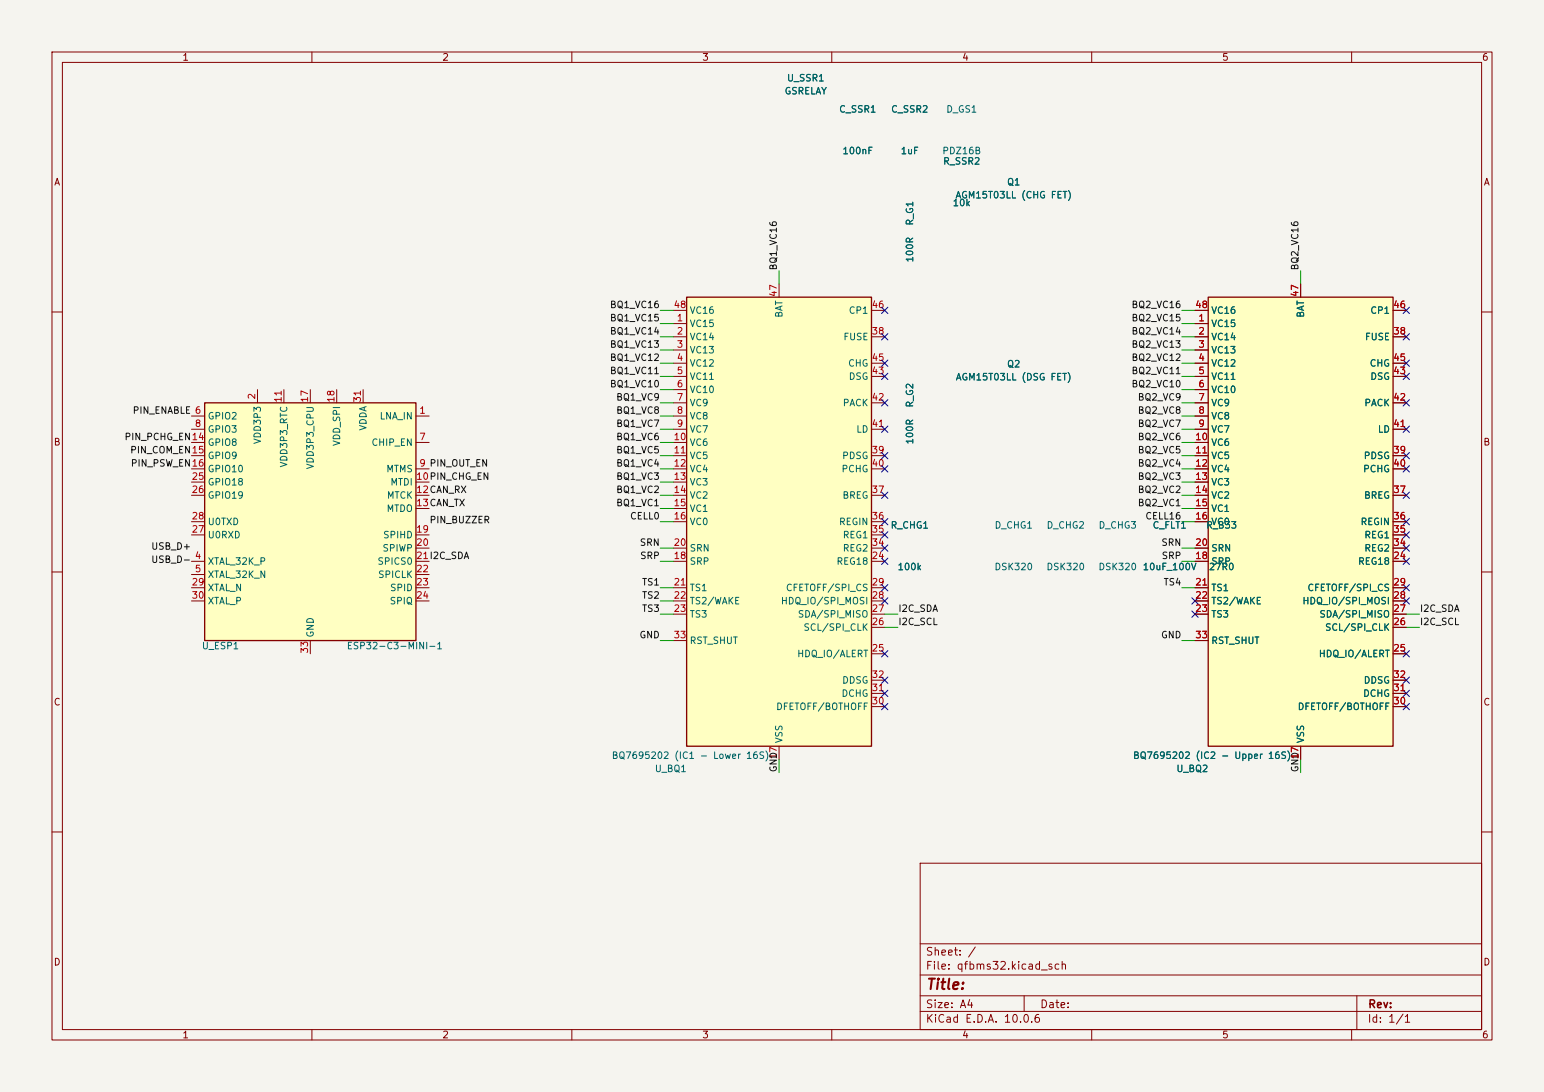
[picture p20: page 1]
D Date:; KiCad E.D.A. 10.0.6; Size: A4; Rev:; Title:; File: qfbms32.kicad_sch; Sheet: /; LNA_IN 1 VDD3P3; XTAL_32K_P 4; XTAL_32K_N 5 GPIO2 6; CHIP_EN 7 GPIO3 8; MTMS 9 MTDI 10 VDD3P3_RTC 11; MTCK 12 MTDO 13 GPIO8 14 GPIO9 15 GPIO10 16; VDD3P3_CPU 17; VDD_SPI 18; SPIHD 19 SPIWP 20 SPICS0 21 SPICLK 22 SPID 23; SPIQ 24 GPIO18 25 GPIO19 26 U0RXD 27 U0TXD 28; XTAL_N 29; XTAL_P 30; VDDA 31 GND U_ESP1; ESP32-C3-MINI-1; VSS 17; SRP 18 SRN 20; TS1 21 TS2/WAKE 22; REG18 24 HDQ_IO/ALERT 25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

LD 41 PACK 42 DSG 43 CHG 45 CP1 46 BAT 47
FUSE 38 PDSG 39 PCHG 40

# SDA_HOST SCL_HOST SCL_BQ1

UPPER DOMAIN | / | CELL16

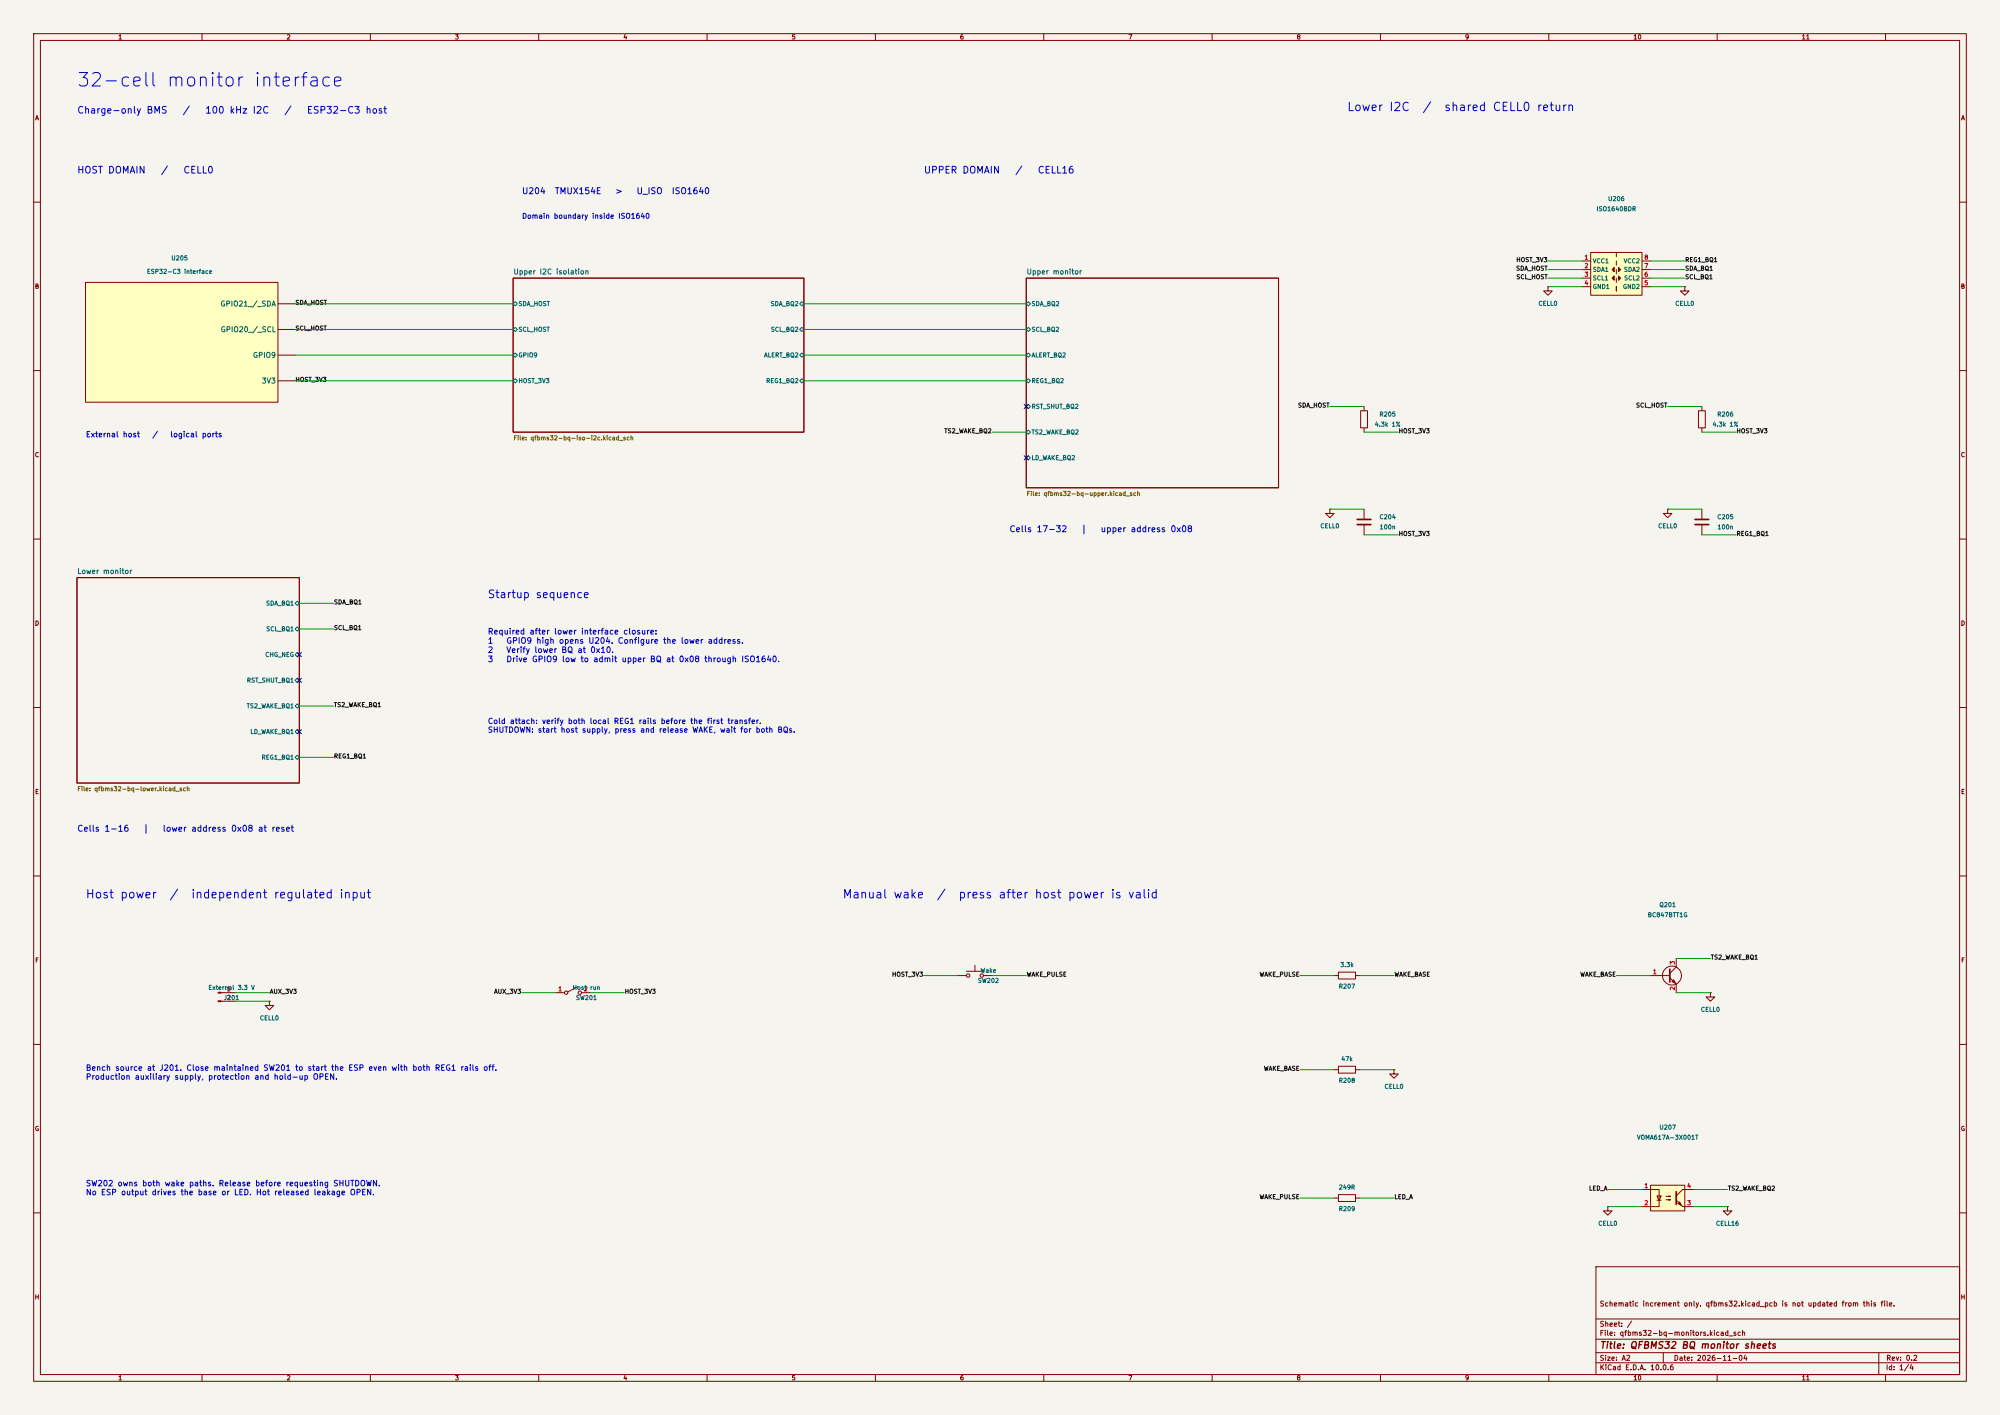
[picture p21: page 2]

LD_WAKE_BQ2 Upper monitor File: qfbms32-bq-upper.kicad_sch SDA_BQ1

Required after lower interface closure:

Cold attach: verify both local REG1 rails before the first transfer.
SHUTDOWN: start host supply, press and release WAKE, wait for both BQs.

Host power / independent regulated input

Manual wake / press after host power is valid

SW202 owns both wake paths. Release before requesting SHUTDOWN.
No ESP output drives the base or LED. Hot released leakage OPEN.

Schematic increment only. qfbms32.kicad_pcb is not updated from this file.

Sheet: /
File: qfbms32-bq-monitors.kicad_sch
Title: QFBMS32 BQ monitor sheets

# FUSE 38 PDSG 39 PCHG 40

## 03 Current sense

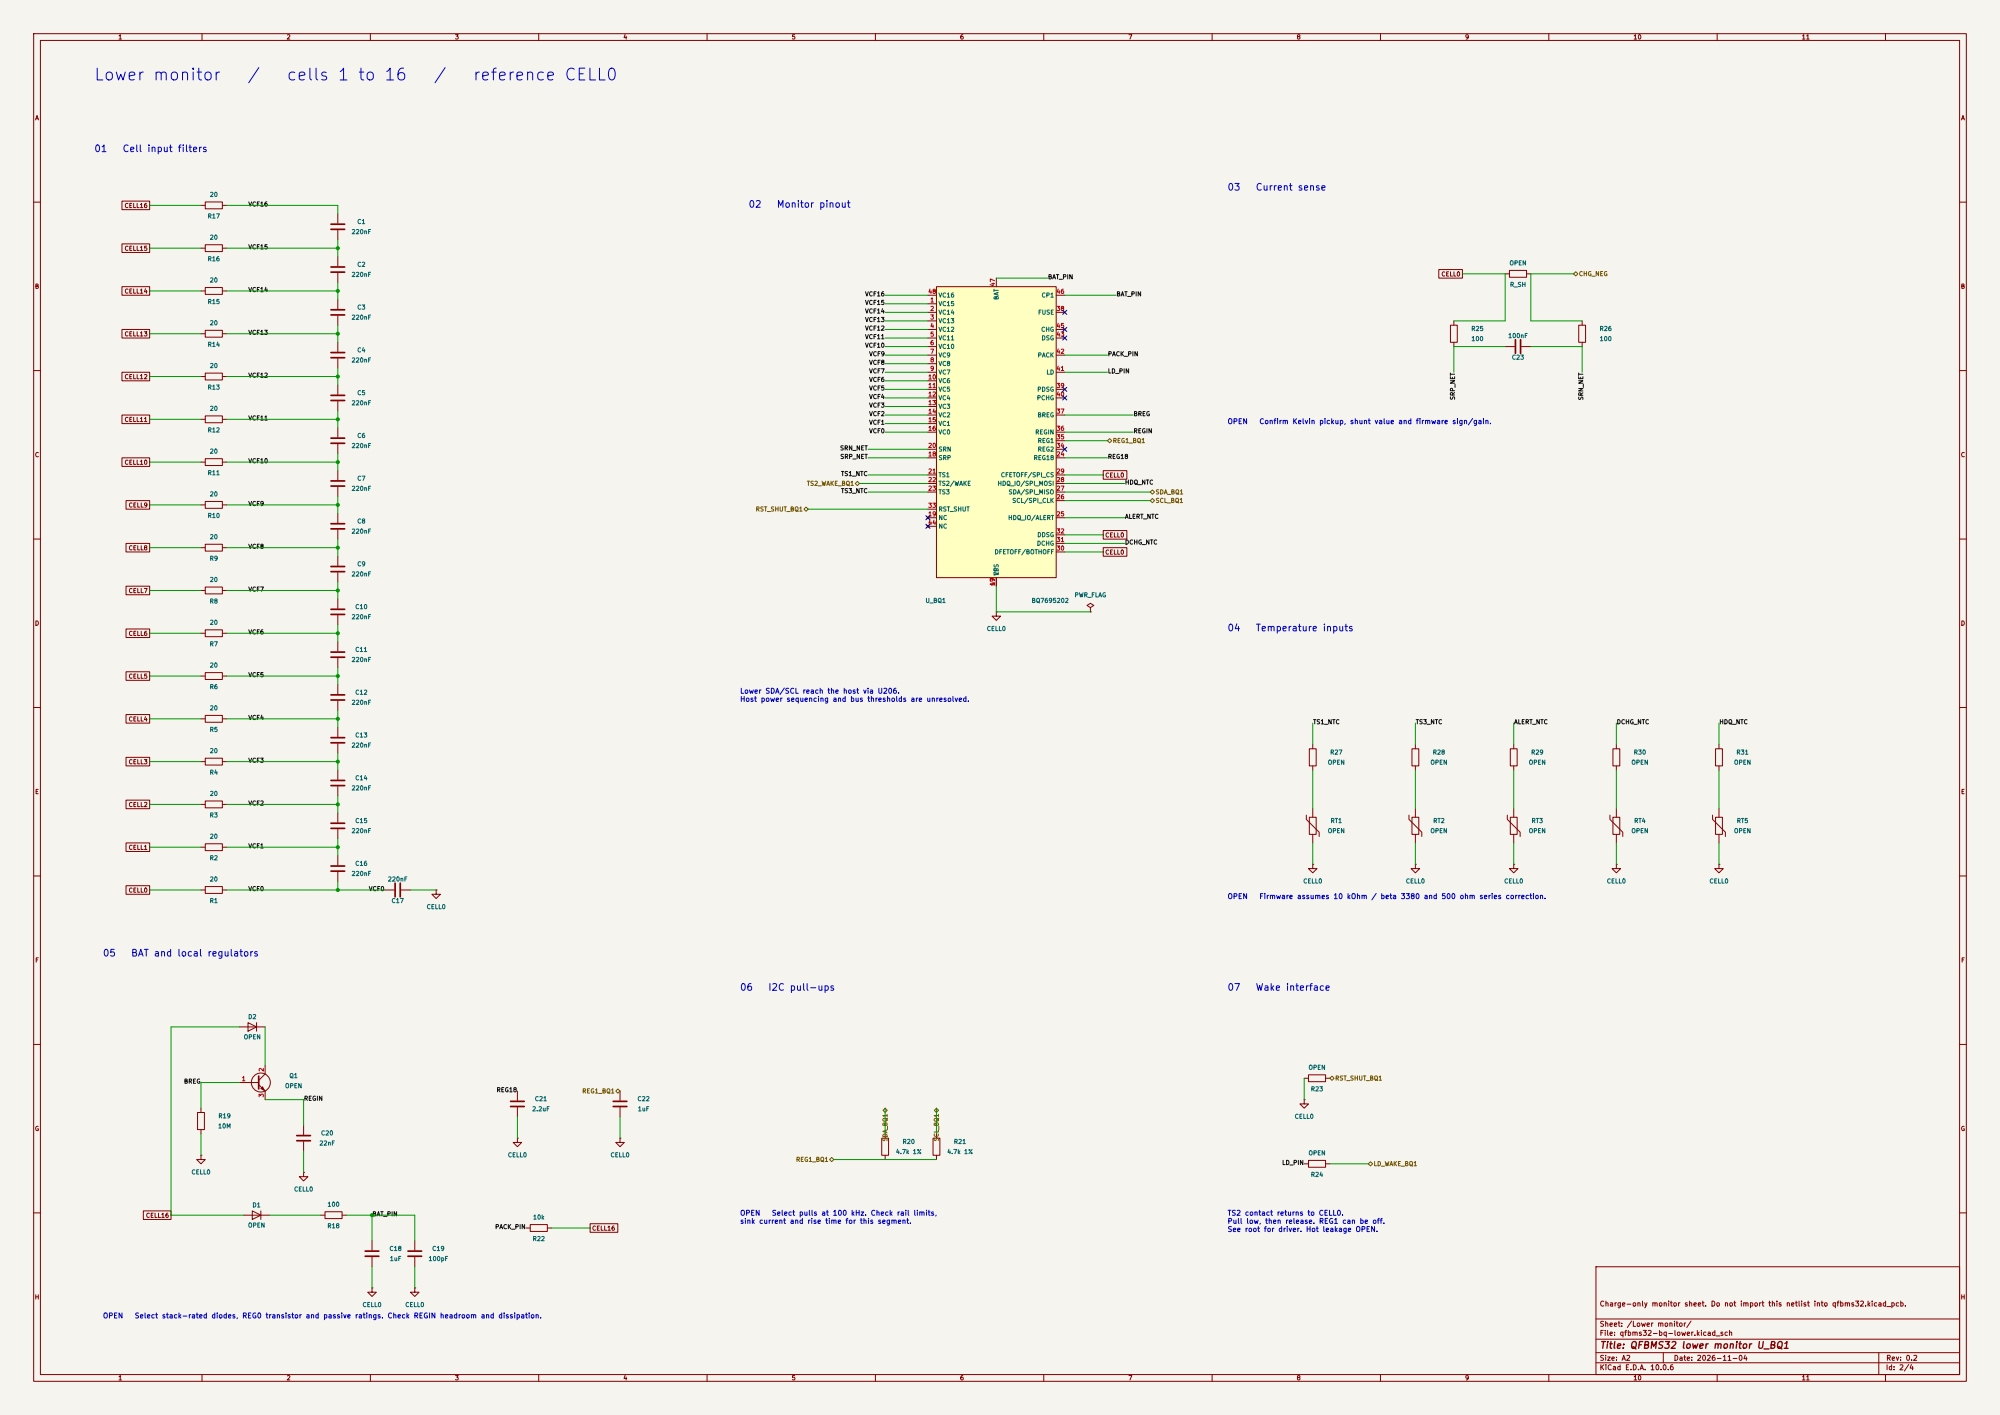
[picture p22: page 3]

Lower SDA/SCL reach the host via U206.
Host power sequencing and bus thresholds are unresolved.

Charge-only monitor sheet. Do not import this netlist into qfbms32.kicad_pcb. CELL0

sink current and rise time for this segment.

TS2 contact returns to CELL0.
Pull low, then release. REG1 can be off.
See root for driver. Hot leakage OPEN.

# FUSE 38 PDSG 39 PCHG 40

20 R117

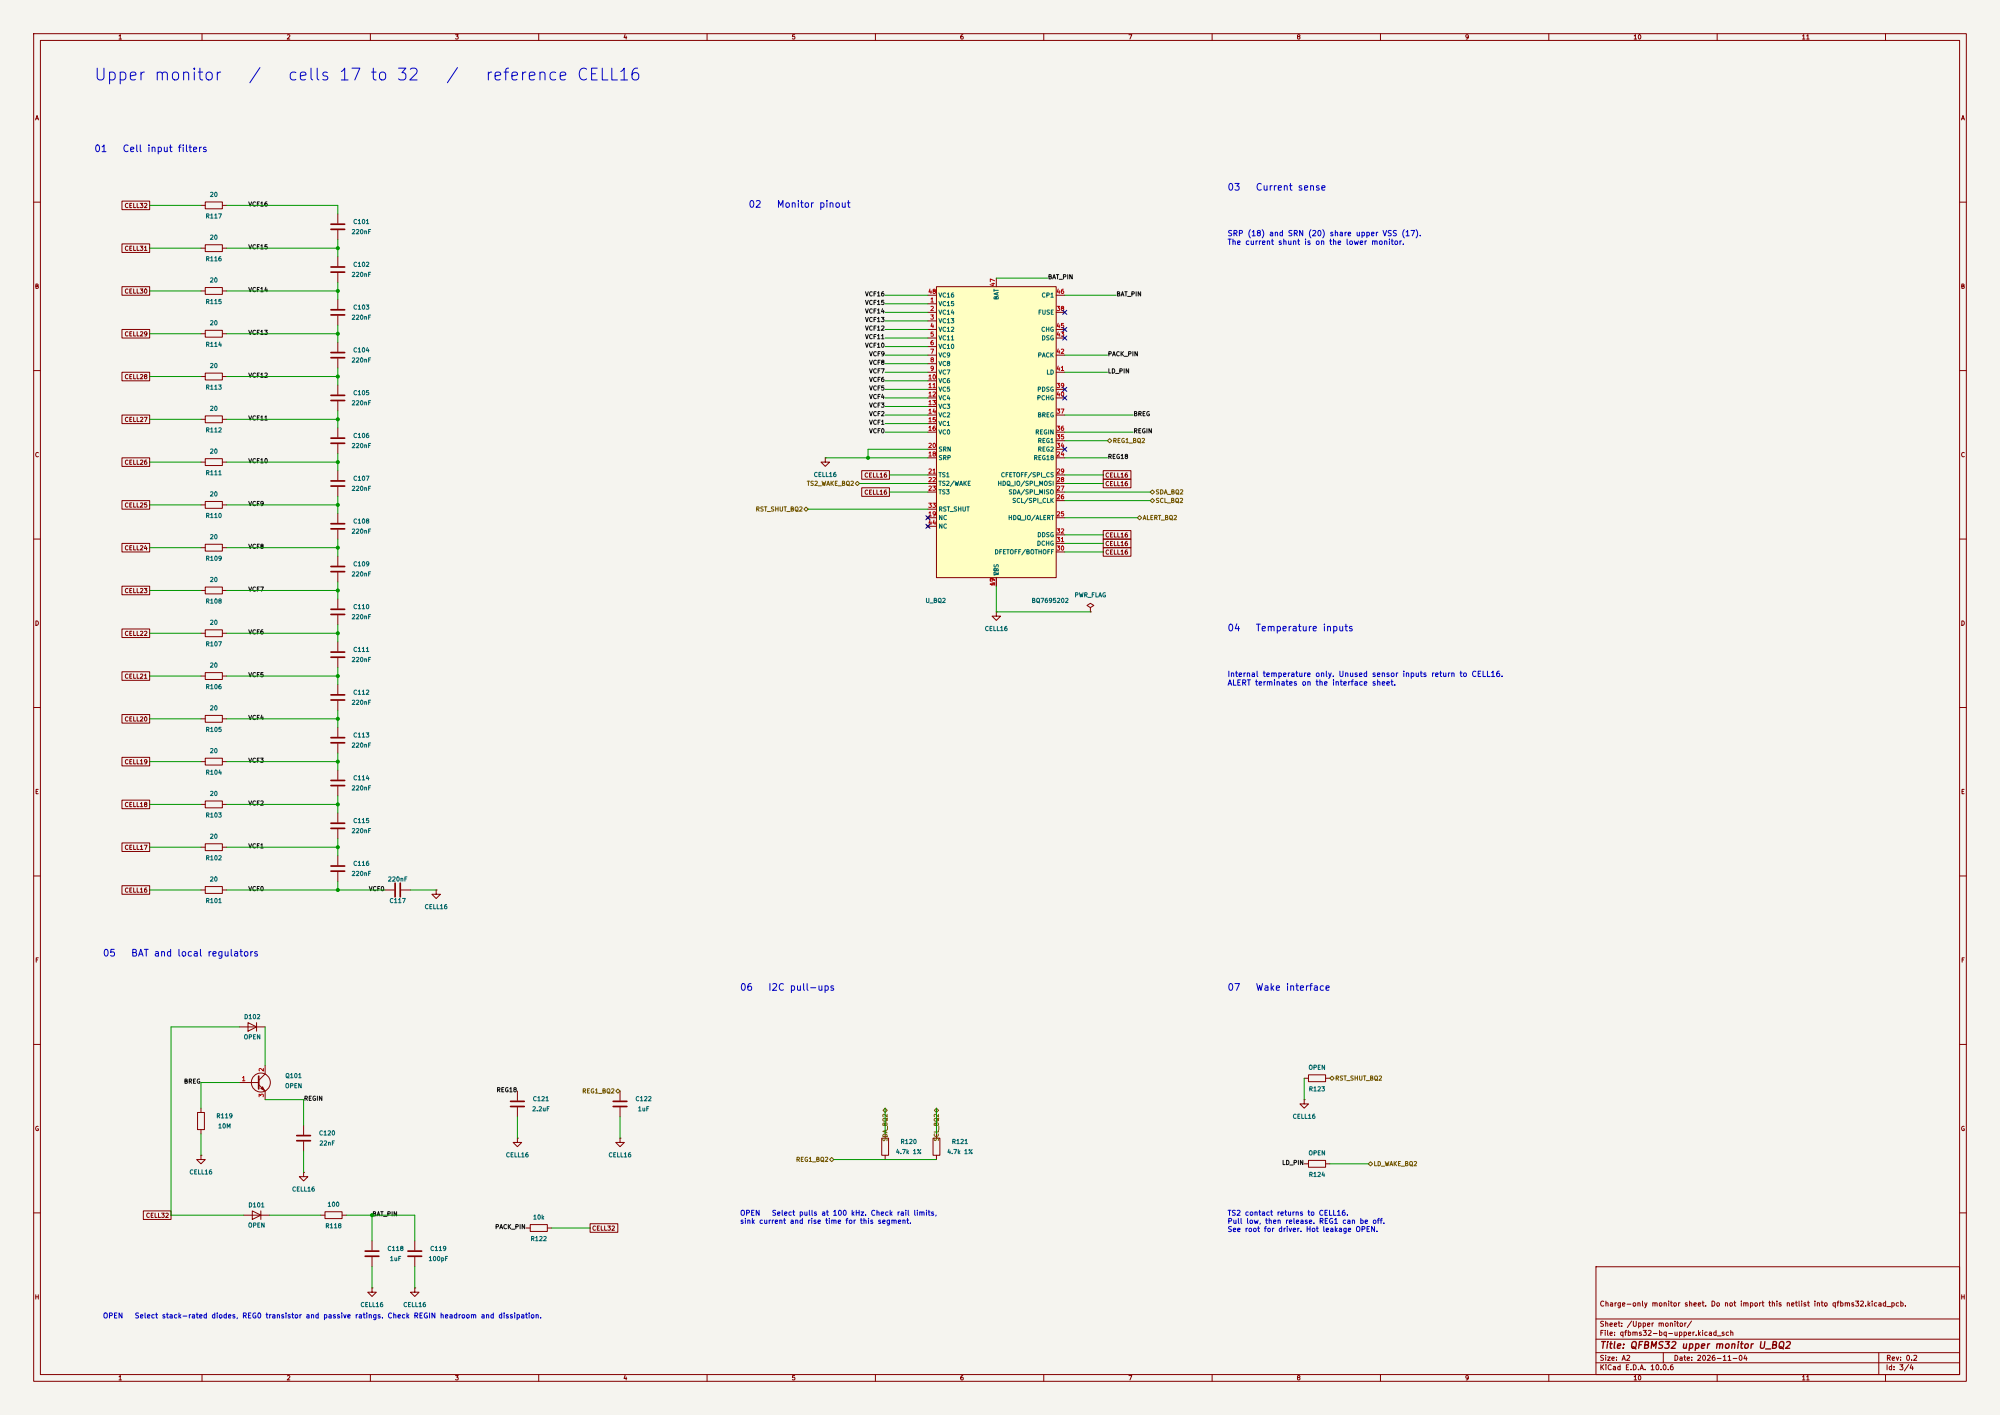
[picture p23: page 4]

SRP (18) and SRN (20) share upper VSS (17).
The current shunt is on the lower monitor.

Internal temperature only. Unused sensor inputs return to CELL16.
ALERT terminates on the interface sheet.

sink current and rise time for this segment.

TS2 contact returns to CELL16.
Pull low, then release. REG1 can be off.
See root for driver. Hot leakage OPEN.

## 02 ISO1640 domain boundary

## CELL0 host domain

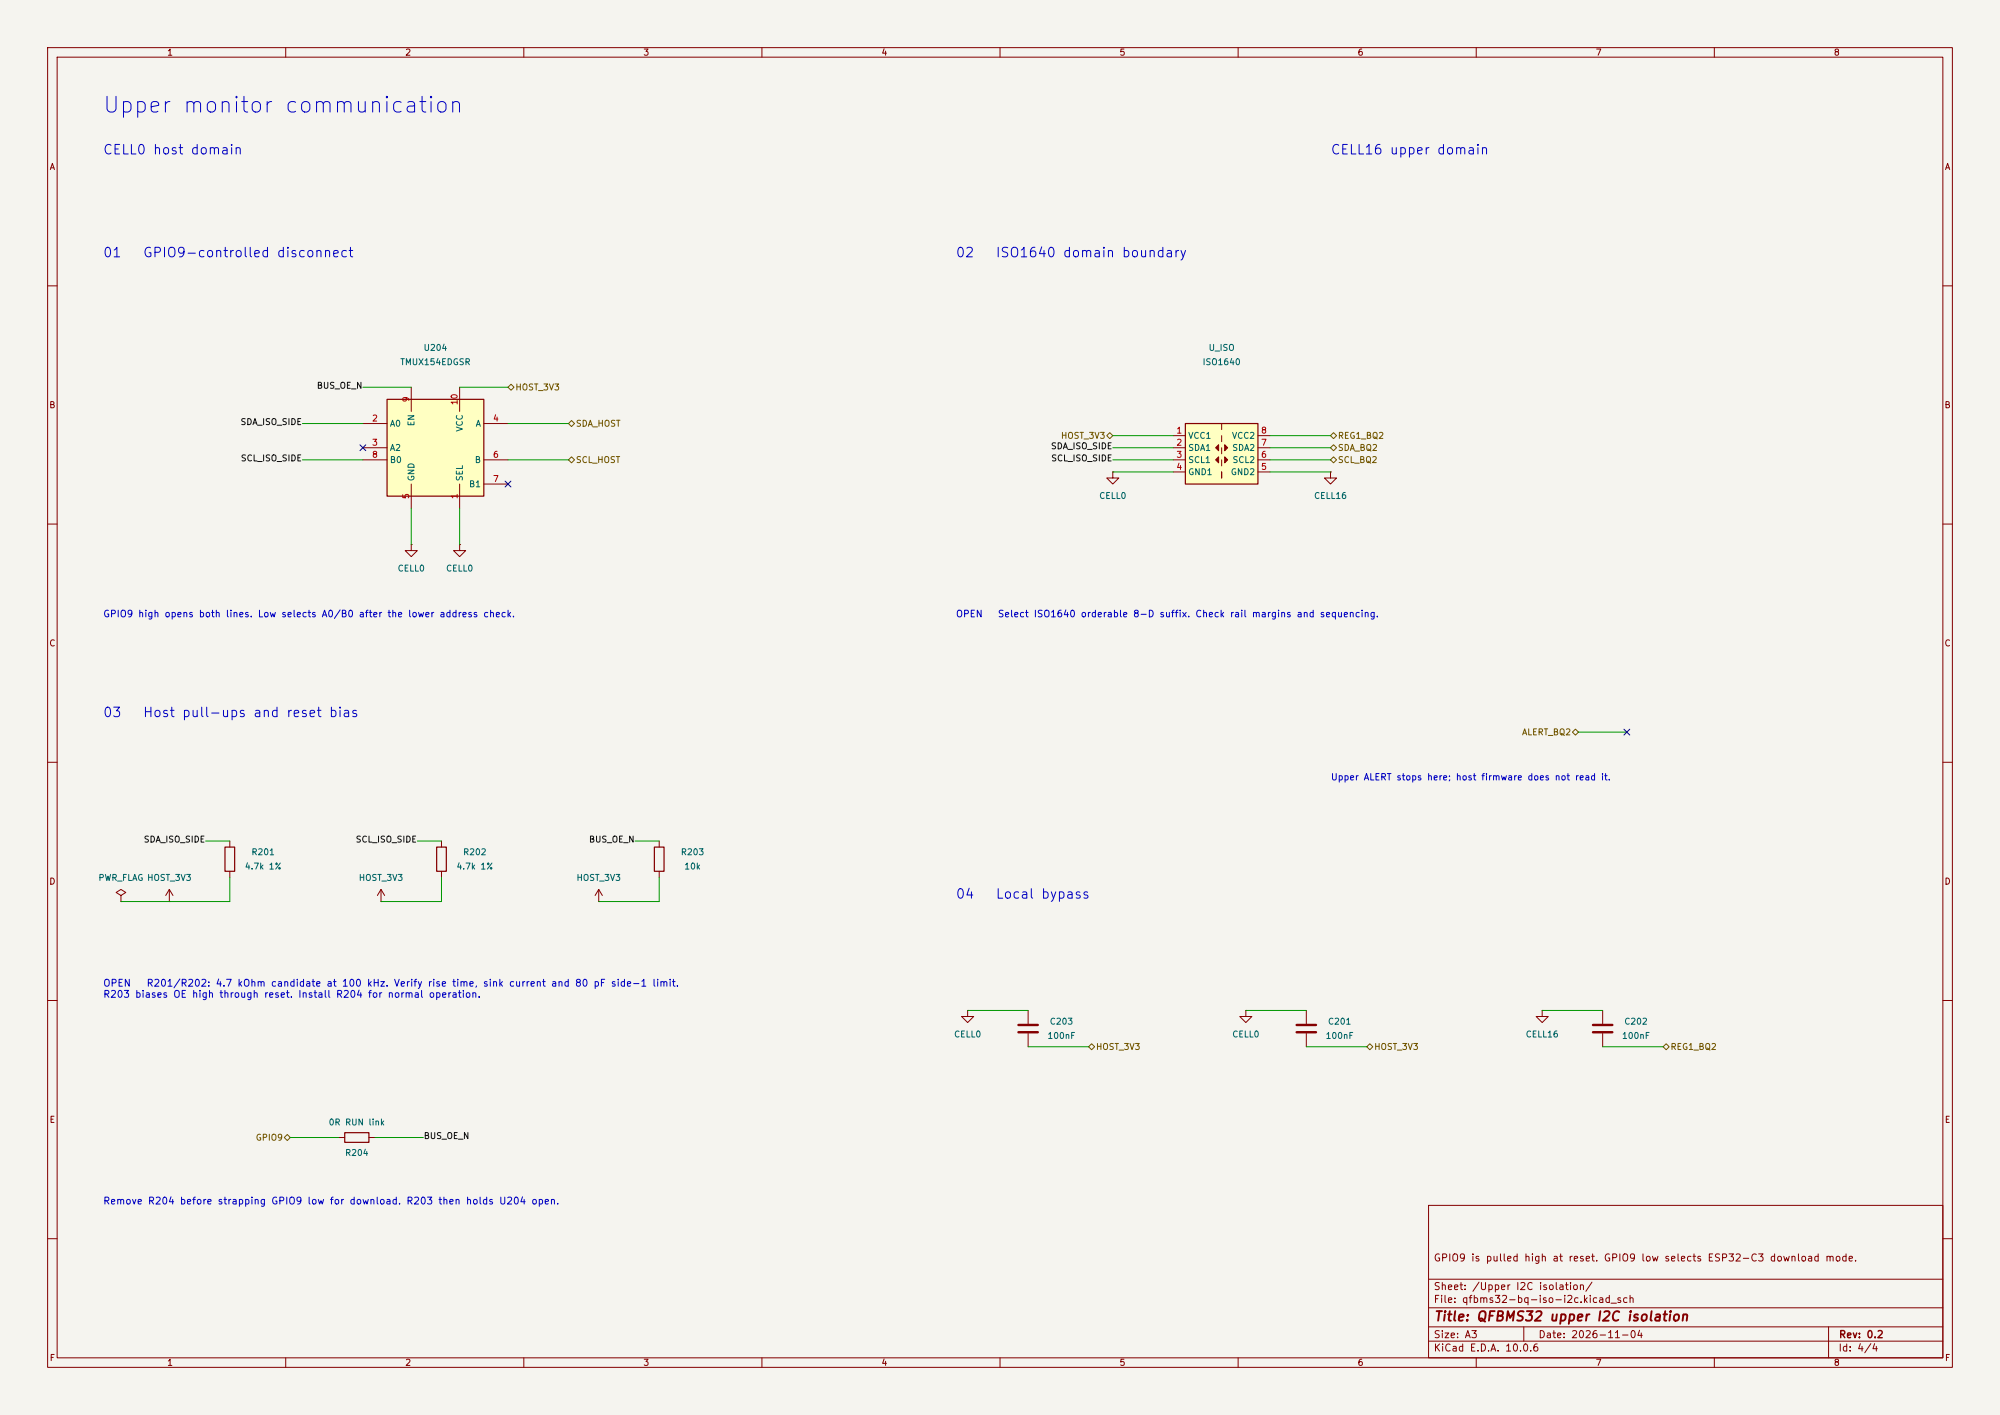
[picture p24: page 5]

R203 biases OE high through reset. Install R204 for normal operation. GPIO9 high opens both lines. Low selects A0/B0 after the lower address check. Remove R204 before strapping GPIO9 low for download. R203 then holds U204 open.

GPIO9 is pulled high at reset. GPIO9 low selects ESP32-C3 download mode.
