Focerqc/QFBMS/site/files/main-schematic-draft.pdf

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

Size: A4 | Rev:
KiCad E.D.A. 10.0.6 | Id: 1/1
