Focerqc/QFBMS/site/files/monitor-schematic-draft.pdf

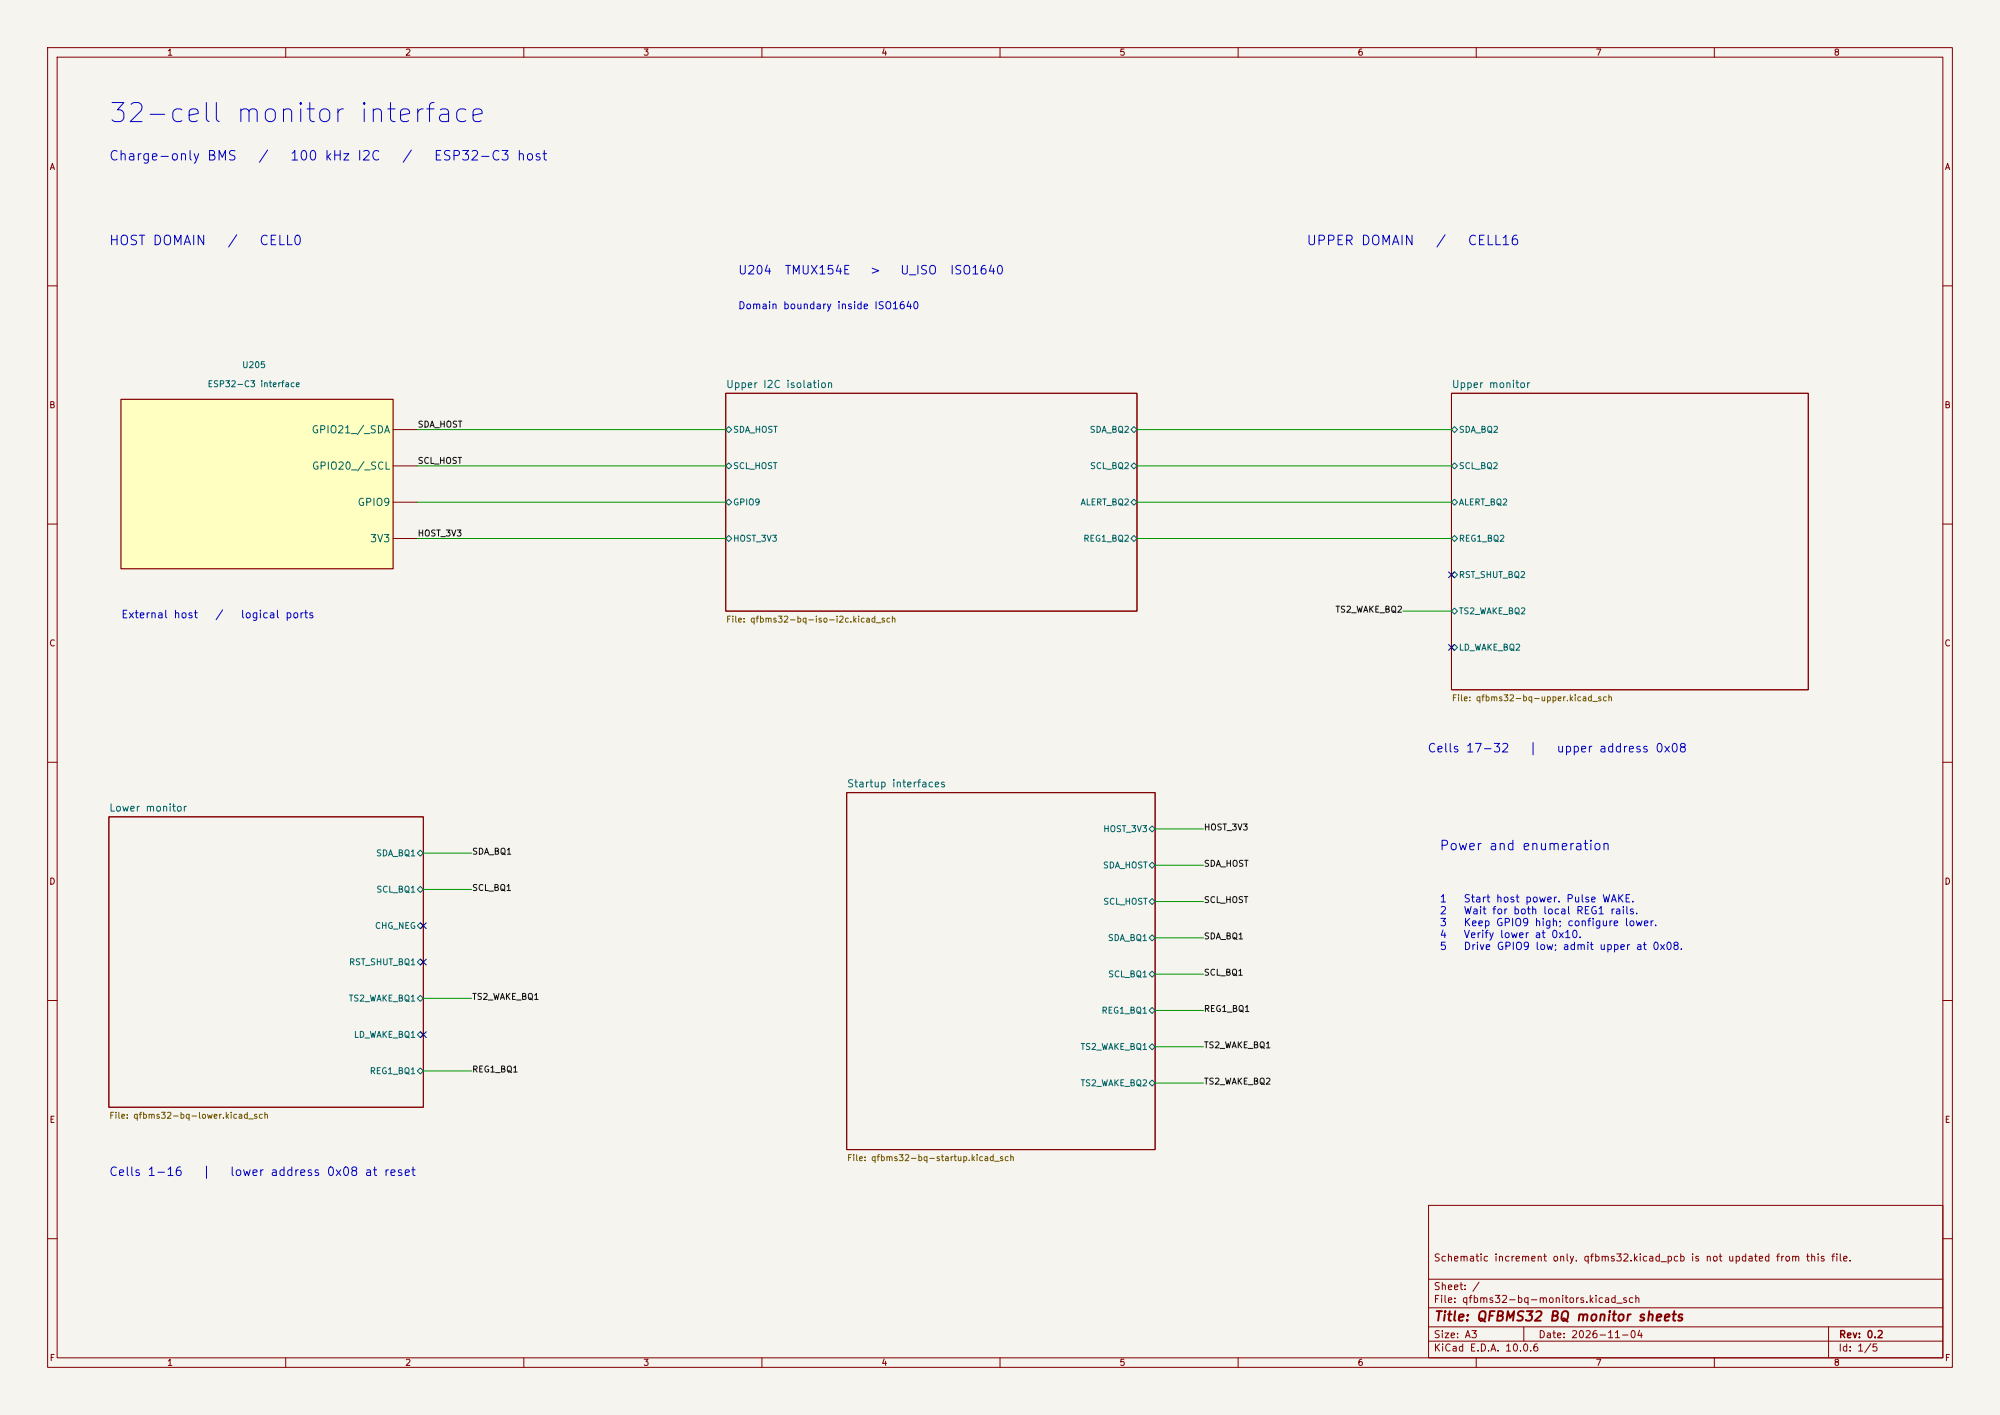
[picture p25: page 1]

LD_WAKE_BQ2 Upper monitor File: qfbms32-bq-upper.kicad_sch SDA_BQ1
SDA_HOST SCL_HOST HOST_3V3

LD_WAKE_BQ1 REG1_BQ1 Lower monitor File: qfbms32-bq-lower.kicad_sch

Schematic increment only. qfbms32.kicad_pcb is not updated from this file.

Sheet: /
File: qfbms32-bq-monitors.kicad_sch
Title: QFBMS32 BQ monitor sheets

Size: A3 | Rev: 0.2 | F Date: 2026-11-04
KiCad E.D.A. 10.0.6 | Id: 1/5

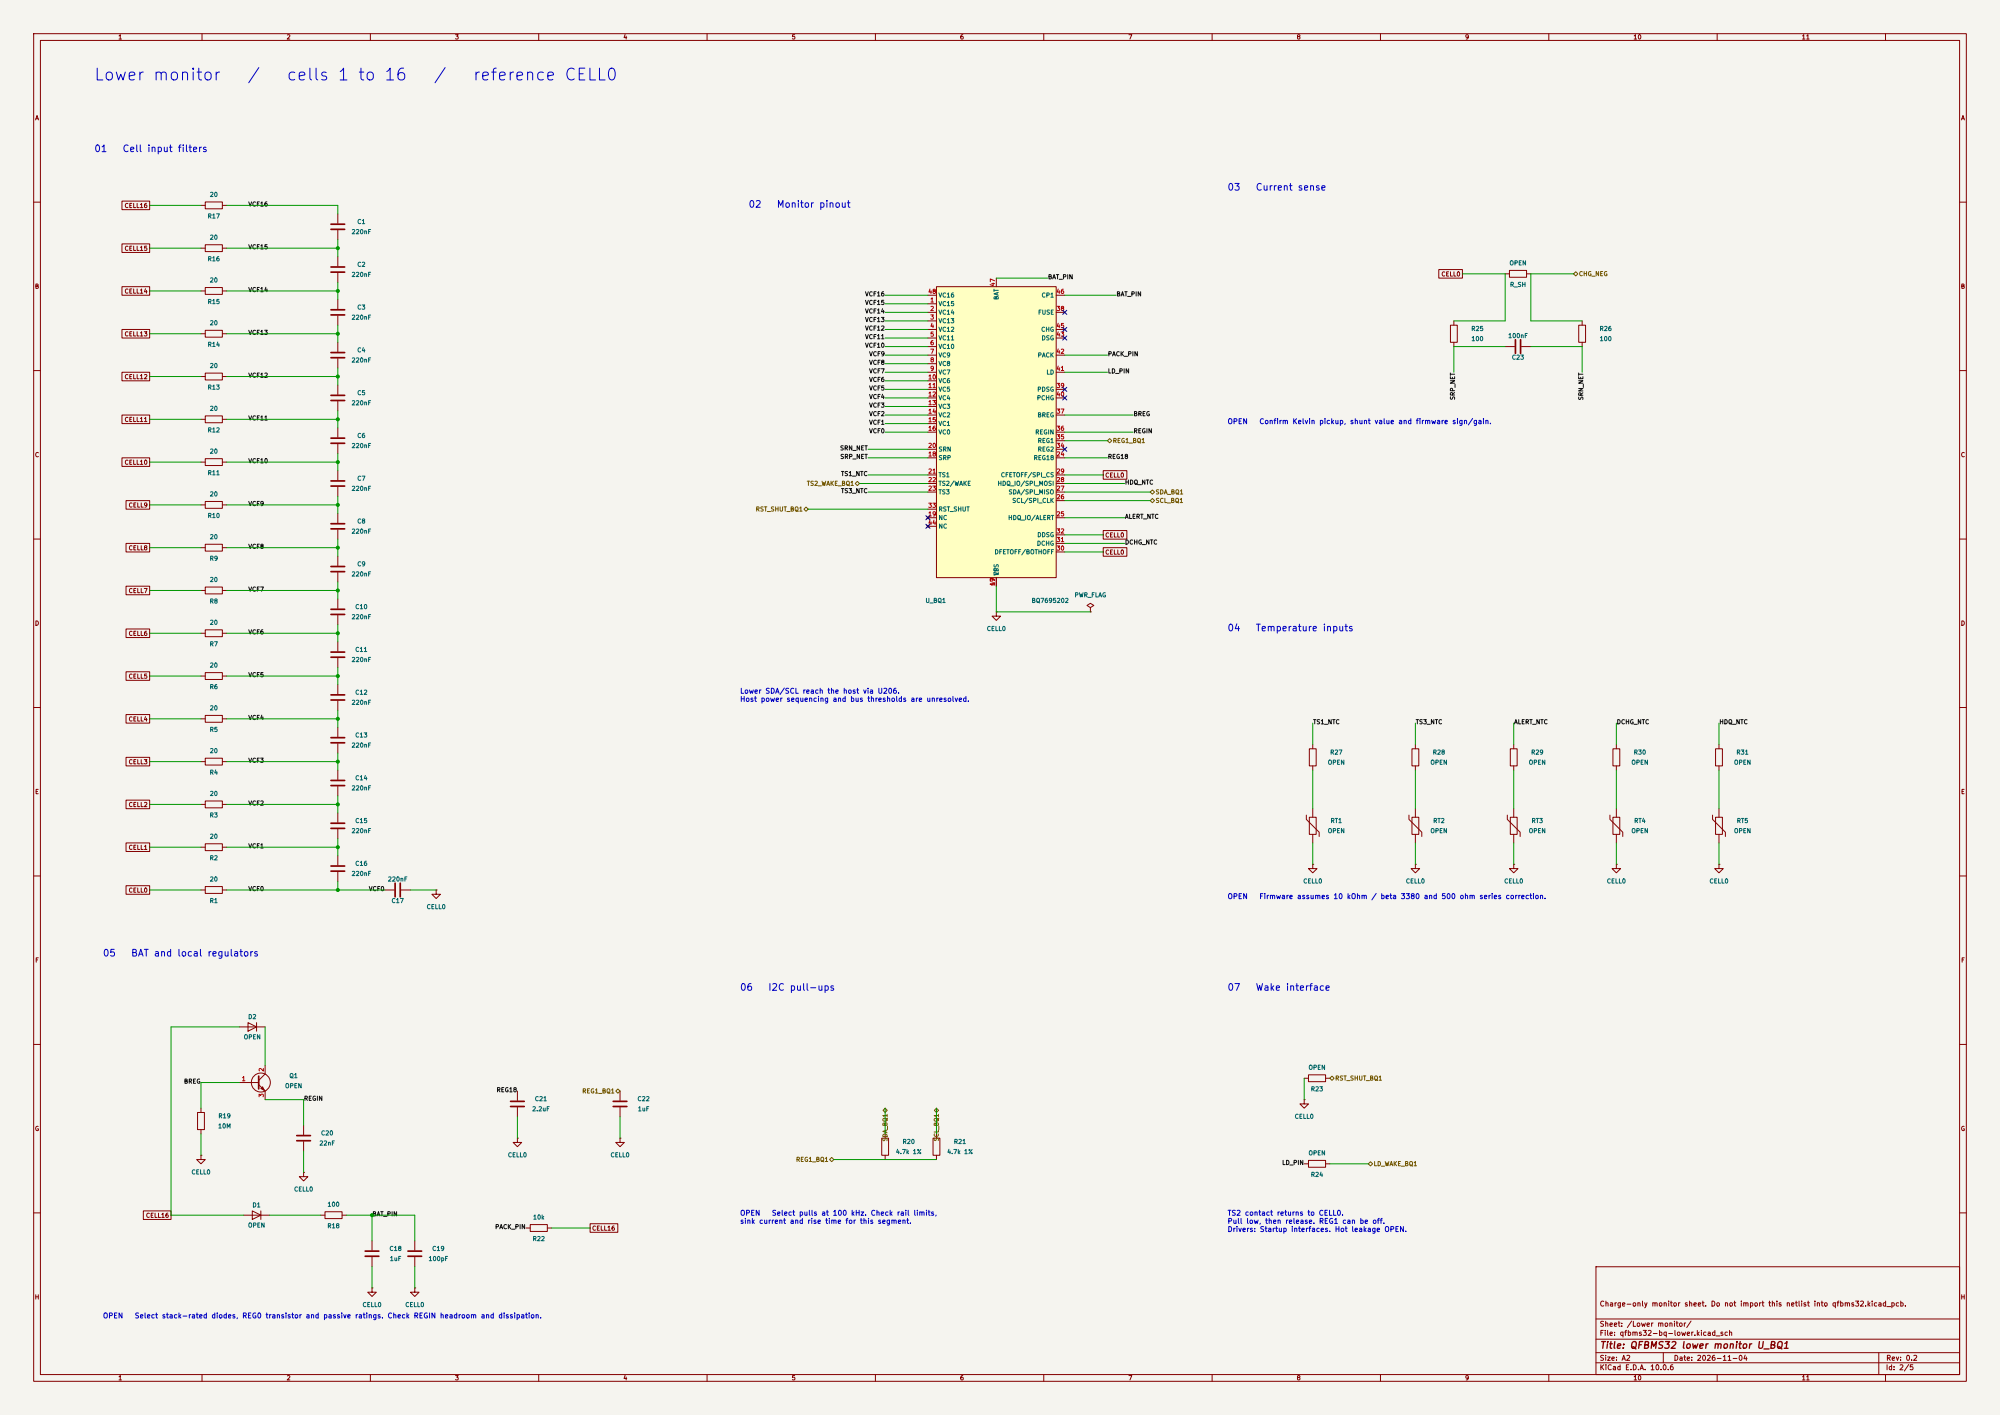
[picture p26: page 2]

Lower SDA/SCL reach the host via U206.
Host power sequencing and bus thresholds are unresolved.

sink current and rise time for this segment.

TS2 contact returns to CELL0.
Pull low, then release. REG1 can be off.
Drivers: Startup interfaces. Hot leakage OPEN.

Charge-only monitor sheet. Do not import this netlist into qfbms32.kicad_pcb.

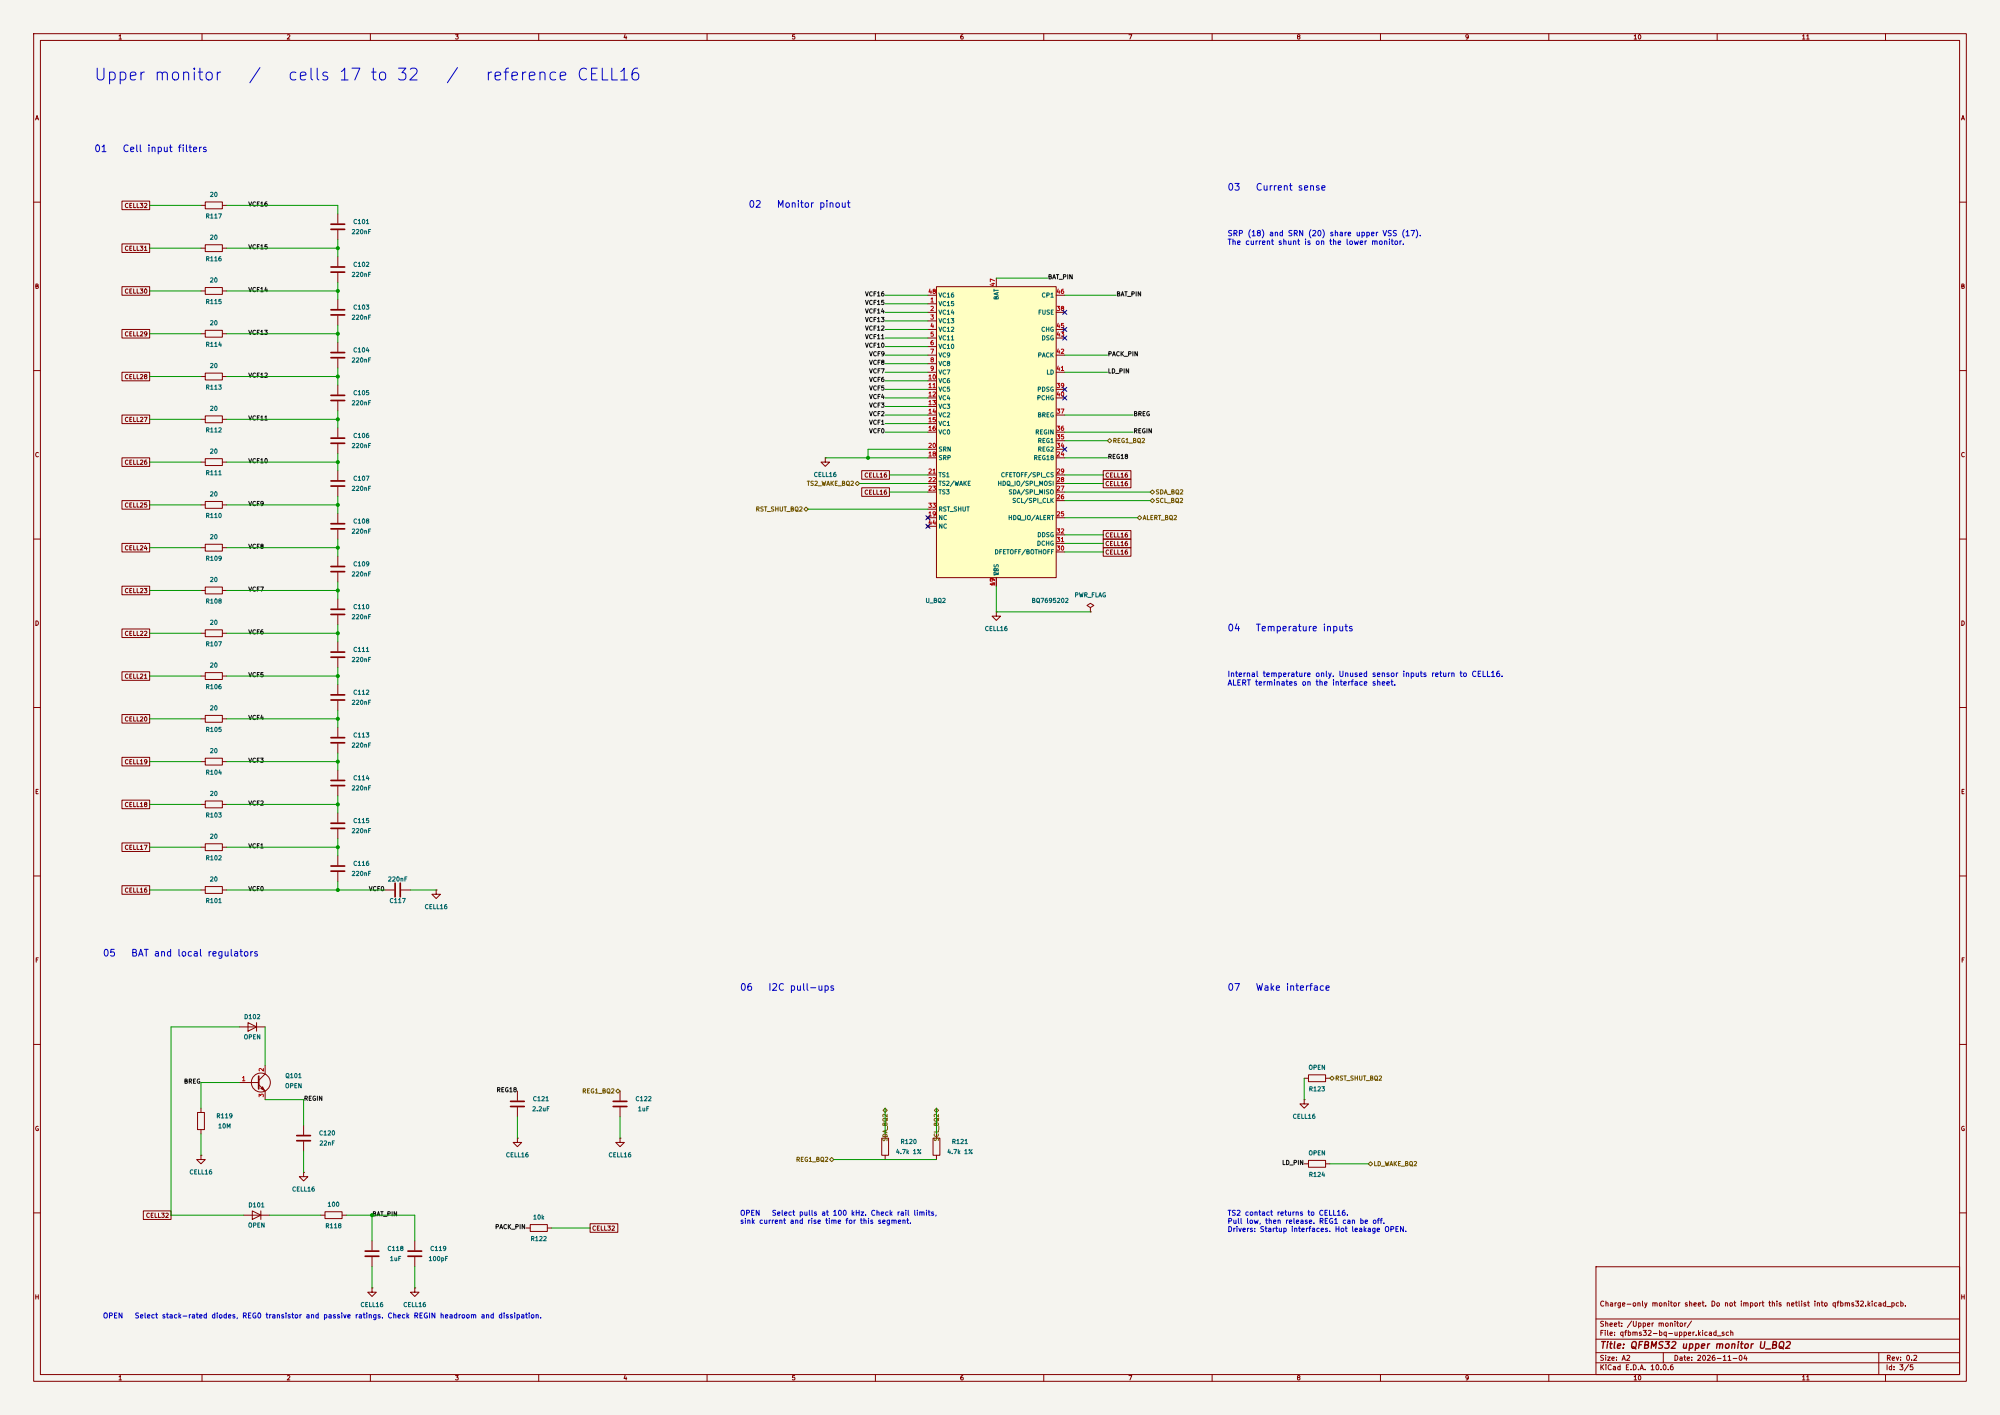
[picture p27: page 3]

SRP (18) and SRN (20) share upper VSS (17).
The current shunt is on the lower monitor.

Internal temperature only. Unused sensor inputs return to CELL16.
ALERT terminates on the interface sheet.

sink current and rise time for this segment.

TS2 contact returns to CELL16.
Pull low, then release. REG1 can be off.
Drivers: Startup interfaces. Hot leakage OPEN.

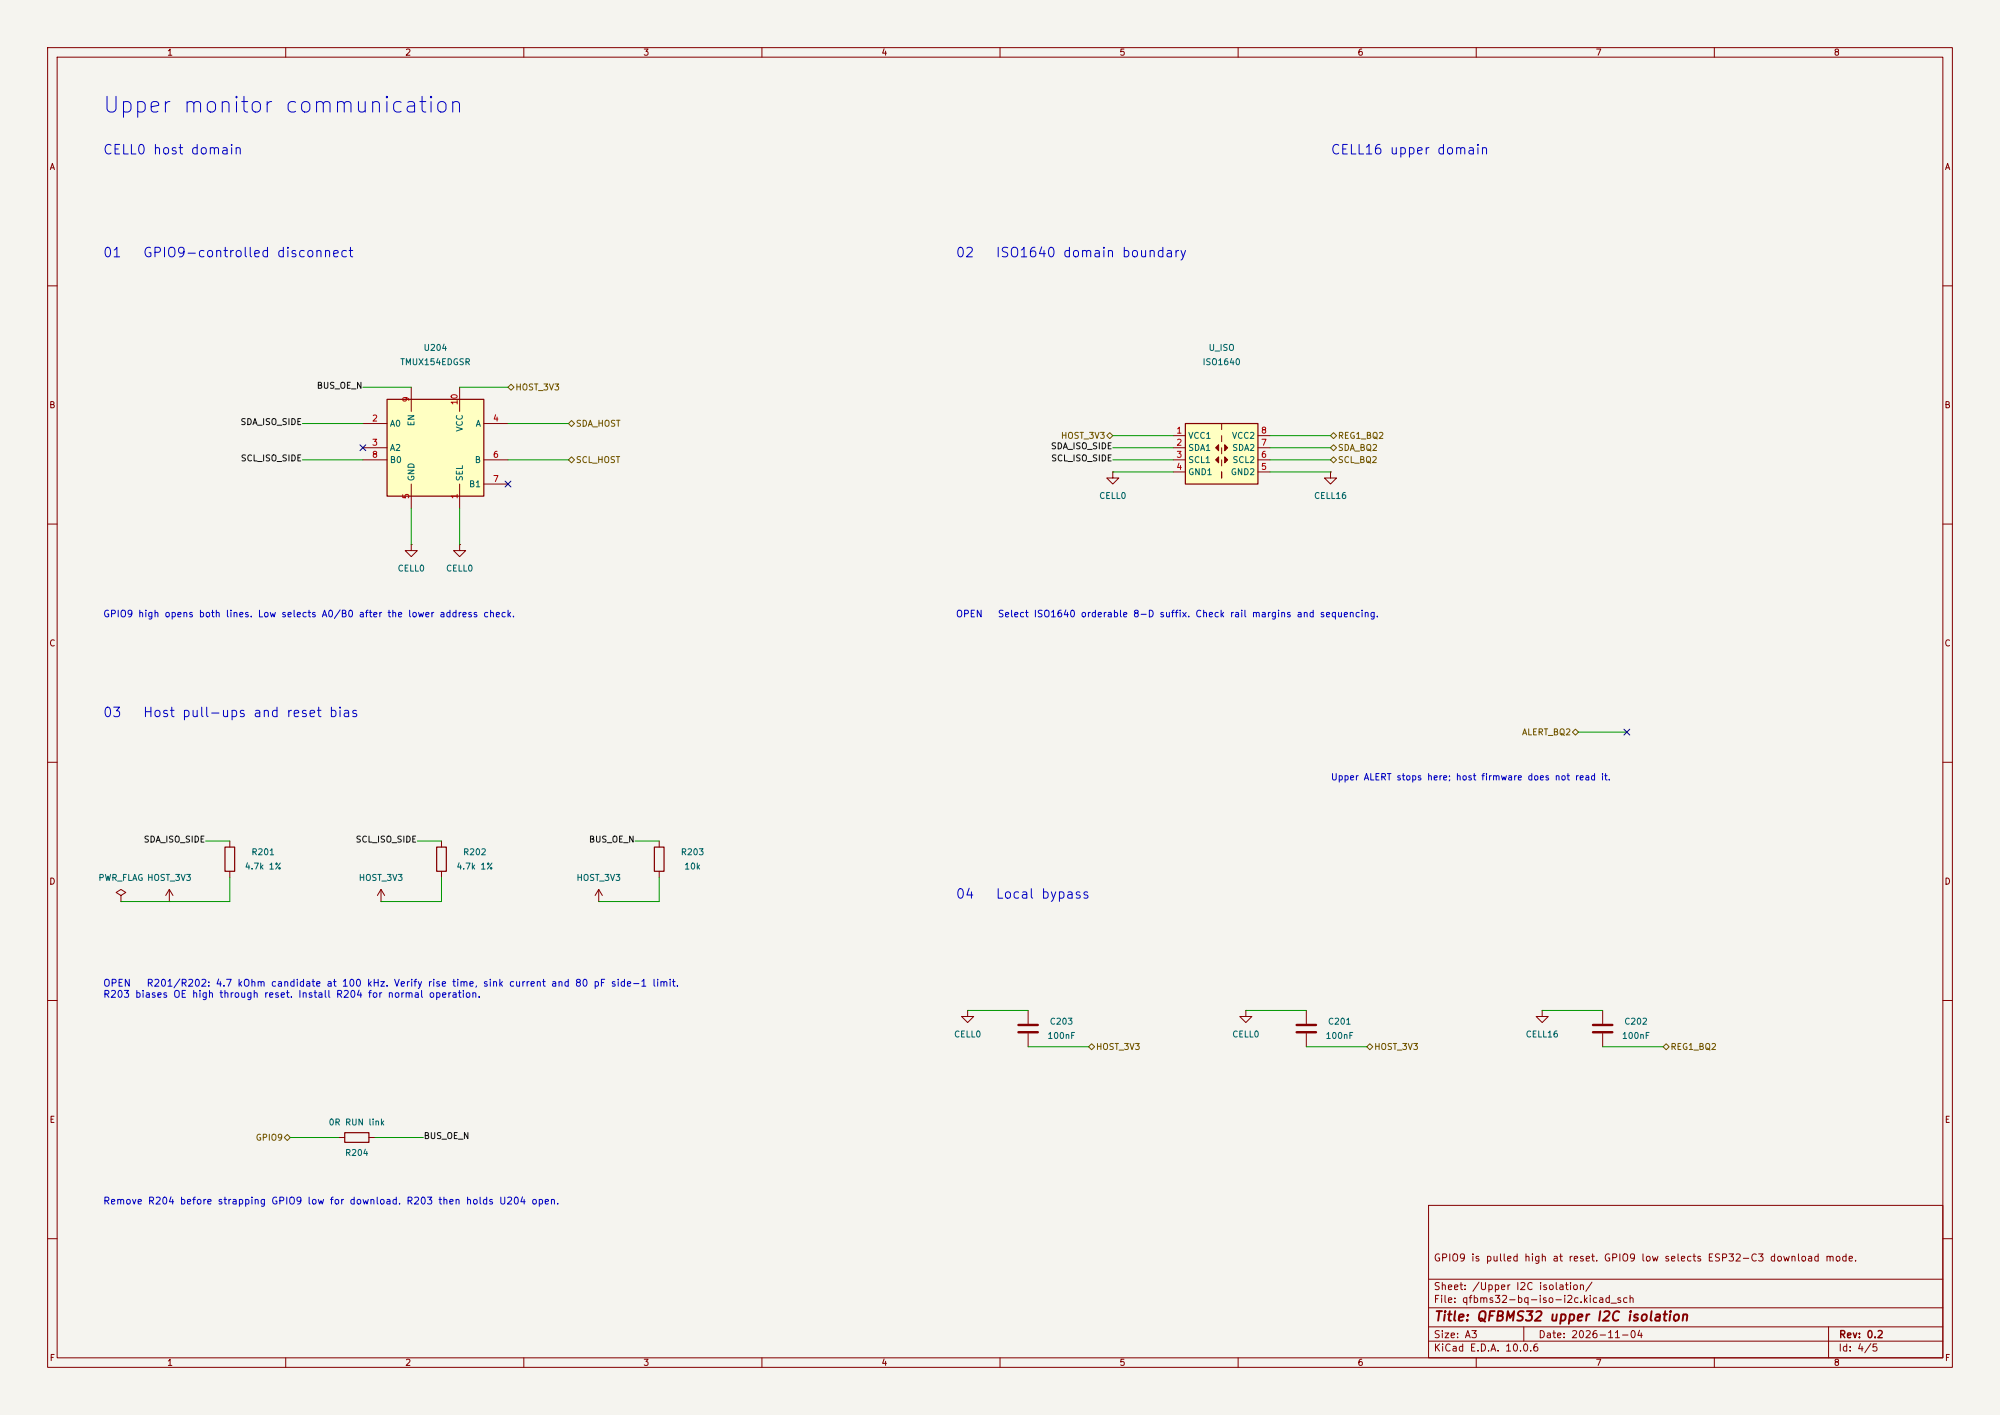
[picture p28: page 4]

R203 biases OE high through reset. Install R204 for normal operation. GPIO9 high opens both lines. Low selects A0/B0 after the lower address check. Remove R204 before strapping GPIO9 low for download. R203 then holds U204 open.

GPIO9 is pulled high at reset. GPIO9 low selects ESP32-C3 download mode.

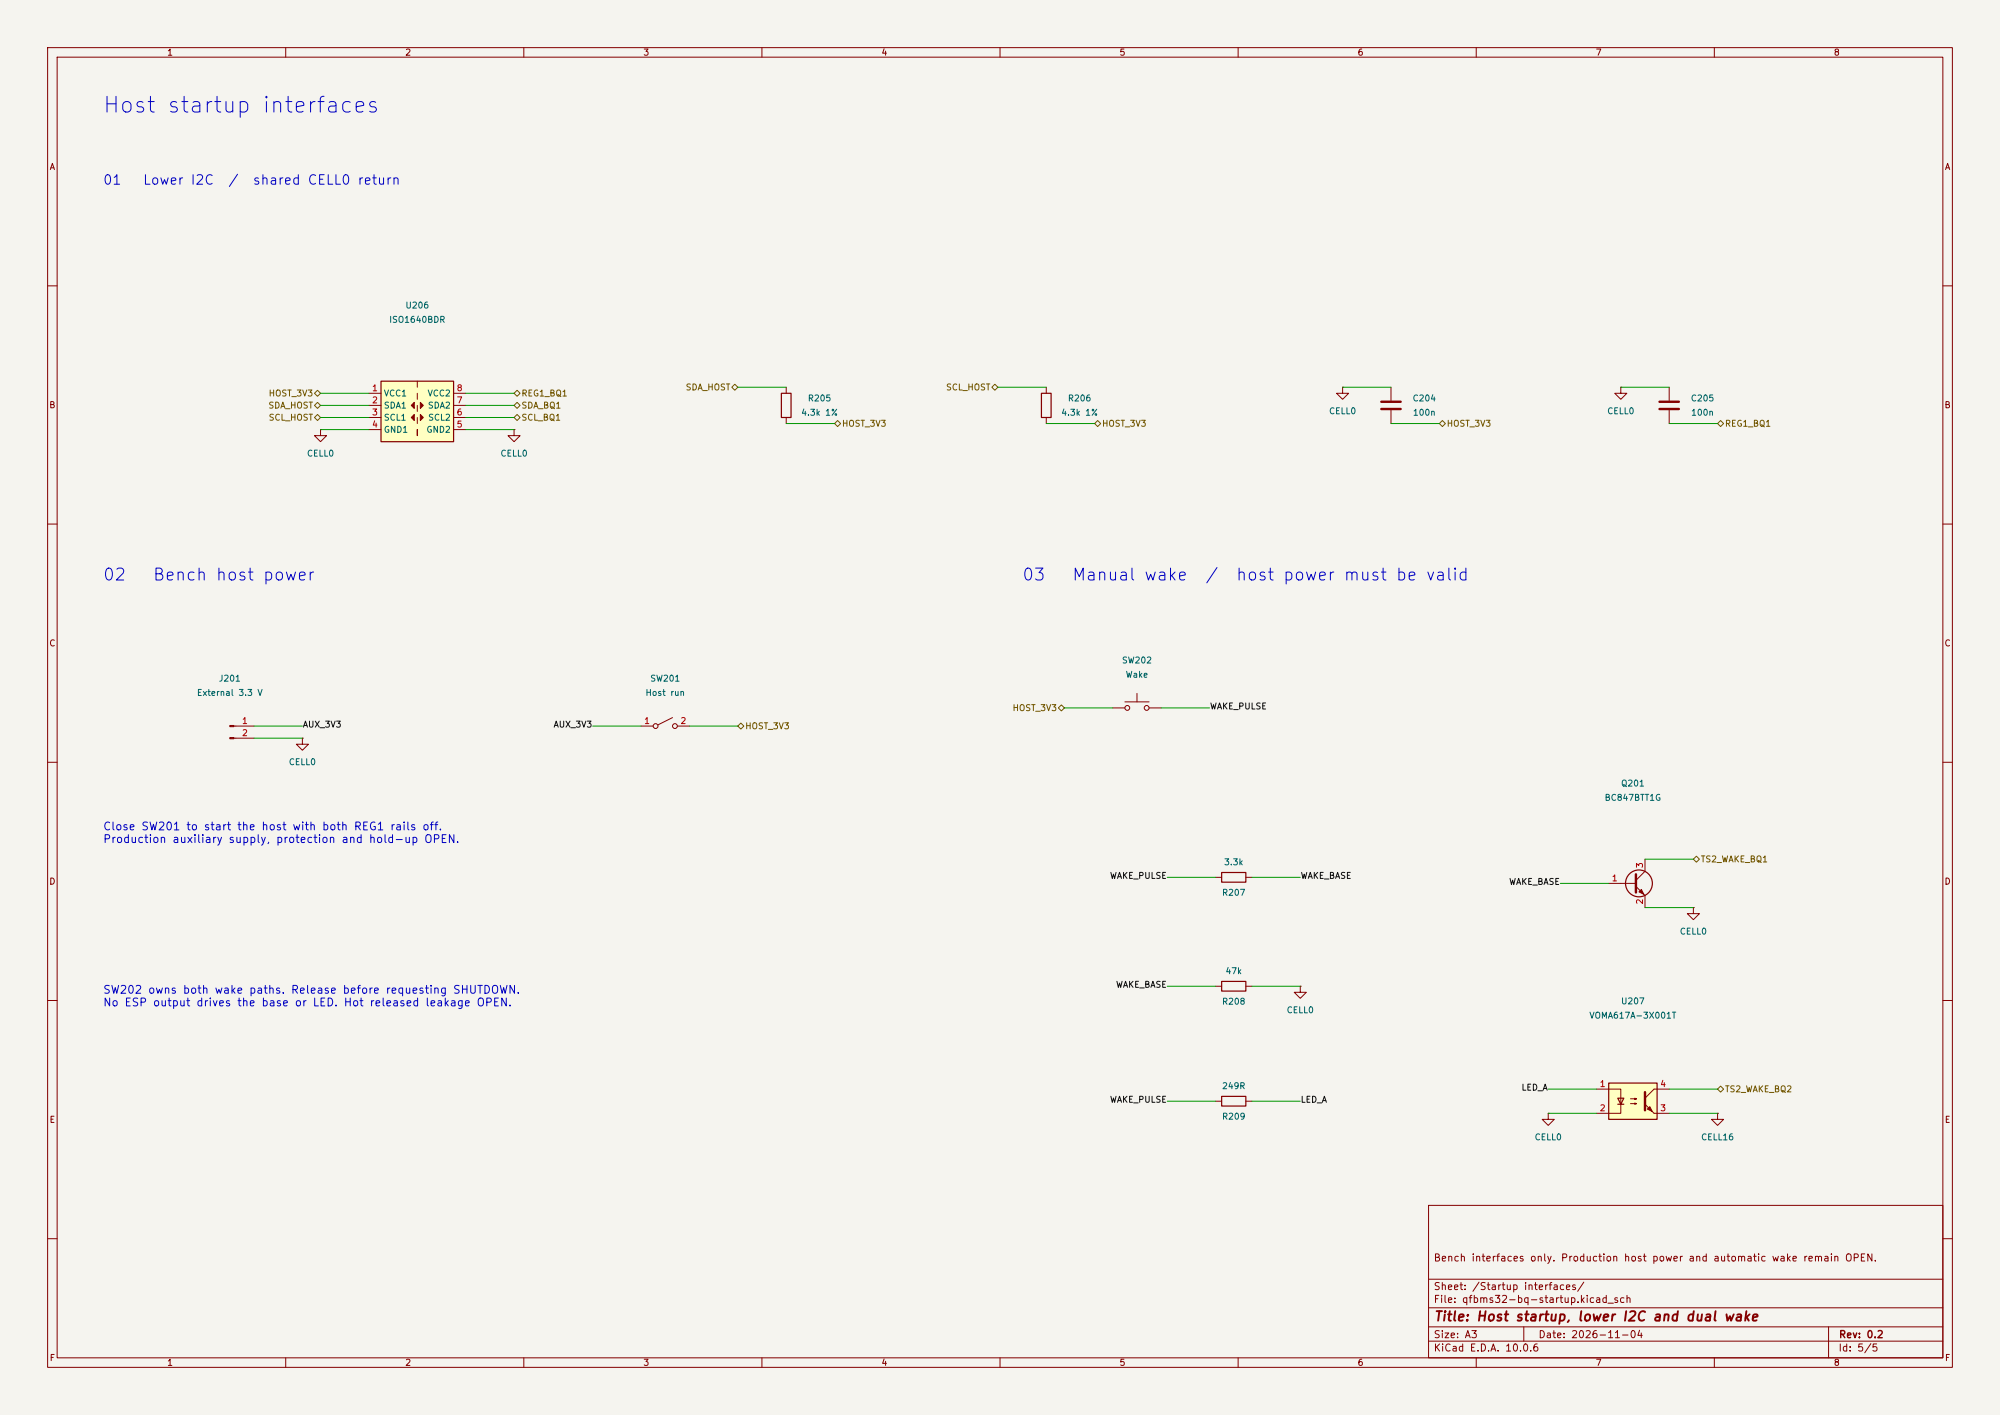
[picture p29: page 5]

Close SW201 to start the host with both REG1 rails off.
Production auxiliary supply, protection and hold-up OPEN.

SW202 owns both wake paths. Release before requesting SHUTDOWN.
No ESP output drives the base or LED. Hot released leakage OPEN.

Bench interfaces only. Production host power and automatic wake remain OPEN.

Sheet: /Startup interfaces/
File: qfbms32-bq-startup.kicad_sch
Title: Host startup, lower I2C and dual wake
