Focerqc/QFBMS/docs/review-2026-11-04/monitor.pdf

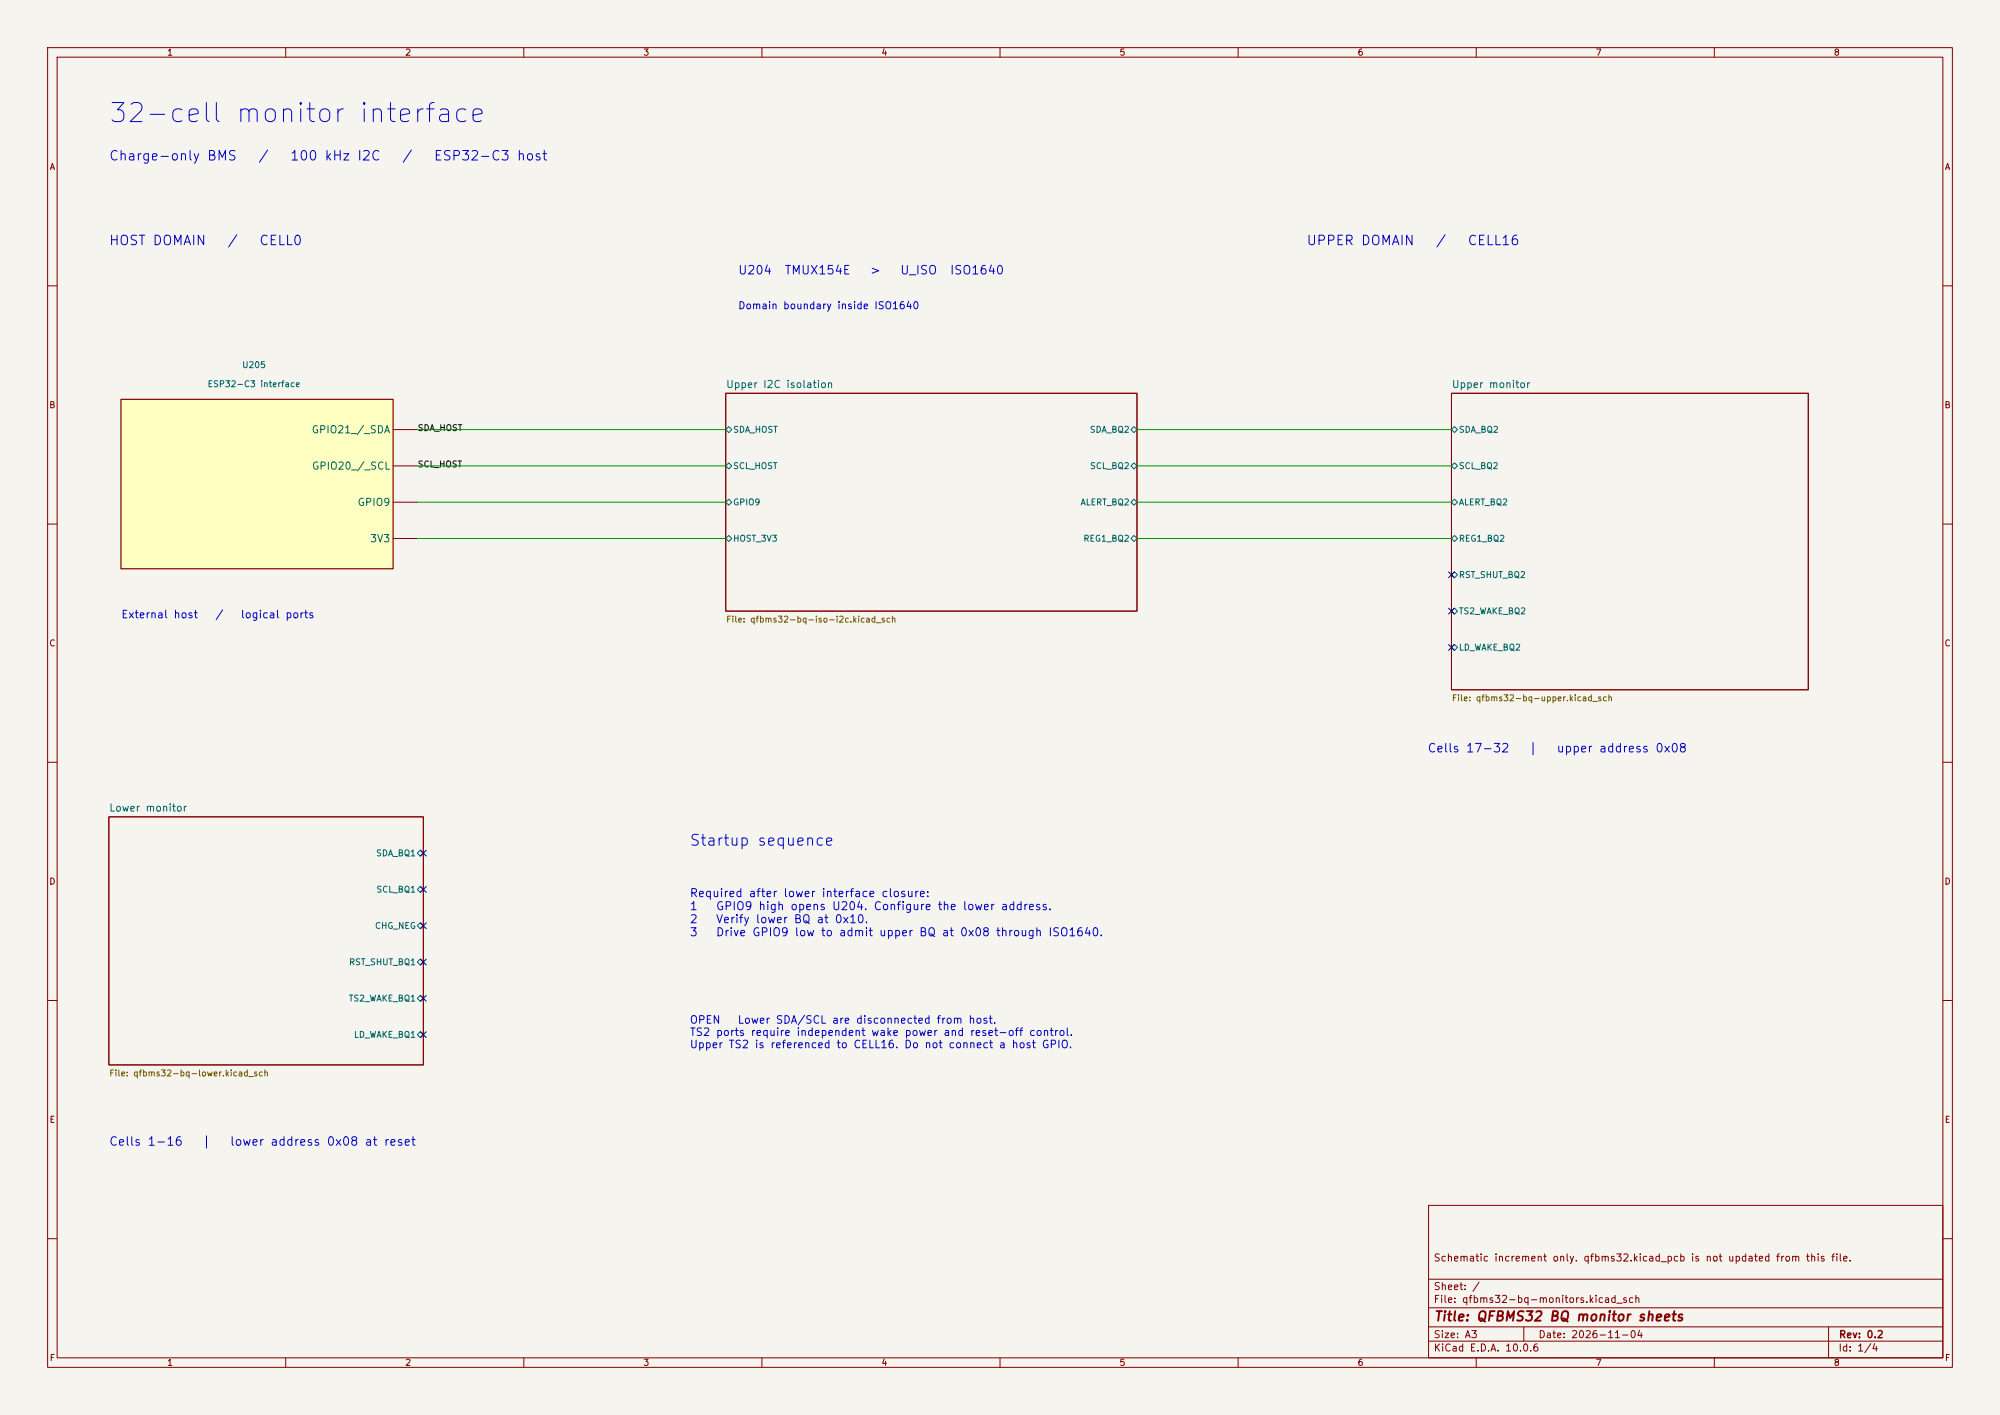
[picture p30: page 1]

LD_WAKE_BQ2 Upper monitor File: qfbms32-bq-upper.kicad_sch SDA_BQ2

LD_WAKE_BQ1 Lower monitor File: qfbms32-bq-lower.kicad_sch

Required after lower interface closure:

TS2 ports require independent wake power and reset-off control.
Upper TS2 is referenced to CELL16. Do not connect a host GPIO.

Schematic increment only. qfbms32.kicad_pcb is not updated from this file.

Sheet: /
File: qfbms32-bq-monitors.kicad_sch
Title: QFBMS32 BQ monitor sheets

Size: A3 | Rev: 0.2 | F Date: 2026-11-04
KiCad E.D.A. 10.0.6 | Id: 1/4

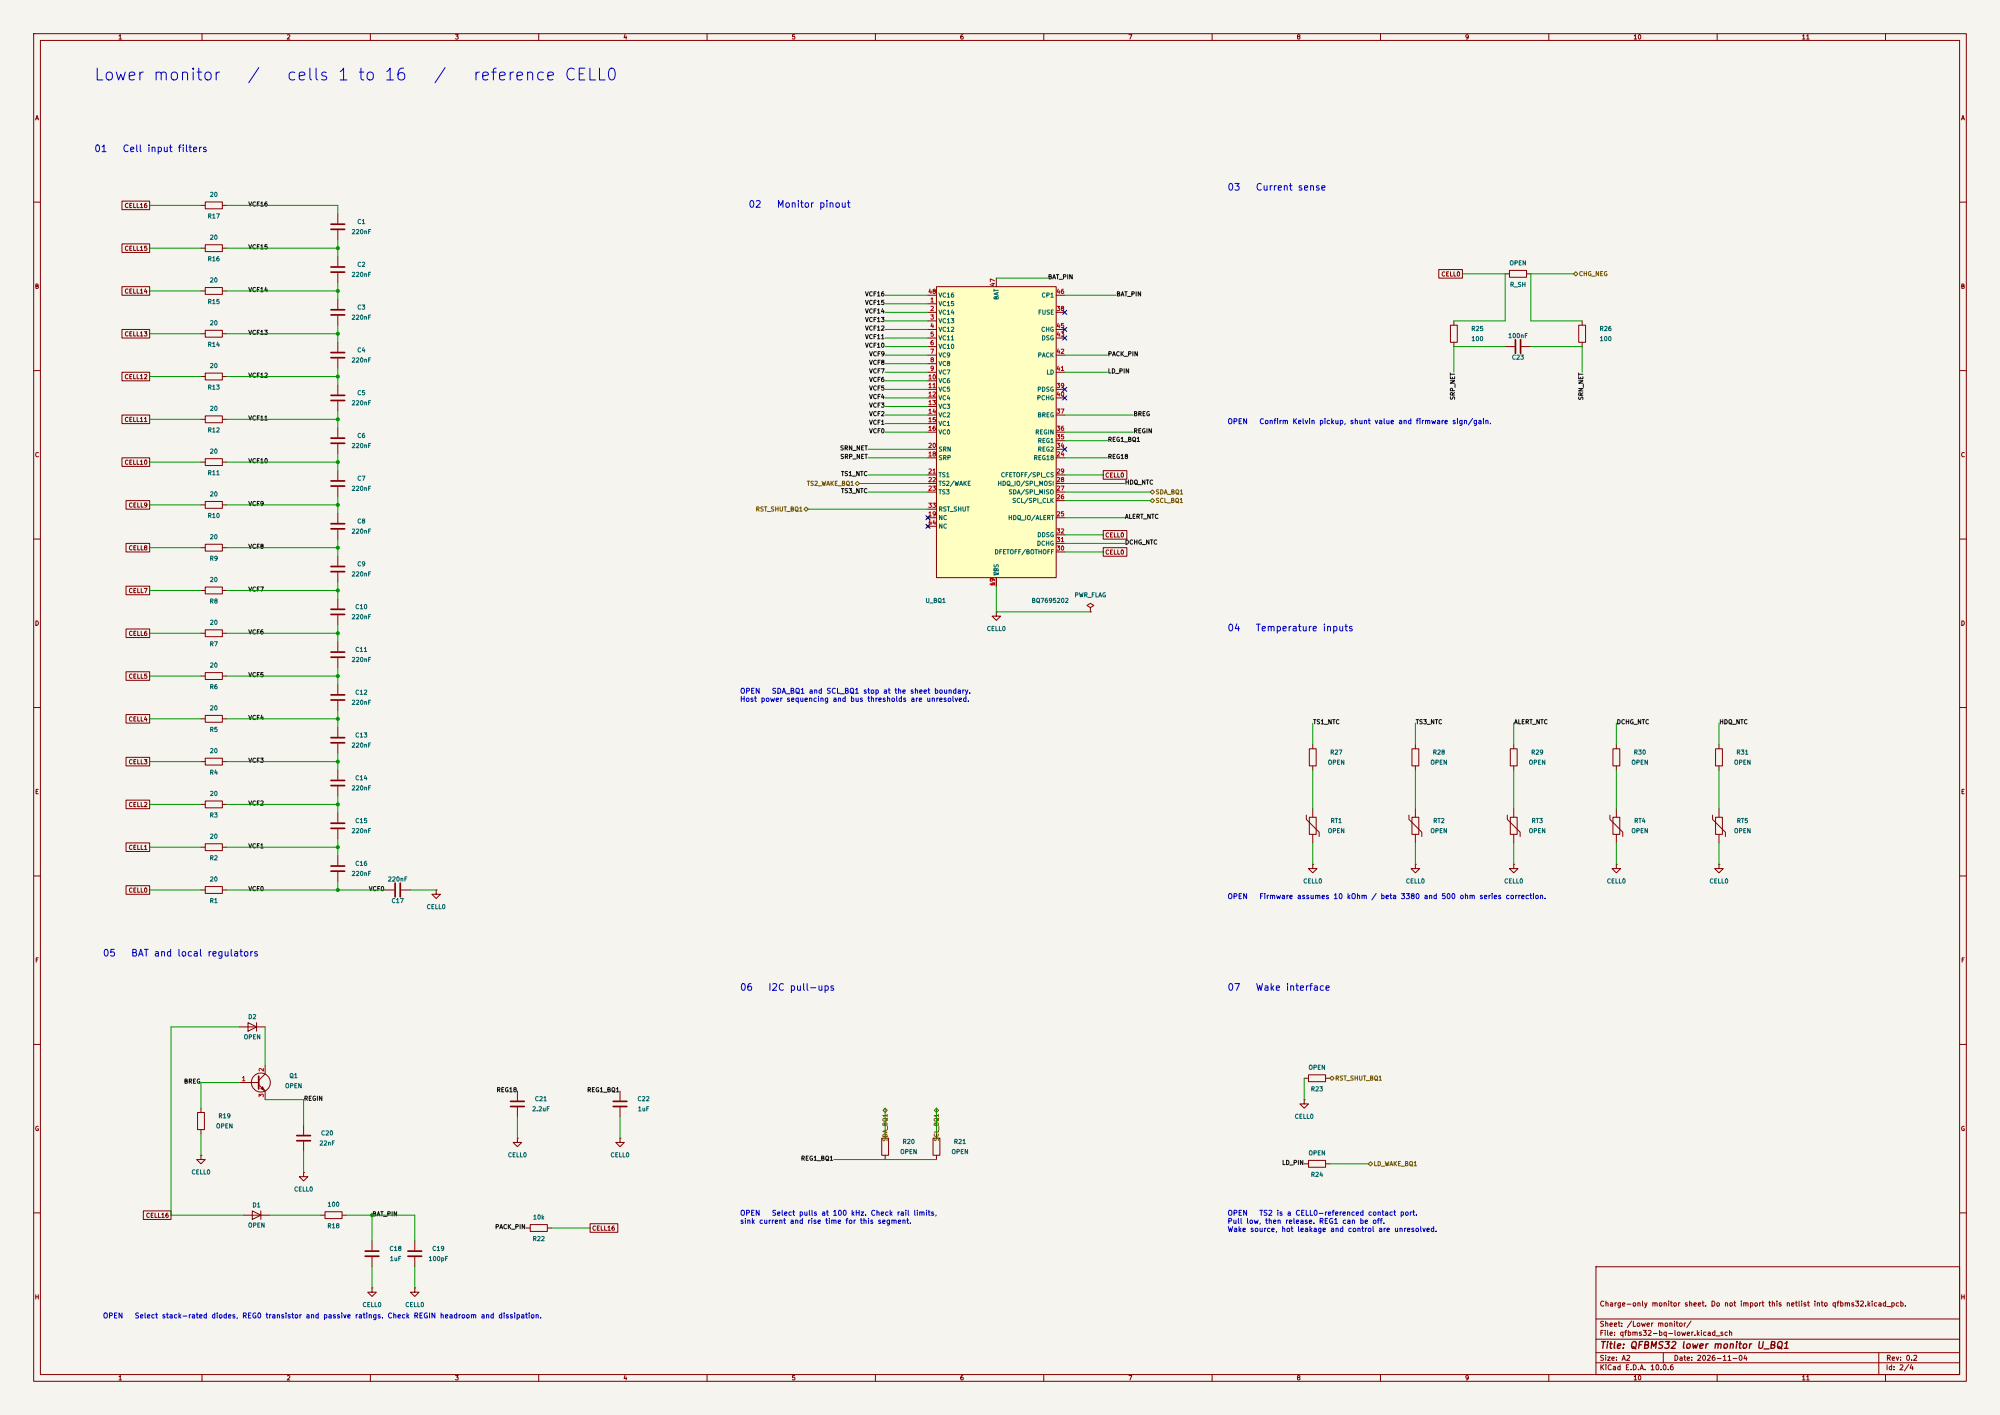
[picture p31: page 2]

Host power sequencing and bus thresholds are unresolved.

sink current and rise time for this segment.

Pull low, then release. REG1 can be off.
Wake source, hot leakage and control are unresolved.

Charge-only monitor sheet. Do not import this netlist into qfbms32.kicad_pcb.

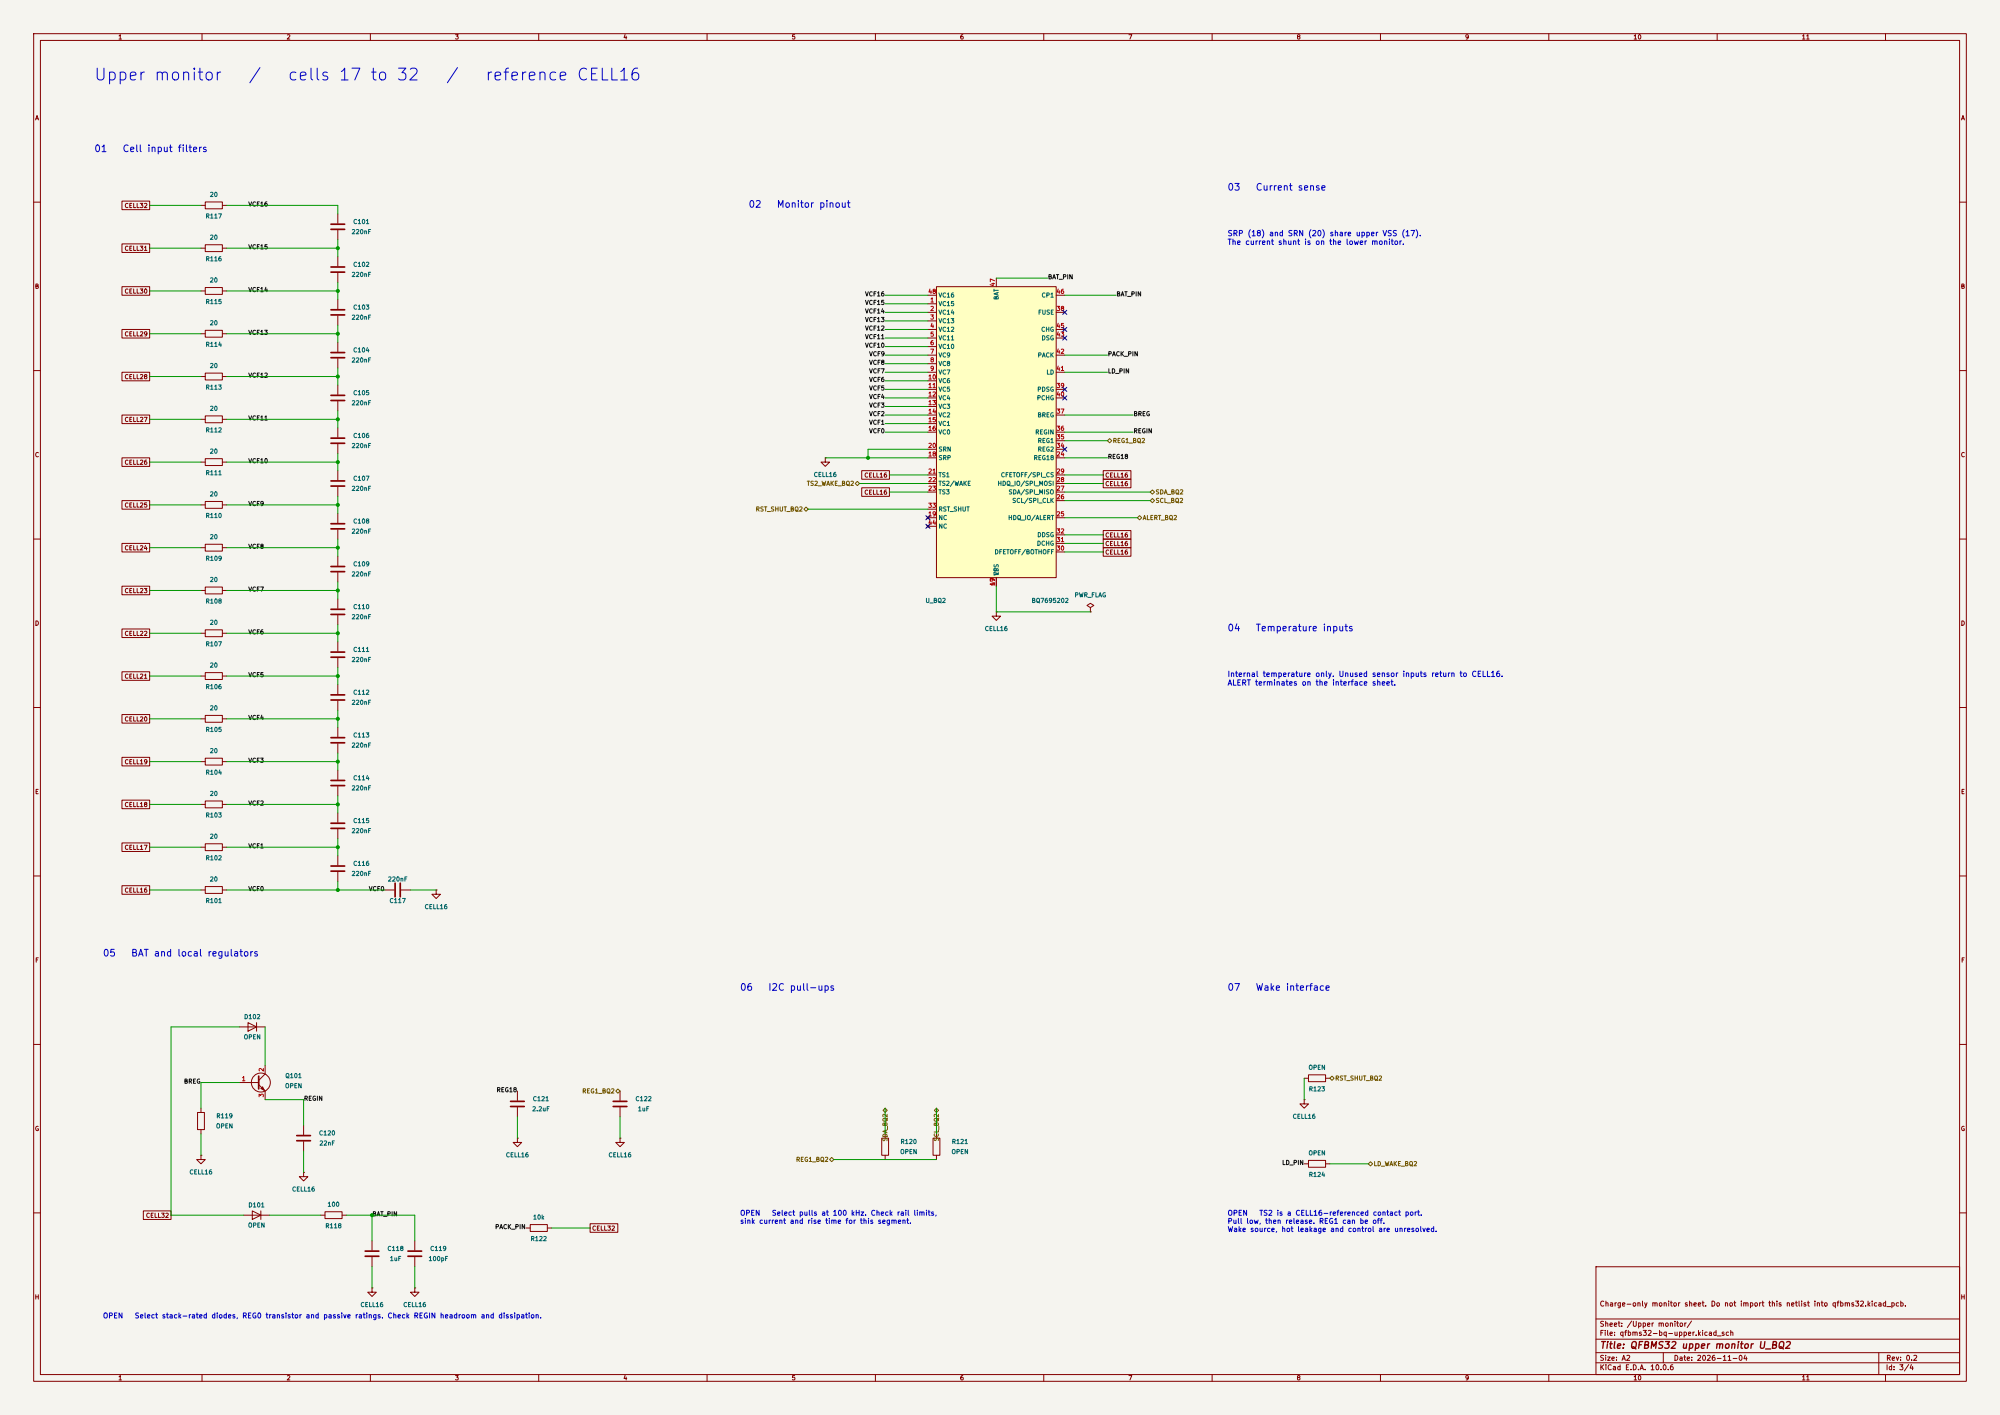
[picture p32: page 3]

SRP (18) and SRN (20) share upper VSS (17).
The current shunt is on the lower monitor.

Internal temperature only. Unused sensor inputs return to CELL16.
ALERT terminates on the interface sheet.

Charge-only monitor sheet. Do not import this netlist into qfbms32.kicad_pcb. R120 OPEN

sink current and rise time for this segment.

Pull low, then release. REG1 can be off.
Wake source, hot leakage and control are unresolved.

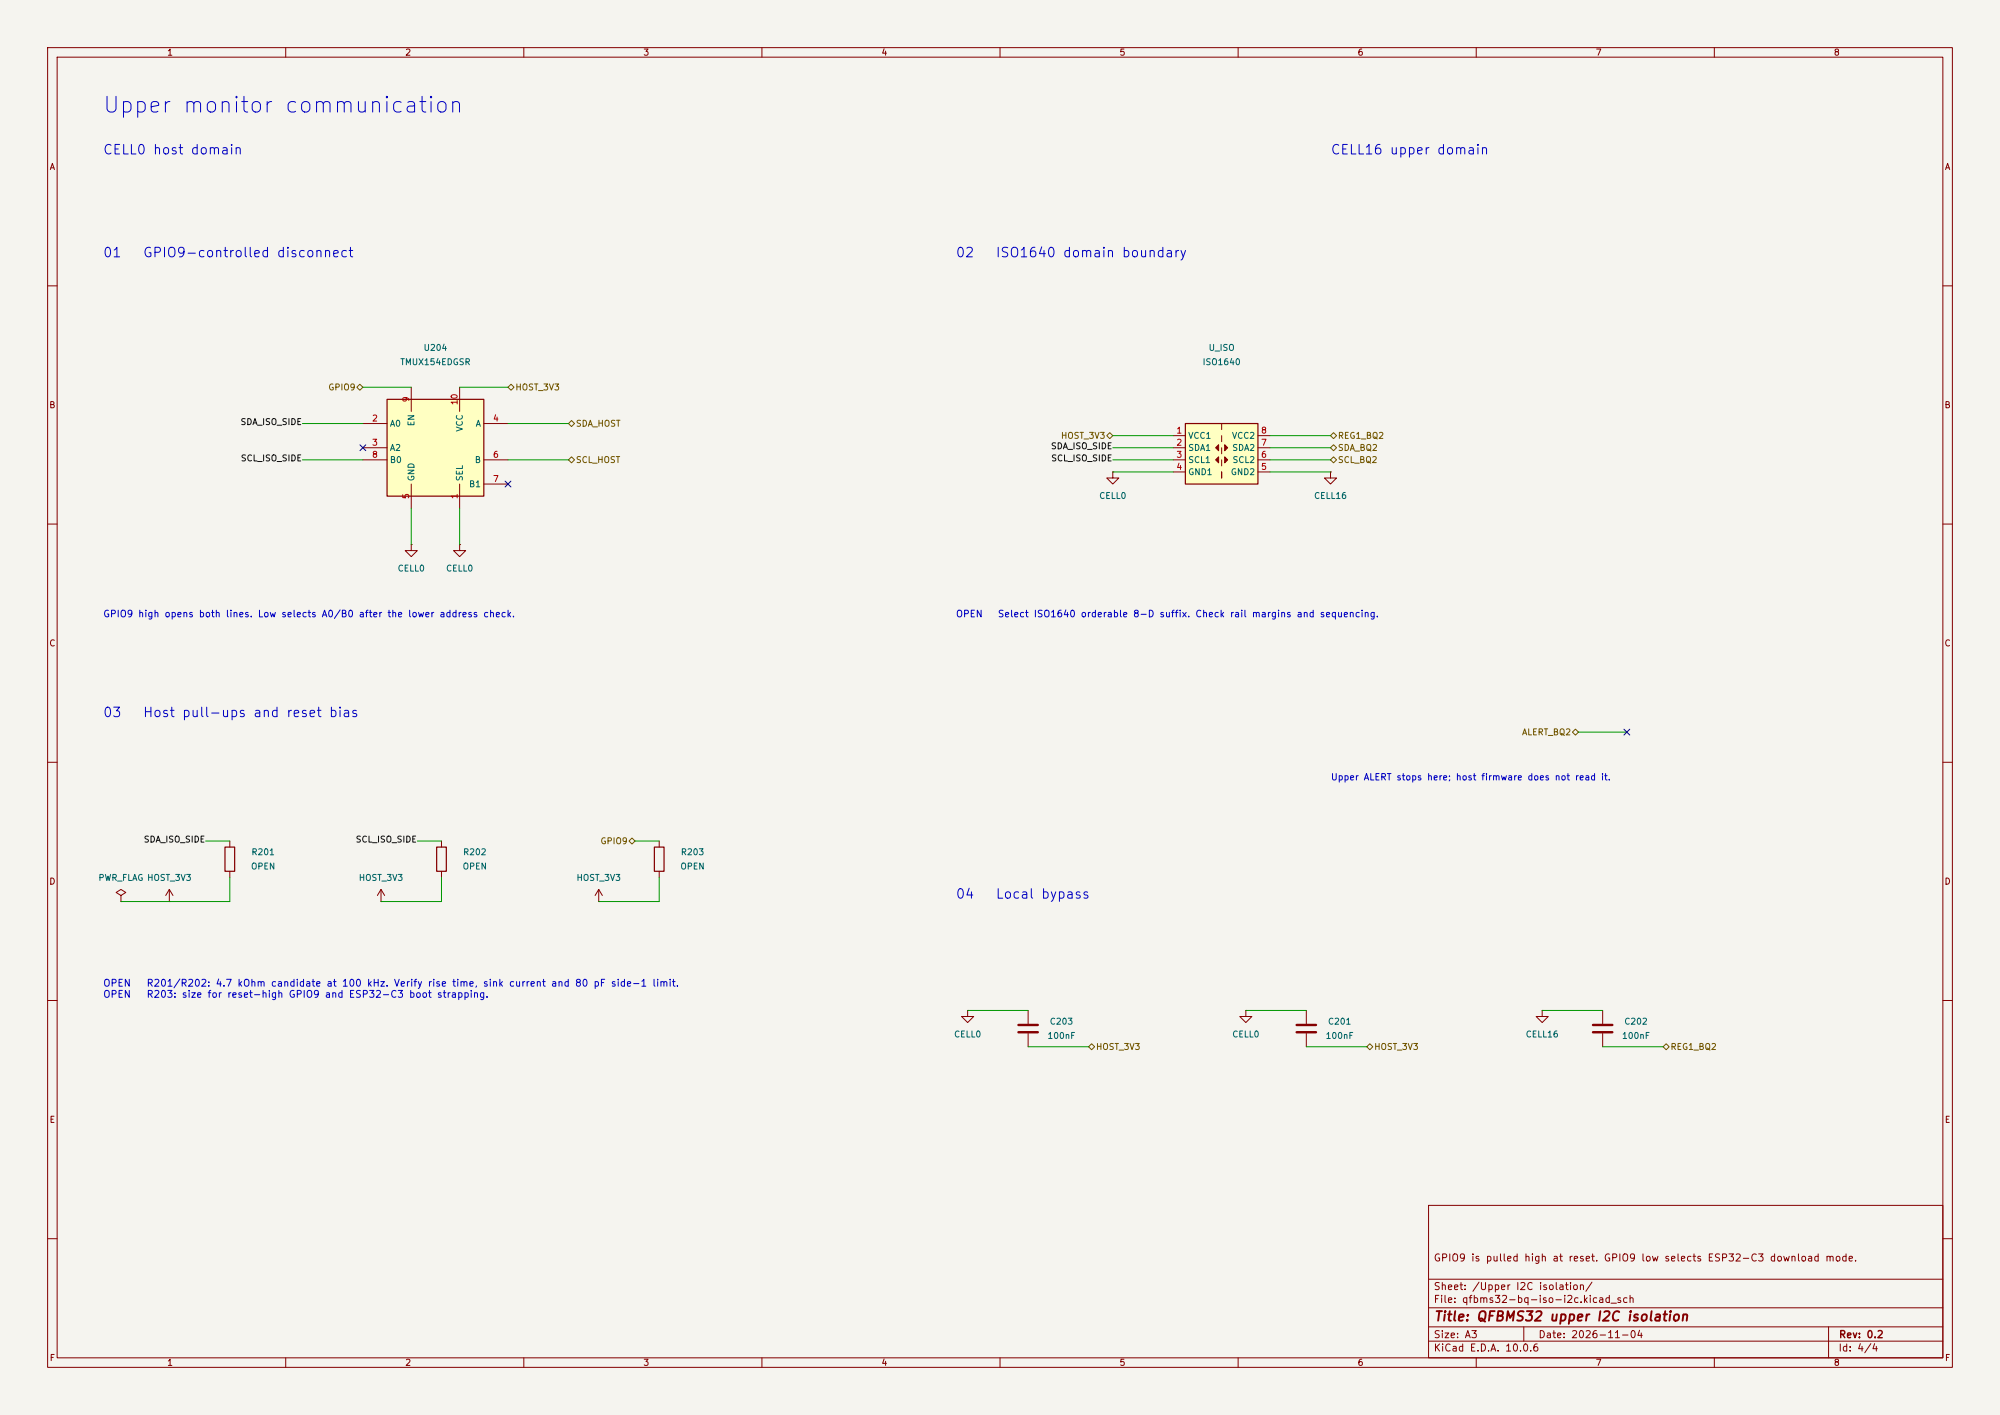
[picture p33: page 4]
