Focerqc/QFBMS/output/pdf/qfbms32-bq-monitors.pdf

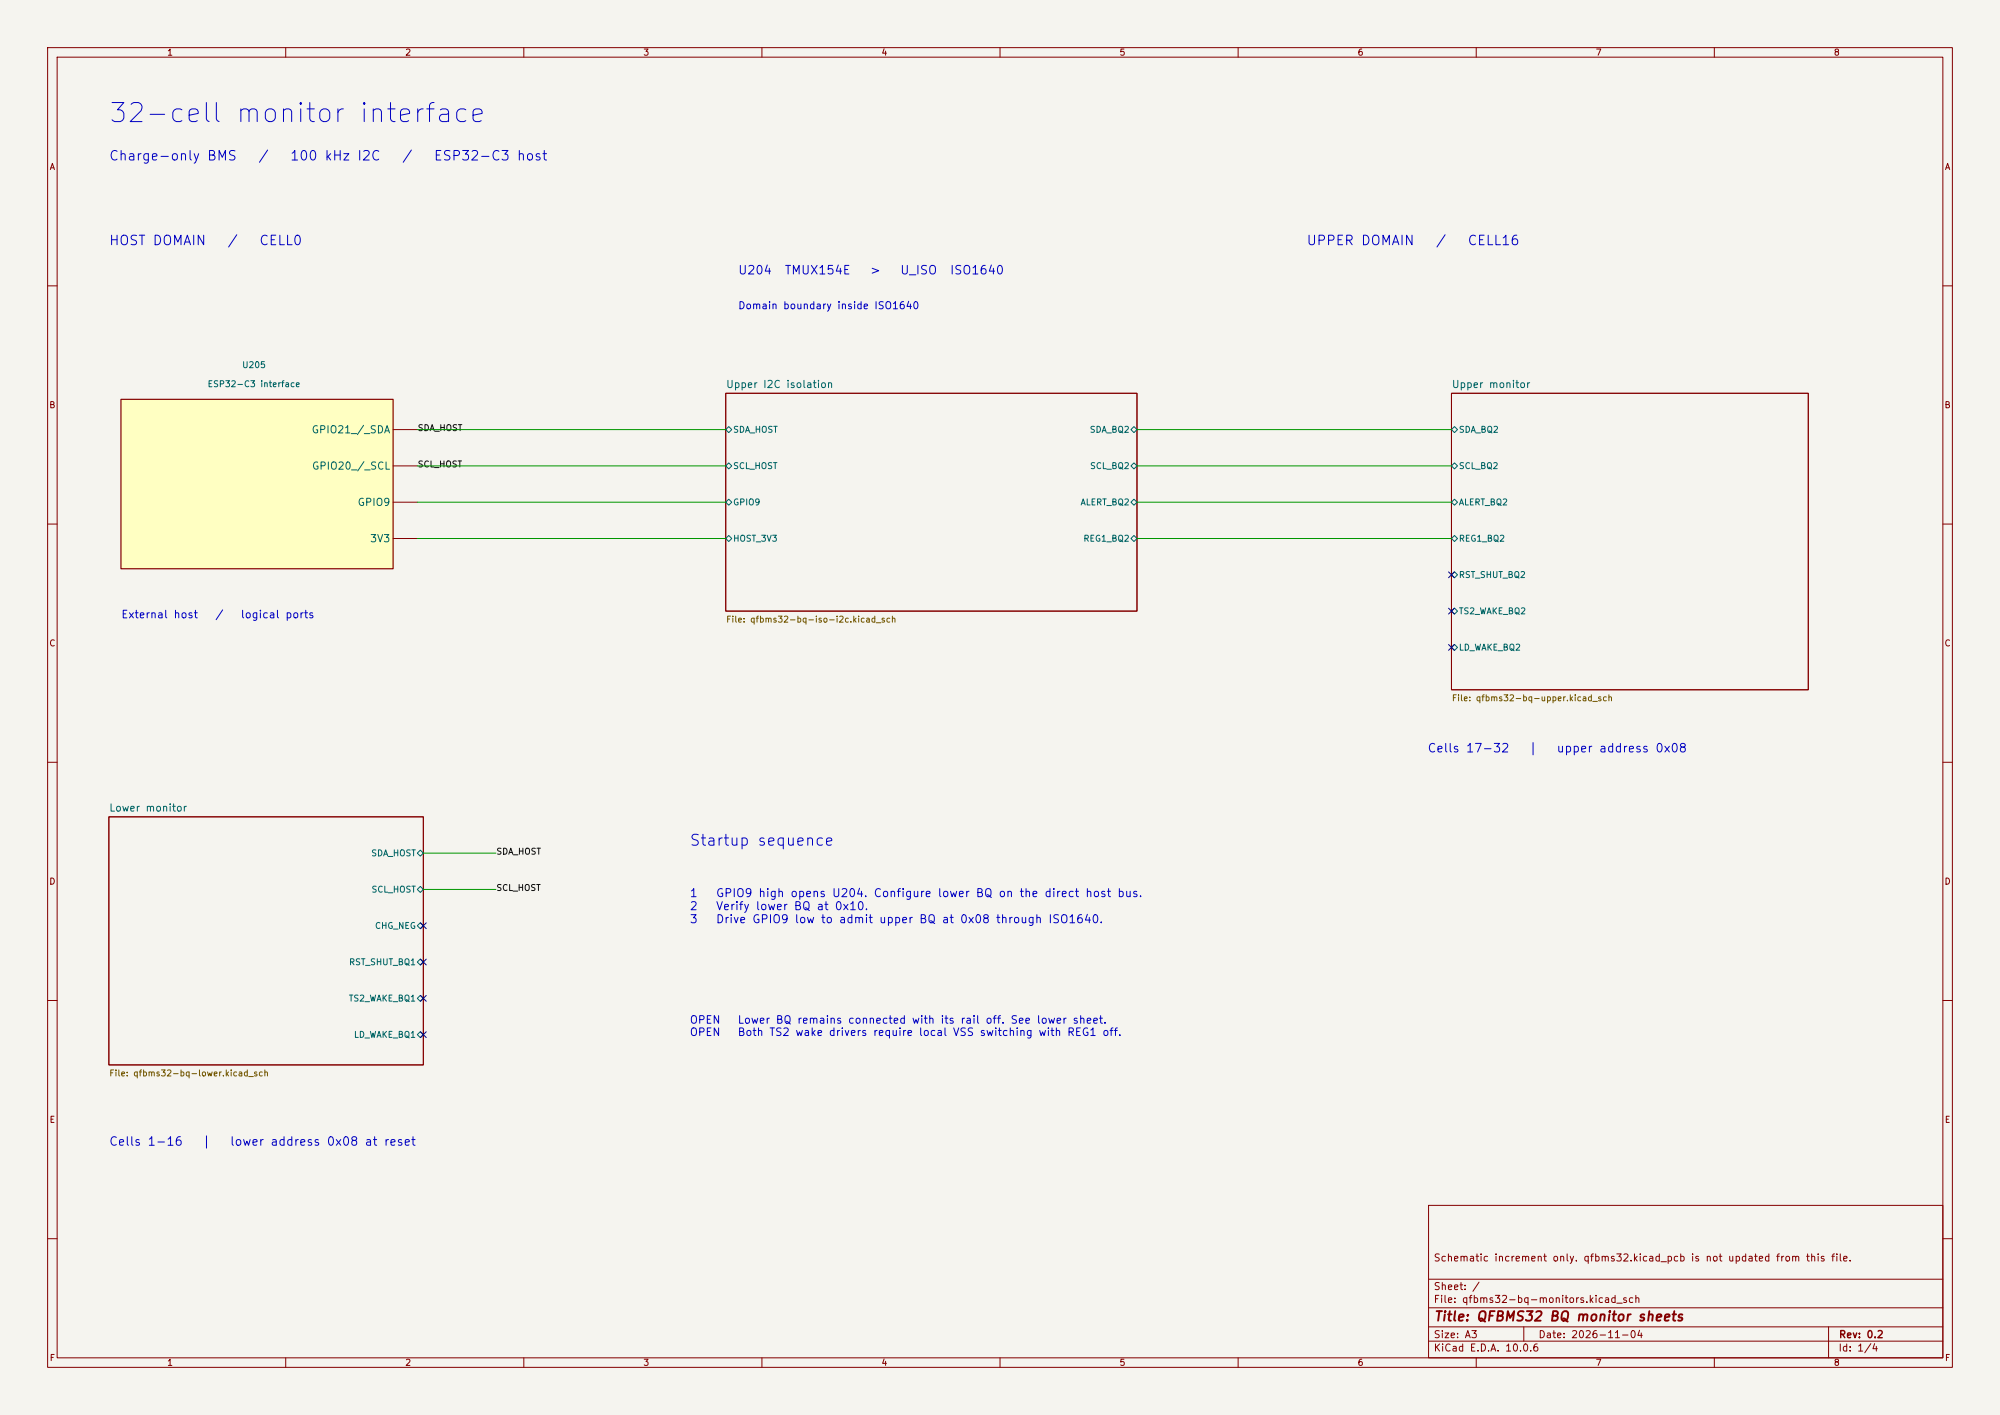
[picture p34: page 1]

LD_WAKE_BQ2 Upper monitor File: qfbms32-bq-upper.kicad_sch

LD_WAKE_BQ1 Lower monitor File: qfbms32-bq-lower.kicad_sch

Schematic increment only. qfbms32.kicad_pcb is not updated from this file.

Sheet: /
File: qfbms32-bq-monitors.kicad_sch
Title: QFBMS32 BQ monitor sheets

Size: A3 | Rev: 0.2 | F Date: 2026-11-04
KiCad E.D.A. 10.0.6 | Id: 1/4

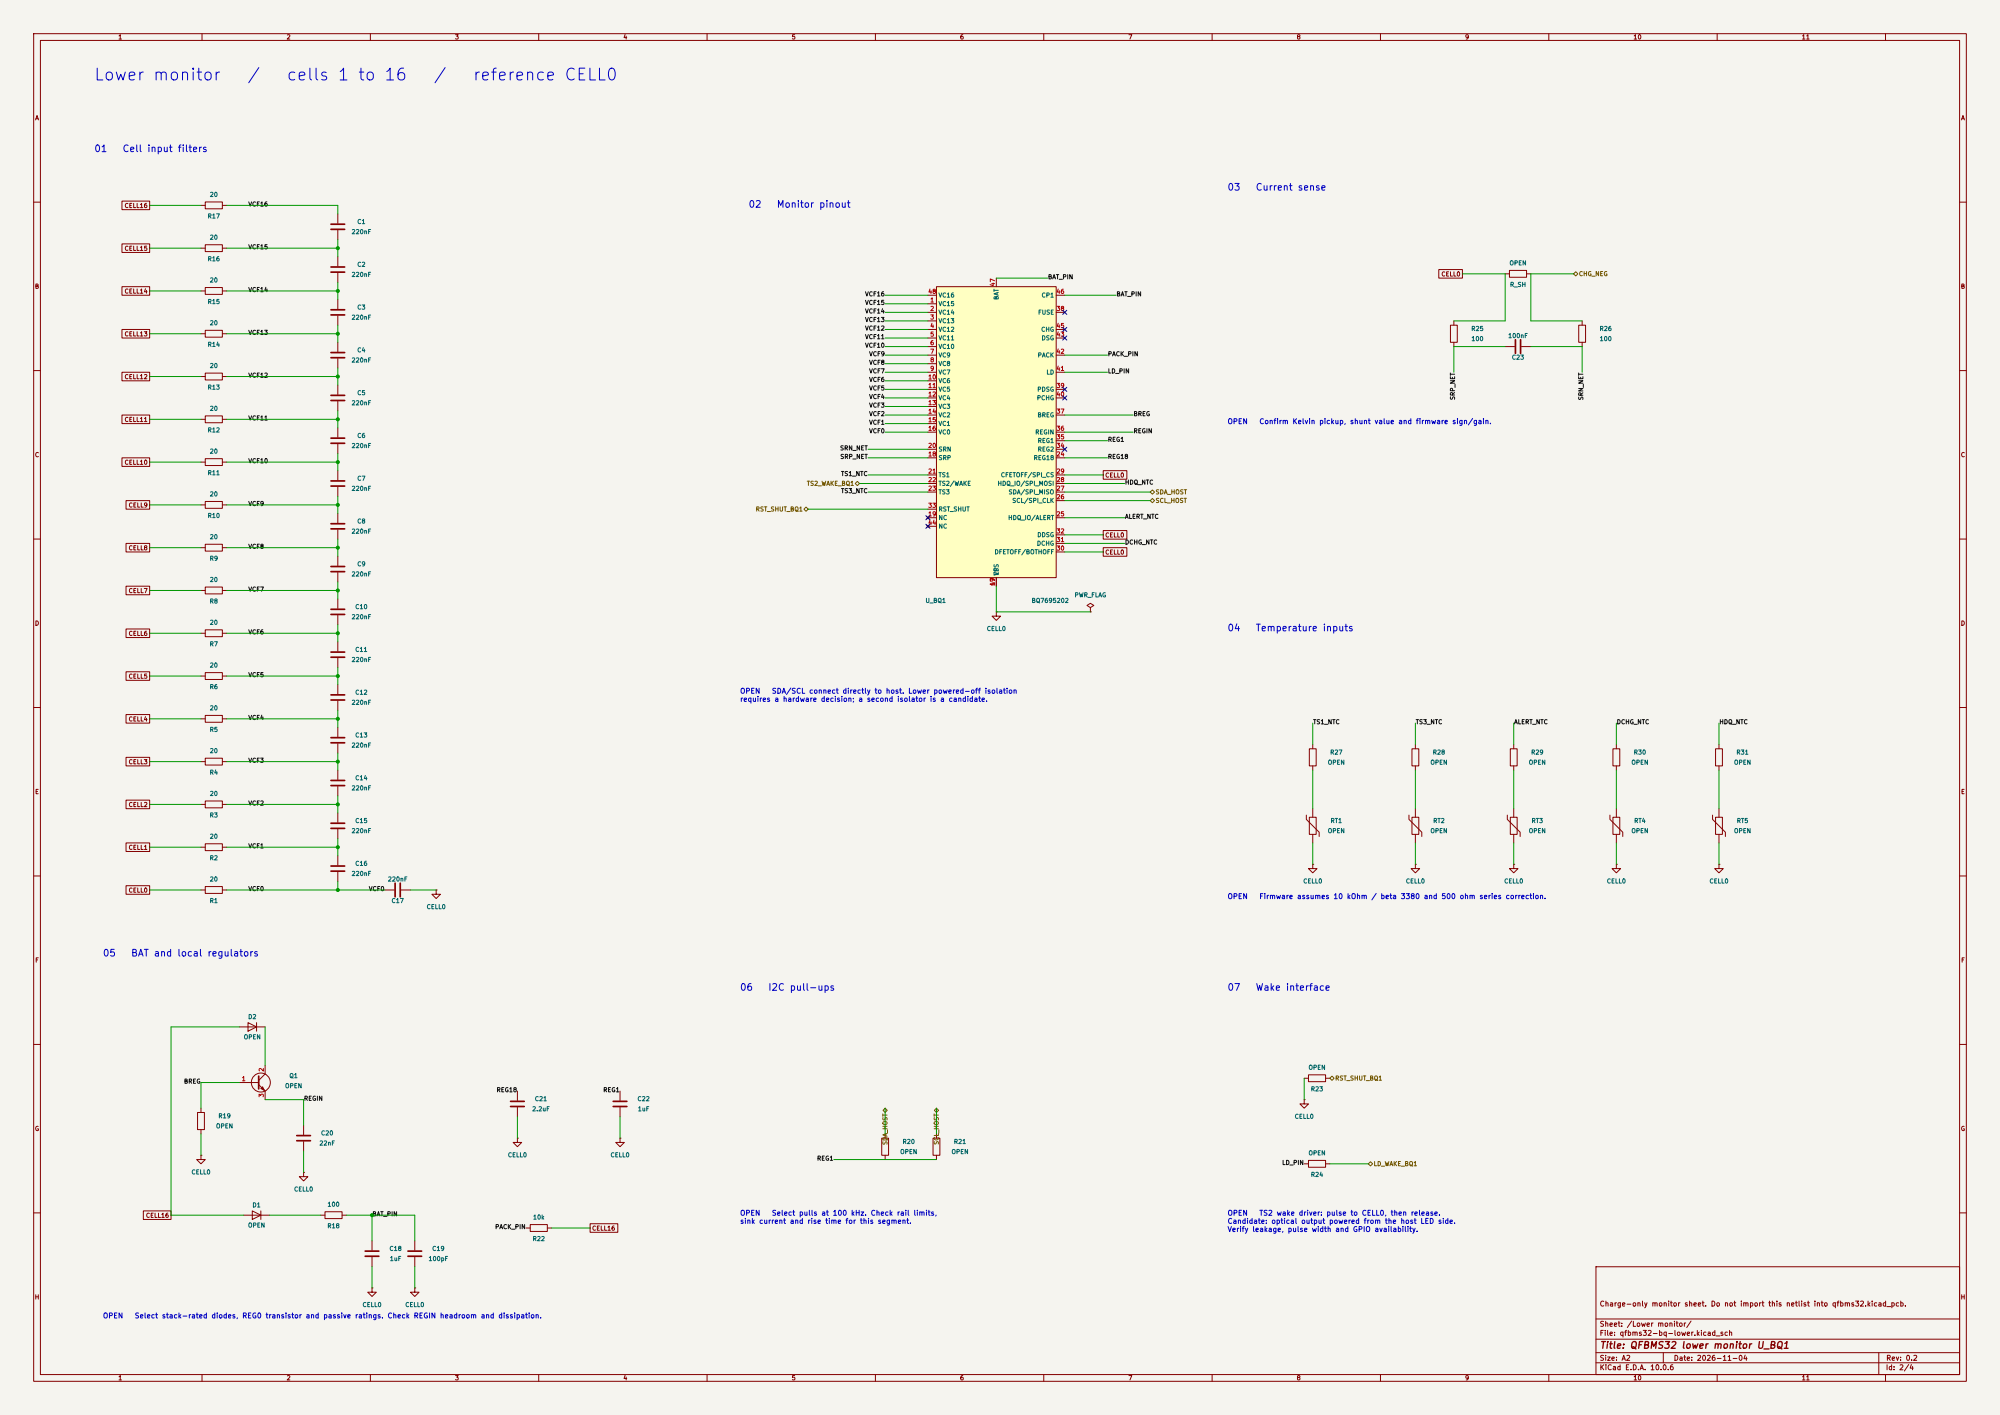
[picture p35: page 2]

requires a hardware decision; a second isolator is a candidate.

sink current and rise time for this segment.

Candidate: optical output powered from the host LED side.
Verify leakage, pulse width and GPIO availability.

Charge-only monitor sheet. Do not import this netlist into qfbms32.kicad_pcb.

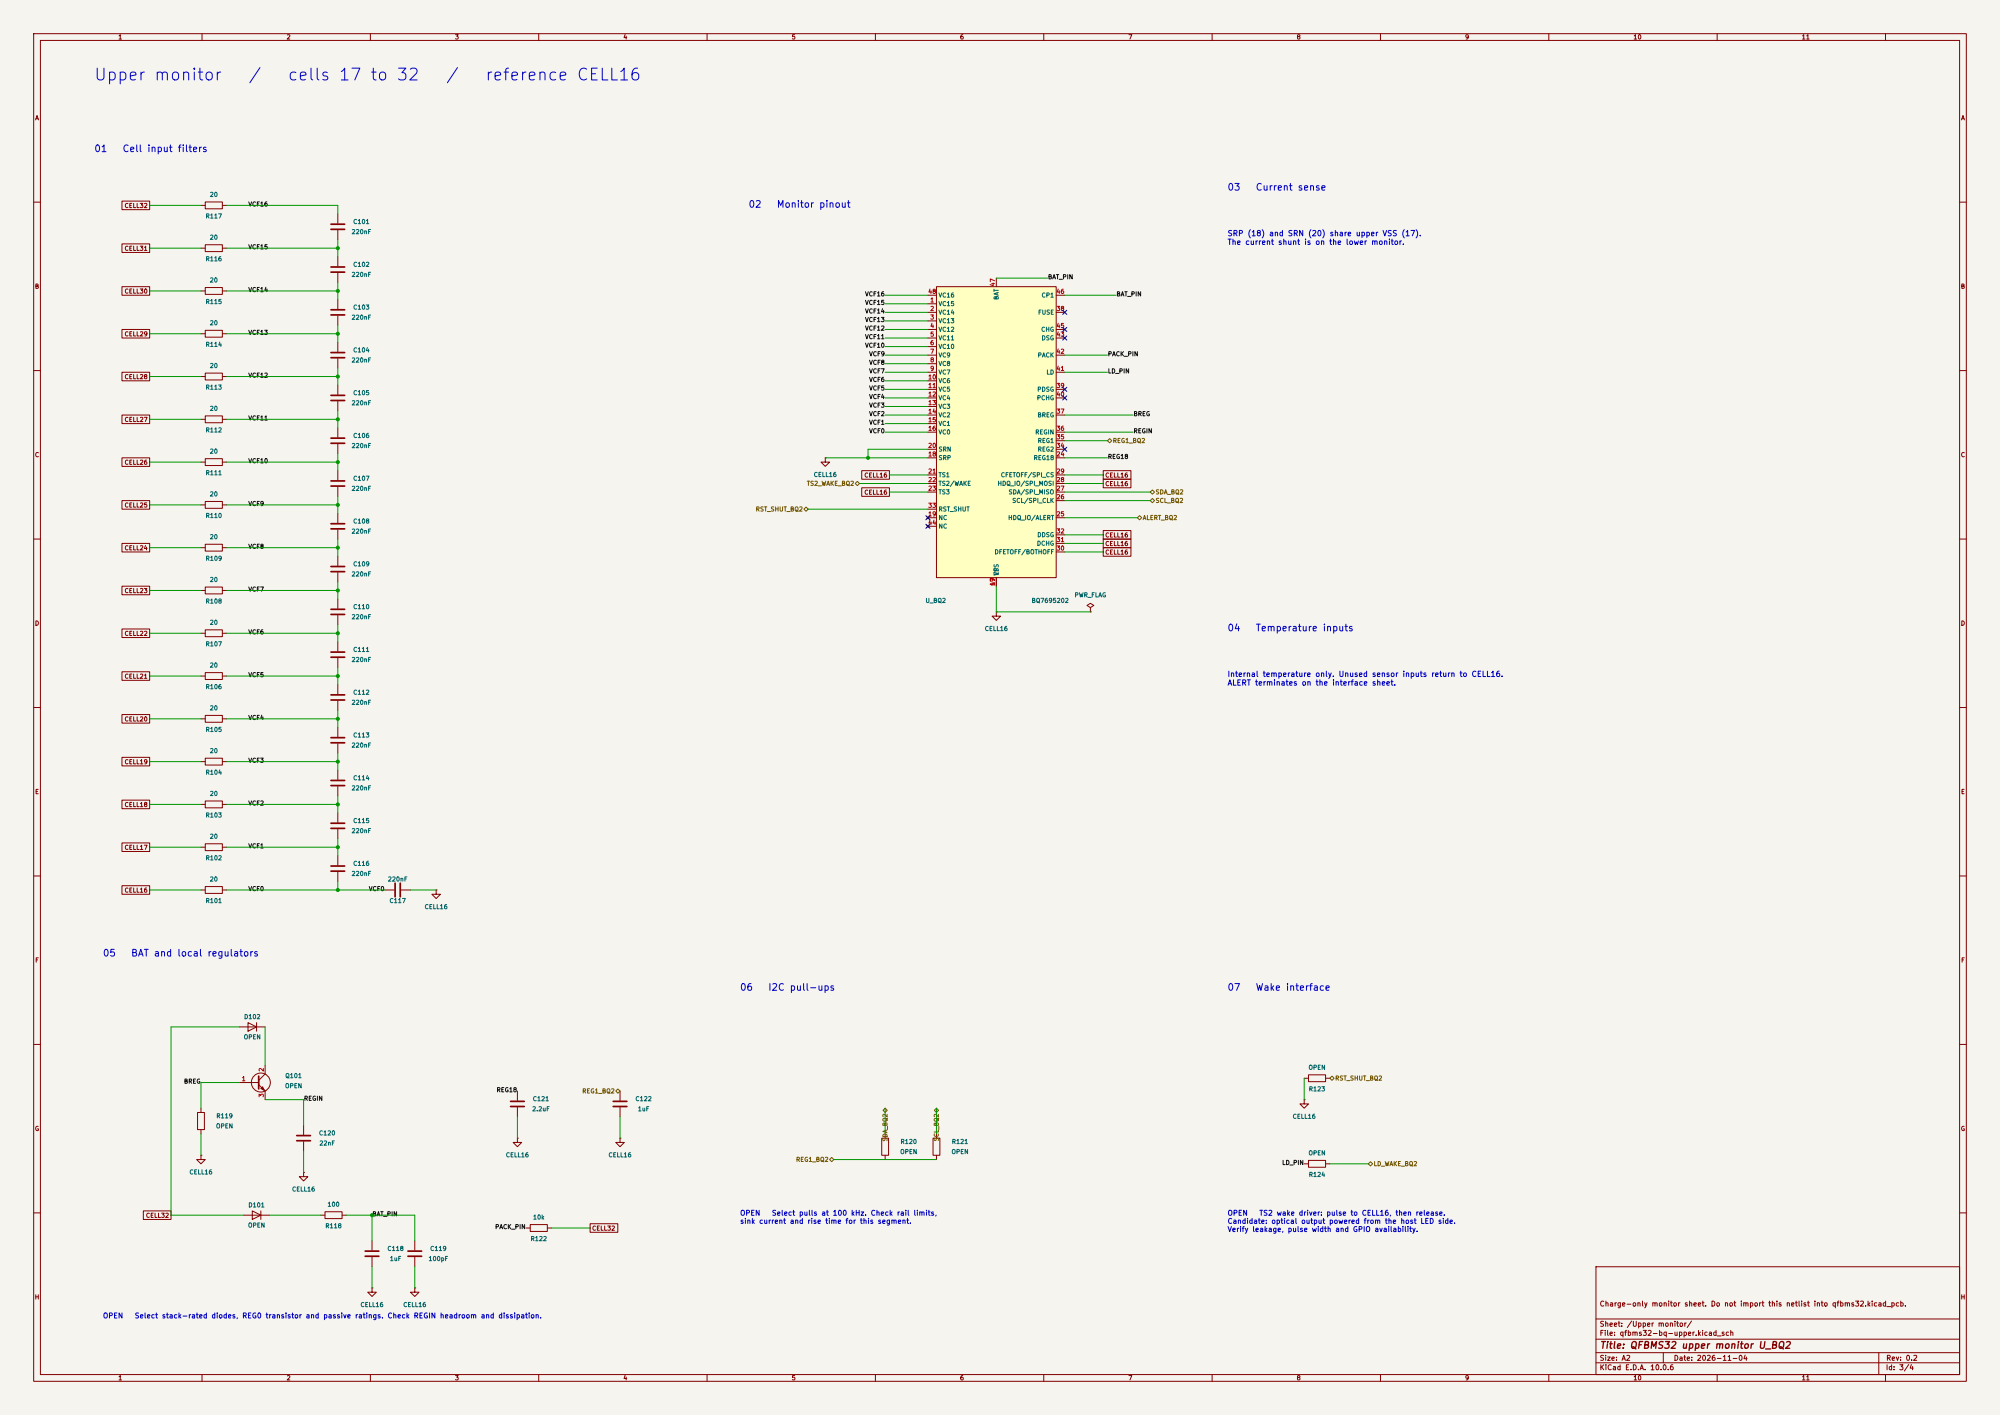
[picture p36: page 3]

SRP (18) and SRN (20) share upper VSS (17).
The current shunt is on the lower monitor.

Internal temperature only. Unused sensor inputs return to CELL16.
ALERT terminates on the interface sheet.

Charge-only monitor sheet. Do not import this netlist into qfbms32.kicad_pcb. R120 OPEN

sink current and rise time for this segment.

Candidate: optical output powered from the host LED side.
Verify leakage, pulse width and GPIO availability.
