Focerqc/QFBMS/qfbms32.kicad_pcb

## KiCad design qfbms32.kicad_pcb (2026-11-04)

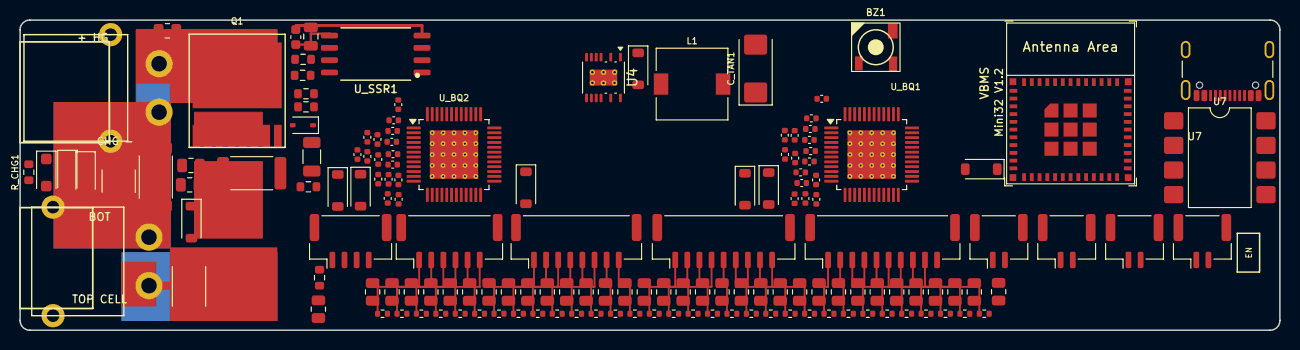
[picture p37: board qfbms32.kicad_pcb from above]

Board: 2 copper layers, 130.0 x 32.0 mm, 149 parts (0 on the bottom side), 84 nets.

Parts:
BZ1: FUET-5030; Buzzer_5.0x5.0mm_SMD
C_DISC: 10uF; C_1206_3216Metric
C_F1, C_F2, C_F3, C_F4, C_F5, C_F6, C_F7, C_F8, C_F9, C_F10, C_F11, C_F12, C_F13, C_F14, C_F15, C_F16, C_F17, C_F18, C_F19, C_F20, C_F21, C_F22, C_F23, C_F24, C_F25, C_F26, C_F27, C_F28, C_F29, C_F30, C_F31, C_F32: 0.22uF; C_0402_1005Metric
C_FLT1: 10uF_100V; C_1812_4532Metric
C_SSR1: 100nF; C_0603_1608Metric
C_SSR2: 1uF; C_0805_2012Metric
C_TAN1: 100uF_16V; CP_EIA-6032-28_Kemet-C
D_BST1: Schottky; D_SOD-123
D_CHG1, D_CHG2, D_CHG3: DSK320; D_SOD-123F
D_GS1: PDZ16B; D_SOD-323
D_PRI1, D_PRI2, D_PRI3: D_Schottky; D_SOD-123
D_S1: TVS; D_SOD-123
D_SEC1, D_SEC2, D_SEC3: D_Schottky; D_SOD-123
F1: JT 15A; Fuse_2512_6332Metric
FB1: Unmarked; R_0603_1608Metric
J_BAT1: XT30PW-M (BAT); XT30PW-M_Lugs
J_CELL1: 0-8; JST_GH_BM10B-GHS-TBT_1x10-1MP_P1.25mm_Vertical
J_CELL2: 9-16; JST_GH_BM09B-GHS-TBT_1x09-1MP_P1.25mm_Vertical
J_CELL3: 17-24; JST_GH_BM08B-GHS-TBT_1x08-1MP_P1.25mm_Vertical
J_CELL4: 25-32; JST_GH_BM06B-GHS-TBT_1x06-1MP_P1.25mm_Vertical
J_CHG1: XT30PW-F (CHG); XT30PW-F_Lugs
J_COMM1: CAN/5V; JST_GH_BM04B-GHS-TBT_1x04-1MP_P1.25mm_Vertical
J_T1: T1; JST_GH_BM02B-GHS-TBT_1x02-1MP_P1.25mm_Vertical
J_T2: T2; JST_GH_BM02B-GHS-TBT_1x02-1MP_P1.25mm_Vertical
J_T3: T3; JST_GH_BM02B-GHS-TBT_1x02-1MP_P1.25mm_Vertical
J_T4: T4; JST_GH_BM02B-GHS-TBT_1x02-1MP_P1.25mm_Vertical
J_USB1: USB-C; USB_C_Receptacle_16P
L1: 180uH_181; L_7.3x7.3_H4.5
Q1: AGM15T03LL; TOLL-8_AGM15T03LL
R_B1, R_B2, R_B3, R_B4, R_B5, R_B6, R_B7, R_B8, R_B9, R_B10, R_B11, R_B12, R_B13, R_B14, R_B15, R_B16, R_B17, R_B18, R_B19, R_B20, R_B21, R_B22, R_B23, R_B24, R_B25, R_B26, R_B27, R_B28, R_B29, R_B30, R_B31, R_B32, R_B33: 27R0; R_0805_2012Metric
R_CHG1: 100k; R_0603_1608Metric
R_CHG2: 2203; R_0805_2012Metric
R_DSG1: 1000; R_0805_2012Metric
R_F1, R_F2, R_F3, R_F4, R_F5, R_F6, R_F7, R_F8, R_F9, R_F10, R_F11, R_F12, R_F13, R_F14, R_F15, R_F16, R_F17, R_F18, R_F19, R_F20, R_F21, R_F22, R_F23, R_F24, R_F25, R_F26, R_F27, R_F28, R_F29, R_F30, R_F31, R_F32: 20R; R_0402_1005Metric
R_G1: 01X; R_0603_1608Metric
R_GS1: 474; R_0603_1608Metric
R_S1, R_S2: 1000; R_0805_2012Metric
R_SEC1: 01X; R_0603_1608Metric
R_SH1, R_SH2: R001; R_2512_6332Metric
R_SSR1: 01X; R_0603_1608Metric
R_SSR2: 10k; R_0603_1608Metric
U4: LTC7138; Analog_MSOP-12-16-1EP_3x4.039mm_P0.5mm_EP1.651x2.845mm_Ther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
U7: ISO1050 (DUB-8); SMDIP-8_W9.53mm
U_BQ1: BQ7695202 (IC1); TQFP-48-1EP_7x7mm_P0.5mm_EP5x5mm_ThermalVias
U_BQ2: BQ7695202 (IC2); TQFP-48-1EP_7x7mm_P0.5mm_EP5x5mm_ThermalVias
U_ESP1: ESP32-C3-MINI-1
U_SSR1: GSRELAY; H2440_SSR

Connections:
5VExt: J_COMM1.4, U7.8
+3V3: BZ1.1, U7.1
BQ1_VC1: C_F1.1, C_F2.2, R_F32.2, U_BQ1.15
BQ1_VC2: C_F2.1, C_F3.2, R_F31.2, U_BQ1.14
BQ1_VC3: C_F3.1, C_F4.2, R_F30.2, U_BQ1.13
BQ1_VC4: C_F4.1, C_F5.2, R_F29.2, U_BQ1.12
BQ1_VC5: C_F5.1, C_F6.2, R_F28.2, U_BQ1.11
BQ1_VC6: C_F6.1, C_F7.2, R_F27.2, U_BQ1.10
BQ1_VC7: C_F7.1, C_F8.2, R_F26.2, U_BQ1.9
BQ1_VC8: C_F8.1, C_F9.2, R_F25.2, U_BQ1.8
BQ1_VC9: C_F9.1, C_F10.2, R_F24.2, U_BQ1.7
BQ1_VC10: C_F10.1, C_F11.2, R_F23.2, U_BQ1.6
BQ1_VC11: C_F11.1, C_F12.2, R_F22.2, U_BQ1.5
BQ1_VC12: C_F12.1, C_F13.2, R_F21.2, U_BQ1.4
BQ1_VC13: C_F13.1, C_F14.2, R_F20.2, U_BQ1.3
BQ1_VC14: C_F14.1, C_F15.2, R_F19.2, U_BQ1.2
BQ1_VC15: C_F15.1, C_F16.2, R_F18.2, U_BQ1.1
BQ1_VC16: C_F16.1, R_F17.2, U_BQ1.48
BQ2_VC1: C_F17.1, C_F18.2, R_F16.2, U_BQ2.15
BQ2_VC2: C_F18.1, C_F19.2, R_F15.2, U_BQ2.14
BQ2_VC3: C_F19.1, C_F20.2, R_F14.2, U_BQ2.13
BQ2_VC4: C_F20.1, C_F21.2, R_F13.2, U_BQ2.12
BQ2_VC5: C_F21.1, C_F22.2, R_F12.2, U_BQ2.11
BQ2_VC6: C_F22.1, C_F23.2, R_F11.2, U_BQ2.10
BQ2_VC7: C_F23.1, C_F24.2, R_F10.2, U_BQ2.9
BQ2_VC8: C_F24.1, C_F25.2, R_F9.2, U_BQ2.8
BQ2_VC9: C_F25.1, C_F26.2, R_F8.2, U_BQ2.7
BQ2_VC10: C_F26.1, C_F27.2, R_F7.2, U_BQ2.6
BQ2_VC11: C_F27.1, C_F28.2, R_F6.2, U_BQ2.5
BQ2_VC12: C_F28.1, C_F29.2, R_F5.2, U_BQ2.4
BQ2_VC13: C_F29.1, C_F30.2, R_F4.2, U_BQ2.3
BQ2_VC14: C_F30.1, C_F31.2, R_F3.2, U_BQ2.2
BQ2_VC15: C_F31.1, C_F32.2, R_F2.2, U_BQ2.1
BQ2_VC16: C_F32.1, R_F1.2, U_BQ2.48
CANH: J_COMM1.1, U7.7
CANL: J_COMM1.2, U7.6
CELL0: C_F1.2, J_BAT1.2, J_CELL1.10, R_SH1.1, U_BQ1.16
CELL1: J_CELL1.9, R_F32.1
CELL2: J_CELL1.8, R_F31.1
CELL3: J_CELL1.7, R_F30.1
CELL4: J_CELL1.6, R_F29.1
CELL5: J_CELL1.5, R_F28.1
CELL6: J_CELL1.4, R_F27.1
CELL7: J_CELL1.3, R_F26.1
CELL8: J_CELL1.2, R_F25.1
CELL9: J_CELL1.1, R_F24.1
CELL10: J_CELL2.9, R_F23.1
CELL11: J_CELL2.8, R_F22.1
CELL12: J_CELL2.7, R_F21.1
CELL13: J_CELL2.6, R_F20.1
CELL14: J_CELL2.5, R_F19.1
CELL15: J_CELL2.4, R_F18.1
CELL16: C_F17.2, J_CELL2.3, R_F17.1, U_BQ2.16
CELL17: J_CELL2.2, R_F16.1
CELL18: J_CELL2.1, R_F15.1
CELL19: J_CELL3.8, R_F14.1
CELL20: J_CELL3.7, R_F13.1
CELL21: J_CELL3.6, R_F12.1
CELL22: J_CELL3.5, R_F11.1
CELL23: J_CELL3.4, R_F10.1
CELL24: J_CELL3.3, R_F9.1
CELL25: J_CELL3.2, R_F8.1
CELL26: J_CELL3.1, R_F7.1
CELL27: J_CELL4.6, R_F6.1
CELL28: J_CELL4.5, R_F5.1
CELL29: J_CELL4.4, R_F4.1
CELL30: J_CELL4.3, R_F3.1
CELL31: J_CELL4.2, R_F2.1
CELL32: F1.1, J_BAT1.1, J_CELL4.1, R_F1.1, U_SSR1.6
CELL32_FUSED: F1.2, Q1.D
CHG+: D_GS1.2, J_CHG1.1, Q1.2, Q1.3, Q1.4, Q1.5, Q1.6, Q1.7, Q1.8, R_GS1.2
CHG-: J_CHG1.2, R_SH2.2
GND: C_SSR1.2, C_SSR2.2, J_T1.2, J_T2.2, J_T3.2, J_T4.2, R_SSR2.2, U7.4, U_BQ1.17, U_BQ2.17, U_SSR1.4
ISO_GND: J_COMM1.3, U7.5
Q1_GATE: D_GS1.1, Q1.1, R_G1.1, R_GS1.1, R_SSR1.2, R_SSR2.1
SHUNT_MID: R_SH1.2, R_SH2.1
SRN: U_BQ1.20, U_BQ2.20
SRP: U_BQ1.18, U_BQ2.18
SSR_OUT_CHG: R_G1.2, R_SSR1.1
TS1: J_T1.1, U_BQ1.21
TS2: J_T2.1, U_BQ1.22
TS3: J_T3.1, U_BQ1.23
TS4: J_T4.1, U_BQ2.21
VBOOST: C_SSR1.1, C_SSR2.1, U_SSR1.5
