Focerqc/QFBMS/(commit log)

2026-11-02 Extract QFBMS design with references and standalone dashboards
    [BMS029B(001)_BOM.xls, ESP32-C3-MINI-1.STEP, Fuse_2512_6332Metric.step, Meh ASM vbms STEP FILE.STEP, PR2410A(001)_BOM.xlsx, TOLL-8.step, USB-C.step, XT30PW-F.step]
2026-11-02 Add PLAN and firmware docs; update design rules
    Introduce an explicit charge-only build plan and firmware interface, and update design/README guidance to match it. Added PLAN.md, AGENTS.md, and docs/FIRMWARE_INTERFACE.md as the active build and software-compatibility baselines. Revised DESIGN_RULES.md, README.md, and .cursor/rules to emphasize a 32s charge-only objective, mechanical constraints (preserve connectors, R_B1–R_B33, BQ regions), and to instruct using the supplied VBMS32 firmware/package and TI guidance. Updated _reference/ti_bq76952/README.md to focus on TI references and stacked-monitor considerations. Marked docs/history/* files as superseded and clarified not to run archived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
2026-11-03 Record the November 3 plan and WP1 evidence checkpoint.
    Placement rules now match the no-heatsink decision, and the present board stays unchanged until the schematic is reconciled.
    [qfbms32-charge-only-draft.kicad_sch]
2026-11-04 grok 2 Update BQ monitor schematics and documentation for November 3, 2026. Adjusted UUIDs for various wires and pins across multiple schematic files. Enhanced documentation to clarify connections an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
    [qfbms32-bq-iso-i2c.kicad_sch, qfbms32-bq-lower.kicad_sch, qfbms32-bq-monitors.kicad_sch, qfbms32-bq-upper.kicad_sch]
2026-11-04 Add guarded BQ upper-bus disconnect
    [qfbms32-bq-iso-i2c.kicad_sch, qfbms32-bq-lower.kicad_sch, qfbms32-bq-monitors.kicad_sch, qfbms32-bq-upper.kicad_sch]
2026-11-04 Checkpoint monitor draft, firmware adaptation, dashboards and handoff
    [qfbms32-bq-iso-i2c.kicad_sch, qfbms32-bq-lower.kicad_sch, qfbms32-bq-monitors.kicad_sch, qfbms32-bq-upper.kicad_sch]
2026-11-04 Open the lower monitor bus at the unqualified power boundary
    [qfbms32-bq-lower.kicad_sch, qfbms32-bq-monitors.kicad_sch, qfbms32-bq-upper.kicad_sch]
2026-11-04 Add combined system schematic preview to PCB dashboard
2026-11-04 Draft independent host startup, lower monitor bus and local wake paths
    [qfbms32-bq-iso-i2c.kicad_sch, qfbms32-bq-lower.kicad_sch, qfbms32-bq-monitors.kicad_sch, qfbms32-bq-upper.kicad_sch]
2026-11-04 Remove the separate discharge output FET and verify retained board geometry
    [qfbms32.kicad_pcb]
2026-11-04 Split monitor startup circuitry onto a separate A3 sheet
    [qfbms32-bq-lower.kicad_sch, qfbms32-bq-monitors.kicad_sch, qfbms32-bq-startup.kicad_sch, qfbms32-bq-upper.kicad_sch]
2026-11-04 Record reference-by-reference dispositions and outstanding electrical decisions
    [component-ledger.csv]
2026-11-05 Make Board Boxes the hosted dashboard and move overview to News
2026-11-05 feat: add charge-control hardware design, PCB dashboard, and review documentation
    [bom.csv, charge-control.kicad_sch, driver.kicad_sch, permission.kicad_sch, power.kicad_sch, sensing.kicad_sch]
